juliannof/AITEC-17/docs/RS485_P4.md

# RS485 P4 — Bus A Master (ESP32-P4)

> ⚠️ **Pinout localizado, PENDIENTE de testear en banco** (2026-07-30) — ver §1.2. `config.h` todavía tiene los valores heredados de la placa antigua, sin actualizar.

Documentación del subsistema RS485 en P4. Bus A controla hasta 9 slaves S2 locales (IDs 1–9) — el usuario ya conectó físicamente los 9×S2 al bus A.

**Responsable:** iMakie Development Team  
**Última actualización:** 2026-07-30  
**Estado:** ⚠️ Pinout real localizado (sin testear), código sin adaptar — `rs485.startTask()` no llamada en setup (ver CHANGELOG pendientes)

---

## 1. HARDWARE RS485 P4

### 1.1 Especificación Bus A

| Parámetro | Valor |
|---|---|
| **Baudrate** | 500 kbaud |
| **Protocolo** | Binario custom CRC8 |
| **Topología** | Star — P4 master, 9 slaves S2 (IDs 1–9) |
| **Transceiver** | Externo (no integrado en P4) |
| **Timeout** | 1000ms sin RX → flag NOT_CALIBRATED |

### 1.2 Pinout P4

> ✅ **Localizado en hardware real (2026-07-30): A = GPIO26, B = GPIO27.** Confirmado que GPIO27 NO coincide con `LCD_RST_PIN` (también 27 en `config.h`, pero es un GPIO distinto del ESP32-P4 — la coincidencia numérica era del conector/serigrafía, no del chip). **Pendiente: testear comunicación real en banco** — la localización es correcta pero aún no se ha probado un ciclo TX/RX completo con un S2.
>
> `config.h` **todavía no se ha actualizado** con estos valores — sigue con `RS485_TX_PIN=52 / RX=51 / EN=50` heredados de la placa antigua JC4880P433C. Cambio de código pendiente de sesión propia (regla CLAUDE.md: validación en banco antes de tocar RS485).
>
> **Transceiver auto-direccional — sin pin DE/RE:** a diferencia del bus B (S3), donde el transceiver necesita `RS485_ENABLE_PIN` para conmutar TX/RX por software, el transceiver de la JC1060P470C conmuta la dirección automáticamente. El código actual de `P4/RS485.cpp` (`begin()`, `_sendPacket()`) usa `RS485_ENABLE_PIN` en 4 puntos — habrá que adaptarlo para no tocar ningún pin de enable en el bus A cuando se porte el pinout real (el bus B en S3 no se toca, sigue necesitando su enable).

```
RS485 (Bus A) — pinout localizado, sin testear (2026-07-30):
  A = GPIO26
  B = GPIO27
  (sin pin DE/RE — transceiver auto-direccional)

config.h actual (sin actualizar, heredado de placa antigua):
  TX = GPIO52  (RS485_TX_PIN)
  RX = GPIO51  (RS485_RX_PIN)
  EN = GPIO50  (RS485_ENABLE_PIN) — a eliminar cuando se porte el pinout real
```

**Diferencia vs Bus B (S3):**
- Bus A: hasta 9 slaves (P4 master) — `NUM_SLAVES=0` en config.h pendiente de ajuste, pinout localizado sin testear, sin pin de enable (auto-direccional)
- Bus B: 8 slaves (S3 Extender master), con `RS485_ENABLE_PIN` propio
- Ambos: 500 kbaud, mismo protocolo binario

---

## 2. PROTOCOLO

### 2.1 MasterPacket (P4 → S2)

```cpp
struct MasterPacket {
    uint8_t start_byte;           // 0xAA
    uint8_t slave_id;             // 1-9 (bus A)
    char track_name[8];           // Nombre track
    uint16_t fader_target;        // Target ADC (0-27000)
    uint8_t vu_level;             // VU level
    uint8_t flags;                // CALIB, REC, SOLO, MUTE, SELECT
    uint8_t crc8;                 // CRC8 (poly 0x07)
};
```

### 2.2 SlavePacket (S2 → P4)

```cpp
struct SlavePacket {
    uint8_t start_byte;           // 0xBB
    uint8_t slave_id;             // 1-9
    uint16_t fader_pos;           // Posición actual ADC
    uint8_t buttons;              // Bits 0-3: REC/SOLO/MUTE/SELECT
    int8_t encoder_delta;         // Encoder delta
    uint8_t encoder_button;       // Encoder push
    uint8_t flags;                // CALIB_DONE, CALIB_SENDING, etc
    uint8_t crc8;                 // CRC8
};
```

---

## 3. TIMING BUS A

### 3.1 Ciclo 20ms

```
T=0ms:      P4 envía MasterPacket a S2-1 (ID=1)
T≈150µs:    S2-1 envía SlavePacket
T=600µs:    P4 envía MasterPacket a S2-2 (ID=2)
T≈750µs:    S2-2 envía SlavePacket
...
T≈13.2ms:   P4 envía MasterPacket a S2-9 (ID=9)
T≈13.35ms:  S2-9 envía SlavePacket
T≈20ms:     Ciclo repite
```

**Timing critical:**
- TX_EN: 30µs
- RESP_TIMEOUT: 3000µs (3ms)
- GAP entre slaves: 300µs
- POLL_CYCLE: ~20ms

---

## 4. DIFERENCIAS BUS A vs BUS B

| Aspecto | Bus A (P4) | Bus B (S3) |
|---|---|---|
| **GPIO TX** | 52 (sin confirmar) | 15 |
| **GPIO RX** | 51 (sin confirmar) | 16 |
| **GPIO EN** | 50 (sin confirmar) | 1 |
| **Slaves** | 9 objetivo (NUM_SLAVES=0 actual) | 8 (IDs 1–8) |
| **Baudrate** | 500 kbaud | 500 kbaud |
| **Protocolo** | Mismo binario CRC8 | Mismo binario CRC8 |
| **Master** | P4 | S3 Extender |

**Ventaja arquitectónica:** 
- Dos buses independientes → mayor throughput total
- P4 + S3 ambos son masters (no jerarquía)
- Cada bus maneja sus 9/8 slaves sin interferencia

---

## 5. TROUBLESHOOTING

### 5.1 Síntomas Comunes

| Síntoma | Causa Probable | Verificación |
|---|---|---|
| RS485 no comunica | GPIO TX/RX/EN no configurados | Verificar setup P4 UART2 |
| Timeouts frecuentes | Cable RS485 cortado o soldadura floja | Verificar continuidad A/B |
| CRC8 errors | Ruido en línea | Verificar terminación 120Ω |
| Un slave no responde | S2 offline o RS485 chip defectuoso | Test con multimetro |
| Todos los slaves timeout | Master P4 no envía | Verificar UART TX pin |

### 5.2 Debugging

**Logs esperados — ciclo normal:**
```
[RS485-A] TX MasterPacket a S2-1
[RS485-A] RX SlavePacket desde S2-1 (faderPos=1234)
[RS485-A] TX MasterPacket a S2-2
[RS485-A] RX SlavePacket desde S2-2 (faderPos=5678)
...
[RS485-A] Ciclo completado (9 slaves, 20ms)
```

---

## 6. REFERENCIAS

- **RS485.md** — Protocolo binario completo (aplica ambos buses)
- **S3 RS485.md** — Bus B (S3 Extender), diferencias anotadas
- **P4 README:** [MASTER_S3-P4/P4/README.md](../MASTER_S3-P4/P4/README.md)
- **STATUS.md** — Bugs conocidos P4/Bus A

---

## Últimas Actualizaciones

- **(2026-06-11)** Advertencia pines pendientes, NUM_SLAVES corrección, estado del subsistema actualizado
- **(2026-05-16)** Creado RS485_P4.md como documento Bus A-específico, extraído de CLAUDE.md
