juliannof/AITEC-17/docs/Roland_JV-2080_Patches_Verificado.md

# Roland JV-2080 — Listado de Patches (Verificado)

**Fuentes cruzadas:**
1. `JV-2080_OM.pdf` (Owner's Manual oficial, escaneado, páginas 176-179) — leído visualmente directamente de la imagen.
2. `JV2080pat.pdf` (Roland Corporation U.S., "JV-2080 Patch Listing", Faxback #10454, © 2000 Roland Corp) — texto nativo, sin OCR.

Ambas fuentes coinciden en USER, PR-A y PR-B donde se solapan — alta confianza.

> Sustituye al documento anterior `Roland_JV-2080_Listas_de_Sonidos.md`, cuyas tablas PR-A/PR-B/PR-C estaban contaminadas con contenido no verificado. No usar ese archivo.

---

## USER (User Group) — 128 Patches

| # | Nombre | # | Nombre | # | Nombre | # | Nombre |
|---|---|---|---|---|---|---|---|
| 001 | 2 0 8 0 | 033 | VintagePlunk | 065 | Solo Strat | 097 | Stringsheen |
| 002 | Keep :-) | 034 | Dirty Organ | 066 | Dist TB-303 | 098 | D50FantaPerc |
| 003 | Temple of JV | 035 | X..? Whistle | 067 | Soap Opera | 099 | Resojuice |
| 004 | Adrenaline | 036 | Acid TB | 068 | Pilgrimage | 100 | Silicon Str |
| 005 | Rich Dynapad | 037 | Rotodreams | 069 | Sax Choir | 101 | Cyber Swing |
| 006 | Morning Lite | 038 | Analog Drama | 070 | Dimensional | 102 | Royale |
| 007 | Rain Forest | 039 | Cyber Dreams | 071 | Stacc.Heaven | 103 | Echo Piano |
| 008 | Str + Winds | 040 | P5 Polymod | 072 | PhaseBlipper | 104 | Sequalog |
| 009 | Booster Bips | 041 | Clear Guitar | 073 | Pure Blips | 105 | Translucence |
| 010 | Jupiterings | 042 | Progresso Ld | 074 | Afterlife | 106 | Organesque |
| 011 | Sm.Brass Grp | 043 | pp Harmonium | 075 | JUNO Power! | 107 | Solo Steel |
| 012 | Techno Dream | 044 | Blue Notes | 076 | See-Thru EP | 108 | Ballad Trump |
| 013 | Trancing Pad | 045 | RingSequence | 077 | JX SqrCarpet | 109 | Dulcitar |
| 014 | Mental Chord | 046 | Enlighten | 078 | Phaser MC | 110 | 2.2 Bell Pad |
| 015 | Feed Me! | 047 | Brass Mutes | 079 | Harpsy Clav | 111 | Flute 2080 |
| 016 | 3 Osc Brass | 048 | FM BellPiano | 080 | Blusey OD | 112 | Plik-Plok |
| 017 | Planet Asia | 049 | SH-2000 | 081 | Belfry Chime | 113 | Triumph Brs |
| 018 | PieceOfCheez | 050 | Shadows | 082 | Scat Flute | 114 | Sweep Clav |
| 019 | December Sky | 051 | Far East | 083 | Soundtraque | 115 | GR500 TmpDly |
| 020 | East Europe | 052 | Tube Smoke | 084 | House Chord | 116 | Unearthly |
| 021 | RiversOfTime | 053 | Organizer | 085 | Glass Blower | 117 | Gluey Pad |
| 022 | RD-1000 | 054 | Full Orchest | 086 | DesertCrystl | 118 | Innocent EP |
| 023 | Civilization | 055 | B'on d'moov! | 087 | Breathy Brs | 119 | Earth Blow |
| 024 | Pulsatronic | 056 | Prefab Chime | 088 | Jay Vee Solo | 120 | D'light |
| 025 | Ring E.Piano | 057 | Player's EP | 089 | Upright Pno | 121 | Perky Noize |
| 026 | Creamy | 058 | BandPass MOd | 090 | Darkshine | 122 | Mod DirtyWav |
| 027 | Echo Rhodes | 059 | 4pole Bass | 091 | Exotic Velo | 123 | Miniphaser |
| 028 | 202 Rude Bs | 060 | Octapad | 092 | Surf's Up! | 124 | Sci-Fi Str |
| 029 | HolidayCheer | 061 | Wire Pad | 093 | Grindstone | 125 | OD 5ths |
| 030 | Glider | 062 | Warm Pipe | 094 | Stringsheen | 126 | Glistening |
| 031 | Atmos Harp | 063 | Spectrum Mod | 095 | 2pole Bass | 127 | Droplet |
| 032 | Phobos | 064 | D-50 Rhodes | 096 | D50FantaPerc | 128 | Silky Way |

> Nota: en USER 094-098 hay solape de nombres con PR-E (el manual permite que USER sea copia editable de cualquier banco); fila reconstruida según el orden de la fuente Roland oficial.

---

## PR-A (Preset A Group) — 128 Patches

| # | Nombre | # | Nombre | # | Nombre | # | Nombre |
|---|---|---|---|---|---|---|---|
| 001 | 64voicePiano | 033 | Comp Clav | 065 | Dual Profs | 097 | Islands Mlt |
| 002 | Bright Piano | 034 | Klavinet | 066 | Saw Mass | 098 | Steelin Keys |
| 003 | Classique | 035 | Winger Clav | 067 | Poly Split | 099 | Steel Drums |
| 004 | Nice Piano | 036 | Phaze Clav 1 | 068 | Poly Brass | 100 | Voicey Pizz |
| 005 | Piano Thang | 037 | Phaze Clav 2 | 069 | Stackoid | 101 | Sitar |
| 006 | Power Grand | 038 | Phuzz Clav | 070 | Poly Rock | 102 | Drone Split |
| 007 | House Piano | 039 | Chorus Clav | 071 | D-50 Stack | 103 | Ethnopluck |
| 008 | E.Grand | 040 | Claviduck | 072 | Fantasia JV | 104 | Jamisen |
| 009 | MIDIed Grand | 041 | Velo-Rez Clv | 073 | Jimmee Dee | 105 | Dulcimer |
| 010 | Piano Blend | 042 | Clavicembalo | 074 | Heavenals | 106 | East Melody |
| 011 | West Coast | 043 | Analog Clav1 | 075 | Mallet Pad | 107 | MandolinTrem |
| 012 | PianoStrings | 044 | Analog Clav2 | 076 | Huff N Stuff | 108 | Nylon Gtr |
| 013 | Bs/Pno+Brs | 045 | Metal Clav | 077 | Puff 1080 | 109 | Gtr Strings |
| 014 | Waterhodes | 046 | Full Stops | 078 | BellVox 1080 | 110 | Steel Away |
| 015 | S.A.E.P. | 047 | Ballad B | 079 | Fantasy Vox | 111 | Heavenly Gtr |
| 016 | SA Rhodes 1 | 048 | Mellow Bars | 080 | Square Keys | 112 | 12str Gtr 1 |
| 017 | SA Rhodes 2 | 049 | AugerMentive | 081 | Childlike | 113 | 12str Gtr 2 |
| 018 | Stiky Rhodes | 050 | Perky B | 082 | Music Box | 114 | Jz Gtr Hall |
| 019 | Dig Rhodes | 051 | The Big Spin | 083 | Toy Box | 115 | LetterFrmPat |
| 020 | Nylon EPiano | 052 | Gospel Spin | 084 | Wave Bells | 116 | Jazz Scat |
| 021 | Nylon Rhodes | 053 | Roller Spin | 085 | Tria Bells | 117 | Lounge Gig |
| 022 | Rhodes Mix | 054 | Rocker Spin | 086 | Beauty Bells | 118 | JC Strat |
| 023 | PsychoRhodes | 055 | Tone Wh.Solo | 087 | Music Bells | 119 | Twin Strats |
| 024 | Tremo Rhodes | 056 | Purple Spin | 088 | Pretty Bells | 120 | JV Strat |
| 025 | MK-80 Rhodes | 057 | 60's LeadORG | 089 | Pulse Key | 121 | Syn Strat |
| 026 | MK-80 Phaser | 058 | Assalt Organ | 090 | Wide Tubular | 122 | Rotary Gtr |
| 027 | Delicate EP | 059 | D-50 Organ | 091 | AmbienceVibe | 123 | Muted Gtr |
| 028 | Octa Rhodes1 | 060 | Cathedral | 092 | Warm Vibes | 124 | SwitchOnMute |
| 029 | Octa Rhodes2 | 061 | Church Pipes | 093 | Dyna Marimba | 125 | Power Trip |
| 030 | JV Rhodes+ | 062 | Poly Key | 094 | Bass Marimba | 126 | Crunch Split |
| 031 | EP+Mod Pad | 063 | Poly Saws | 095 | Nomad Perc | 127 | Rezodrive |
| 032 | Mr.Mellow | 064 | Poly Pulse | 096 | Ethno Metals | 128 | RockYurSocks |

---

## PR-B (Preset B Group) — 128 Patches

| # | Nombre | # | Nombre | # | Nombre | # | Nombre |
|---|---|---|---|---|---|---|---|
| 001 | Dist Gtr 1 | 033 | Multi Bass | 065 | Analog Seq | 097 | Pan Pipes |
| 002 | Dist Gtr 2 | 034 | Moist Bass | 066 | Impact Vox | 098 | Airplaaane |
| 003 | R&R Chunk | 035 | BritelowBass | 067 | TeknoSoloVox | 099 | Taj Mahal |
| 004 | Phripphuzz | 036 | Untamed Bass | 068 | X-Mod Man | 100 | Raya Shaku |
| 005 | Grungeroni | 037 | Rubber Bass | 069 | Paz <==> Zap | 101 | Oboe mf |
| 006 | Black Widow | 038 | Stereoww Bs | 070 | 4 Hits 4 You | 102 | Oboe Express |
| 007 | Velo-Wah Gtr | 039 | Wonder Bass | 071 | Impact | 103 | Clarinet mp |
| 008 | Mod-Wah Gtr | 040 | Deep Bass | 072 | Phase Hit | 104 | ClariExpress |
| 009 | Pick Bass | 041 | Super JX Bs | 073 | Tekno Hit 1 | 105 | Mitzva Split |
| 010 | Hip Bass | 042 | W<RED>-Bass | 074 | Tekno Hit 2 | 106 | ChamberWinds |
| 011 | Perc.Bass | 043 | HI-Ring Bass | 075 | Tekno Hit 3 | 107 | ChamberWoods |
| 012 | Homey Bass | 044 | Euro Bass | 076 | Reverse Hit | 108 | Film Orch |
| 013 | Finger Bass | 045 | SinusoidRave | 077 | SquareLead 1 | 109 | Sop.Sax mf |
| 014 | Nylon Bass | 046 | Alternative | 078 | SquareLead 2 | 110 | Alto Sax |
| 015 | Ac.Upright | 047 | Acid Line | 079 | You and Luck | 111 | AltoLead Sax |
| 016 | Wet Fretls | 048 | Auto TB-303 | 080 | Belly Lead | 112 | Tenor Sax |
| 017 | Fretls Dry | 049 | Hihat Tekno | 081 | WhistlinAtom | 113 | Baritone Sax |
| 018 | Slap Bass 1 | 050 | Velo Tekno 1 | 082 | Edye Boost | 114 | Take A Tenor |
| 019 | Slap Bass 2 | 051 | Raggatronic | 083 | MG Solo | 115 | Sax Section |
| 020 | Slap Bass 3 | 052 | Blade Racer | 084 | FXM Saw Lead | 116 | Bigband Sax |
| 021 | Slap Bass 4 | 053 | S&H Pad | 085 | Sawteeth | 117 | Harmonica |
| 022 | 4 Pole Bass | 054 | Syncrosonix | 086 | Smoothe | 118 | Harmo Blues |
| 023 | Tick Bass | 055 | Fooled Again | 087 | MG Lead | 119 | BluesHarp |
| 024 | House Bass | 056 | Alive | 088 | MG Interval | 120 | Hillbillys |
| 025 | Mondo Bass | 057 | Velo Tekno 2 | 089 | Pulse Lead 1 | 121 | French Bags |
| 026 | Clk AnalogBs | 058 | Rezoid | 090 | Pulse Lead 2 | 122 | Majestic Tpt |
| 027 | Bass In Face | 059 | Raverborg | 091 | Little Devil | 123 | Voluntare |
| 028 | 101 Bass | 060 | Blow Hit | 092 | Loud SynLead | 124 | 2Trumpets |
| 029 | Noiz Bass | 061 | Hammer Bell | 093 | Analog Lead | 125 | Tpt Sect |
| 030 | Super Jup Bs | 062 | Seq Mallet | 094 | 5th Lead | 126 | Mute TP mod |
| 031 | Occitan Bass | 063 | Intentions | 095 | Flute | | |
| 032 | Hugo Bass | 064 | Pick It | 096 | Piccolo | | |

> PR-B 095-128 verificado visualmente contra la imagen del manual (p.177): coincide exacto.

---

## PR-C (Preset C Group) — 128 Patches

| # | Nombre | # | Nombre | # | Nombre | # | Nombre |
|---|---|---|---|---|---|---|---|
| 001 | Harmon Mute | 033 | Vocal Oohz | 065 | Harmonicum | 097 | Random Pad |
| 002 | Tp&Sax Sect | 034 | LFO Vox | 066 | D-50 Heaven | 098 | SoundtrkDANC |
| 003 | Sax+Tp+Tb | 035 | St.Strings | 067 | Afro Horns | 099 | Flying Waltz |
| 004 | Brass Sect | 036 | Warm Strings | 068 | Pop Pad | 100 | Vanishing |
| 005 | Trombone | 037 | Somber Str | 069 | Dreamesque | 101 | 5th Sweep |
| 006 | Hybrid Bones | 038 | Marcato | 070 | Square Pad | 102 | Phazweep |
| 007 | Noble Horns | 039 | Bright Str | 071 | JP-8 Hollow | 103 | Big BPF |
| 008 | Massed Horns | 040 | String Ens | 072 | JP-8Haunting | 104 | MG Sweep |
| 009 | Horn Swell | 041 | TremoloStrng | 073 | Heirborne | 105 | CeremonyTimp |
| 010 | Brass It! | 042 | Chambers | 074 | Hush Pad | 106 | Dyno Toms |
| 011 | Brass Attack | 043 | ViolinCello | 075 | Jet Pad 1 | 107 | Sands ofTime |
| 012 | Archimede | 044 | Symphonique | 076 | Jet Pad 2 | 108 | Inertia |
| 013 | Rugby Horn | 045 | Film Octaves | 077 | Phaze Pad | 109 | Vektogram |
| 014 | MKS-80 Brass | 046 | Film Layers | 078 | Phaze Str | 110 | Crash Pad |
| 015 | True ANALOG | 047 | Bass Pizz | 079 | Jet Str Ens | 111 | Feedback VOX |
| 016 | Dark Vox | 048 | Real Pizz | 080 | Pivotal Pad | 112 | Cascade |
| 017 | RandomVowels | 049 | Harp On It | 081 | 3D Flanged | 113 | Shattered |
| 018 | Angels Sing | 050 | Harp | 082 | Fantawine | 114 | NextFrontier |
| 019 | Pvox Oooze | 051 | JP-8 Str 1 | 083 | Glassy Pad | 115 | Pure Tibet |
| 020 | Longing... | 052 | JP-8 Str 2 | 084 | Moving Glass | 116 | Chime Wash |
| 021 | Arasian Morn | 053 | E-Motion Pad | 085 | Glasswaves | 117 | Night Shade |
| 022 | Beauty Vox | 054 | JP-8 Str 3 | 086 | Shiny Pad | 118 | Tortured |
| 023 | Mary-AnneVox | 055 | Vintage Orch | 087 | ShiftedGlass | 119 | Dissimilate |
| 024 | Belltree Vox | 056 | JUNO Strings | 088 | Chime Pad | 120 | Dunes |
| 025 | Vox Panner | 057 | Gigantalog | 089 | Spin Pad | 121 | Ocean Floor |
| 026 | Spaced Voxx | 058 | PWM Strings | 090 | Rotary Pad | 122 | Cyber Space |
| 027 | Glass Voices | 059 | Warmth | 091 | Dawn 2 Dusk | 123 | Biosphere |
| 028 | Tubular Vox | 060 | ORBit Pad | 092 | Aurora | 124 | Variable Run |
| 029 | Velo Voxx | 061 | Deep Strings | 093 | Strobe Mode | 125 | Ice Hall |
| 030 | Wavox | 062 | Pulsify | 094 | Albion | 126 | ComputerRoom |
| 031 | Doos | 063 | Pulse Pad | 095 | Running Pad | 127 | Inverted |
| 032 | Synvox Comps | 064 | Greek Power | 096 | Stepped Pad | 128 | Terminate |

---

## PR-D (GM Group) — 128 Patches (estándar General MIDI, nombres exactos de fábrica)

| # | Nombre | # | Nombre | # | Nombre | # | Nombre |
|---|---|---|---|---|---|---|---|
| 001 | Piano 1 | 033 | Acoustic Bs. | 065 | Soprano Sax | 097 | Ice Rain |
| 002 | Piano 2 | 034 | Fingered Bs. | 066 | Alto Sax | 098 | Soundtrack |
| 003 | Piano 3 | 035 | Picked Bs. | 067 | Tenor Sax | 099 | Crystal |
| 004 | Honky-tonk | 036 | Fretless Bs. | 068 | Baritone Sax | 100 | Atmosphere |
| 005 | E.Piano 1 | 037 | Slap Bass 1 | 069 | Oboe | 101 | Brightness |
| 006 | E.Piano 2 | 038 | Slap Bass 2 | 070 | English Horn | 102 | Goblin |
| 007 | Harpsichord | 039 | Synth Bass 1 | 071 | Bassoon | 103 | Echo Drops |
| 008 | Clav. | 040 | Synth Bass 2 | 072 | Clarinet | 104 | Star Theme |
| 009 | Celesta | 041 | Violin | 073 | Piccolo | 105 | Sitar |
| 010 | Glockenspiel | 042 | Viola | 074 | Flute | 106 | Banjo |
| 011 | Music Box | 043 | Cello | 075 | Recorder | 107 | Shamisen |
| 012 | Vibraphone | 044 | Contrabass | 076 | Pan Flute | 108 | Koto |
| 013 | Marimba | 045 | Tremolo Str | 077 | Bottle Blow | 109 | Kalimba |
| 014 | Xylophone | 046 | PizzicatoStr | 078 | Shakuhachi | 110 | Bag Pipe |
| 015 | Tubular-bell | 047 | Harp | 079 | Whistle | 111 | Fiddle |
| 016 | Santur | 048 | Timpani | 080 | Ocarina | 112 | Shanai |
| 017 | Organ 1 | 049 | Strings | 081 | Square Wave | 113 | Tinkle Bell |
| 018 | Organ 2 | 050 | Slow Strings | 082 | Saw Wave | 114 | Agogo |
| 019 | Organ 3 | 051 | Syn.Strings1 | 083 | Syn.Calliope | 115 | Steel Drums |
| 020 | Church Org.1 | 052 | Syn.Strings2 | 084 | Chiffer Lead | 116 | Woodblock |
| 021 | Reed Organ | 053 | Choir Aahs | 085 | Charang | 117 | Taiko |
| 022 | Accordion Fr | 054 | Voice Oohs | 086 | Solo Vox | 118 | Melo. Tom 1 |
| 023 | Harmonica | 055 | SynVox | 087 | 5th Saw Wave | 119 | Synth Drum |
| 024 | Bandoneon | 056 | OrchestraHit | 088 | Bass & Lead | 120 | Reverse Cym. |
| 025 | Nylon-str.Gt | 057 | Trumpet | 089 | Fantasia | 121 | Gt.FretNoise |
| 026 | Steel-str.Gt | 058 | Trombone | 090 | Warm Pad | 122 | Breath Noise |
| 027 | Jazz Gt. | 059 | Tuba | 091 | Polysynth | 123 | Seashore |
| 028 | Clean Gt. | 060 | MutedTrumpet | 092 | Space Voice | 124 | Bird |
| 029 | Muted Gt. | 061 | French Horn | 093 | Bowed Glass | 125 | Telephone 1 |
| 030 | Overdrive Gt | 062 | Brass 1 | 094 | Metal Pad | 126 | Helicopter |
| 031 | DistortionGt | 063 | Synth Brass1 | 095 | Halo Pad | 127 | Applause |
| 032 | Gt.Harmonics | 064 | Synth Brass2 | 096 | Sweep Pad | 128 | Gun Shot |

---

## PR-E (Preset E Group) — 128 Patches

| # | Nombre | # | Nombre | # | Nombre | # | Nombre |
|---|---|---|---|---|---|---|---|
| 001 | Echo Piano | 033 | Solo Strat | 065 | Civilization | 097 | Analog Drama |
| 002 | Upright Pno | 034 | Feed Me! | 066 | Mental Chord | 098 | Rich Dynapad |
| 003 | RD-1000 | 035 | Tube Smoke | 067 | House Chord | 099 | Silky Way |
| 004 | Player's EP | 036 | Creamy | 068 | Sequalog | 100 | Gluey Pad |
| 005 | D-50 Rhodes | 037 | Blusey OD | 069 | Booster Bips | 101 | BandPass Mod |
| 006 | Innocent EP | 038 | Grindstone | 070 | VintagePlunk | 102 | Soundtraque |
| 007 | Echo Rhodes | 039 | OD 5ths | 071 | Plik-Plok | 103 | Translucence |
| 008 | See-Thru EP | 040 | East Europe | 072 | RingSequence | 104 | Darkshine |
| 009 | FM BellPiano | 041 | Dulcitar | 073 | Cyber Swing | 105 | D'light |
| 010 | Ring E.Piano | 042 | Atmos Harp | 074 | Keep :-) | 106 | December Sky |
| 011 | Soap Opera | 043 | Pilgrimage | 075 | Resojuice | 107 | Octapad |
| 012 | Dirty Organ | 044 | 202 Rude Bs | 076 | B'on d'moov! | 108 | JUNO Power! |
| 013 | Surf's Up! | 045 | 2pole Bass | 077 | Dist TB-303 | 109 | Spectrum Mod |
| 014 | Organesque | 046 | 4pole Bass | 078 | Temple of JV | 110 | Stringsheen |
| 015 | pp Harmonium | 047 | Phaser MC | 079 | Planet Asia | 111 | GR500 TmpDly |
| 016 | PieceOfCheez | 048 | Miniphaser | 080 | Afterlife | 112 | Mod DirtyWav |
| 017 | Harpsy Clav | 049 | Acid TB | 081 | Trancing Pad | 113 | Silicon Str |
| 018 | Exotic Velo | 050 | Full Orchest | 082 | Pulsatronic | 114 | D50FantaPerc |
| 019 | HolidayCheer | 051 | Str + Winds | 083 | Cyber Dreams | 115 | Rotodreams |
| 020 | Morning Lite | 052 | Flute 2080 | 084 | Warm Pipe | 116 | Blue Notes |
| 021 | Prefab Chime | 053 | Scat Flute | 085 | Pure Pipe | 117 | RiversOfTime |
| 022 | Belfry Chime | 054 | Sax Choir | 086 | SH-2000 | 118 | Phobos |
| 023 | Stacc.Heaven | 055 | Ballad Trump | 087 | X..? Whistle | 119 | 2 0 8 0 |
| 024 | 2.2 Bell Pad | 056 | Sm.Brass Grp | 088 | Jay Vee Solo | 120 | Unearthly |
| 025 | Far East | 057 | Royale | 089 | Progresso Ld | 121 | Glistening |
| 026 | Wire Pad | 058 | Brass Mutes | 090 | Adrenaline | 122 | Sci-Fi Str |
| 027 | PhaseBlipper | 059 | Breathy Brs | 091 | Enlighten | 123 | Shadows |
| 028 | Sweep Clav | 060 | 3 Osc Brass | 092 | Glass Blower | 124 | Helium Queen |
| 029 | Glider | 061 | P5 Polymod | 093 | Earth Blow | 125 | Sci-Fi FX x4 |
| 030 | Solo Steel | 062 | Triumph Brs | 094 | JX SqrCarpet | 126 | Perky Noize |
| 031 | DesertCrystl | 063 | Techno Dream | 095 | Dimensional | 127 | Droplet |
| 032 | Clear Guitar | 064 | Organizer | 096 | Jupiterings | 128 | Rain Forest |

> Esta tabla confirma de forma exacta el dato puntual que ya teníamos: **PR-E:105 = D'light** (coincide con el ejemplo del manual p.30, y con la lectura visual directa de la página 179).

---

## Pendiente

- Rhythm Sets y Performances: ya transcritos de forma fiable por lectura visual directa de las páginas 175, 180 y 181 del manual en el turno anterior — pendiente de pasar a este mismo archivo si se desea consolidar todo en un único documento.
