juliannof/AITEC-17/MASTER_S3-P4/P4_JC1060P470C/src/config.h

// include/config.h — P4 versión mínima
#pragma once
#include <Arduino.h>

// ====================================================================
// CONFIGURACIÓN AUTOMÁTICA SEGÚN DISPOSITIVO
// ====================================================================
#if defined(DEVICE_P4_MASTER)
    #define DEVICE_FAMILY       0x14
    #define VERSION_REPLY_CMD   0x14
    #define NUM_SLAVES          6


#elif defined(DEVICE_S3_EXTENDER)
    #define DEVICE_FAMILY       0x15
    #define VERSION_REPLY_CMD   0x15
    #define NUM_SLAVES          1

#else
    #error "DEBE DEFINIR: DEVICE_P4_MASTER o DEVICE_S3_EXTENDER en platformio.ini build_flags"
#endif



// --- RS485 pines P4 ---
#define RS485_TX_PIN      3
#define RS485_RX_PIN      4
#define RS485_ENABLE_PIN  5
#define RS485_BAUD       500000

// ── Enlace serie P4↔S3 (Serial2, independiente del RS485 propio) (2026-08-16) ──
// TX/RX intercambiados (2026-08-16 20:31) respecto al plan original — el cable
// físico ya tendido conecta al revés; se corrige en firmware, no en hardware.
#define S3LINK_TX_PIN         1
#define S3LINK_RX_PIN         2
#define S3LINK_BAUD           115200
#define S3LINK_HEARTBEAT_MS   500
#define S3LINK_TIMEOUT_MS     1500

// ── Display JD9165 (MIPI-DSI, 1024×600 landscape nativo) (2026-06-09) ──
#define LCD_RST_PIN    27
#define LCD_BL_PIN     23
#define SPLASH_BRIGHTNESS_PERCENT  20   // Brillo reducido durante splash/offline (2026-08-19)
#define SPLASH_SCREEN_OFF_MS  120000    // Apaga backlight tras 2 min inactivo en splash (2026-08-19)

// ── Touch GT911 (I2C) — como la placa pequeña: RST/INT en NC (2026-06-09) ──
#define TOUCH_INT_PIN  -1
#define TOUCH_RST_PIN  -1
#define TOUCH_SDA_PIN  7
#define TOUCH_SCL_PIN  8
#define TOUCH_I2C_ADDR 0x5D

// NOTA: la JC1060P470C NO lleva NeoTrellis (defines TRELLIS_* eliminados 2026-06-09)

// ── Elevador de pantalla (motor N20 + DRV8833, EN/nSLEEP fijo a 5V por HW,
// sin GPIO de control; sin encoder/ADC — no hay lazo cerrado) (2026-09-12) ──
#define MOTOR_IN1          46
#define MOTOR_IN2          47
// ⚠️ PLACEHOLDER SIN CONFIRMAR contra el esquemático — mismo estado que los
// pines de RS485 bus A (ver docs/RS485_P4.md). Validar continuidad con
// multímetro antes de fiarse de este pin en hardware real.
#define LIMIT_SWITCH_PIN   45
#define LIMIT_SWITCH_ACTIVE_LEVEL LOW   // pulsado (retraído) = LOW, pull-up interno

#define ELEVATOR_HOMING_PWM_DEFAULT    40    // usado solo si no hay elevatorPwm en NVS
#define ELEVATOR_HOMING_TIMEOUT_MS     8000
#define ELEVATOR_TEST_PWM_START        40    // fallback si no hay elevatorPwm guardado
#define ELEVATOR_TEST_PWM_STEP         10
#define ELEVATOR_TEST_PWM_MIN          0
#define ELEVATOR_TEST_PWM_MAX          255
#define ELEVATOR_CALIB_TOLERANCE_PCT   15
#define ELEVATOR_PANEL_IDLE_TIMEOUT_MS 10000 // corte de seguridad: PWM sostenido en panel

// --- Timing RS485 ---
#define RS485_TX_ENABLE_US    10
#define RS485_TX_DONE_US      10
#define RS485_RESP_TIMEOUT_US 5000
#define RS485_GAP_US          300
#define POLL_CYCLE_MS         20
#define LOGIC_PITCHBEND_MAX   14845
#define BTN_PG1_COUNT         50

// ── Timing conexión Logic (handshake / detección de desconexión) (2026-08-18) ──
// Nota: MIDI_TIMEOUT_MS (timeout por silencio MIDI) se probó y se descartó el mismo
// día — Logic no garantiza tráfico periódico en reposo, generaba falsos positivos en
// banco. La desconexión física real se detecta con checkUsbLink() (tud_mounted()).
// DISCONNECT_THRESHOLD/WINDOW_MS: heurística legacy — infiere desconexión si N faders
// caen a 0 dentro de una ventana corta (sin 0x0F explícito de Logic).
#define DISCONNECT_THRESHOLD   9
#define DISCONNECT_WINDOW_MS   150
// CONNECT_GRACE_MS: tras pasar a CONNECTED, ignora la heurística de arriba durante este
// margen — evita que el burst de resync de faders tras el handshake dispare un falso positivo.
#define CONNECT_GRACE_MS       1500
// DISCONNECT_CONFIRM_WINDOW_MS (2026-08-18 20:26): firma real de cierre de Logic =
// faders-a-0 + 0x21 pegados. Logic manda GoOnline (0x21) unos ms después del burst
// de faders a 0 al cerrar la app — antes esto revertía la desconexión (case 0x21
// reconectaba siempre que el 0x21 llegara). Si el 0x21 llega dentro de esta ventana
// tras la heurística de faders, se interpreta como CONFIRMACIÓN del cierre, no como
// reconexión real.
#define DISCONNECT_CONFIRM_WINDOW_MS 500


// ── Dimensiones display (JD9165 1024×600 landscape nativo) (2026-06-09) ──
#define P4_W    1024
#define P4_H    600
#define NUM_CH  16
#define CH_H    (P4_H / NUM_CH)

// ── Layout landscape nativo 1024×600 (header arriba + 16 canales en columnas) ──
#define HEADER_H        88              // franja superior: timecode + modo BEAT/SMPT
#define ASSIGN_STRIP_H  22              // franja VPot assignment names (pie del header)
#define CONTENT_Y       (HEADER_H + ASSIGN_STRIP_H)  // inicio canales y=110
#define CONTENT_H       (P4_H - CONTENT_Y)           // alto canales 490px
#define CH_W        (P4_W / NUM_CH)     // 64px ancho por canal (columna)
#define P4_CH_OFFSET 8                  // slots 0-7=S3 (izq), 8-15=P4 nativo (der)

#define MENU_HAM_SIZE  44

// ── Colores UI P4 (LVGL lv_color_hex) — referencia Logic Pro (2026-06-11) ──
// Extraídos de captura Logic Pro con pantalla calibrada (junio 2026)
#define COL_BG            0x1A1A1A   // fondo general arrange
#define COL_BG_PANEL      0x1E1E1E   // panel inspector lateral
#define COL_BG_CELL       0x2A2A2A   // celda vacía / track inactiva
#define COL_TRACK_BG      0x222222   // cabecera canal (lista tracks)
#define COL_TRACK_SEL     0x3D3D3D   // track seleccionada (resaltado)
#define COL_TRACK_SEP     0x505050   // separador horizontal entre tracks
#define COL_BTN_INACTIVE  0x4A4A4A   // botones M/S/R/I off
#define COL_TEXT_DIM      0x999999   // texto secundario / etiquetas
#define COL_FADER_TRACK   0x606060   // ranura del fader
#define COL_FADER_THUMB   0x707070   // cabeza (thumb) del fader

// Colores funcionales
// ── Header — paleta aceptada: COL_HEADER* (azules) · COL_AUTO_LATCH (naranja) · COL_CLICK_ON (púrpura)
#define COL_HEADER        0x000050   // fondo strip
#define COL_HEADER_DIM    0x006666   // azul oscuro: indicadores inactivos, ghost timecode
#define COL_HEADER_BRIGHT 0x00FFFF   // azul claro: timecode activo, indicadores activos, borde SMPT/BEAT
#define COL_CLICK_ON      0xAA00CC   // púrpura: metrónomo activo
#define COL_MUTE_ON    0xFF0000
#define COL_MUTE_OFF   0x3A3A3A
#define COL_SOLO_ON    0xFFAA00
#define COL_SOLO_OFF   0x3A3A3A

// -- Automode
#define COL_AUTO_READ   0x006600
#define COL_AUTO_TOUCH  0x0000AA
#define COL_AUTO_LATCH  0xAA6600
#define COL_AUTO_WRITE  0xAA0000
#define COL_AUTO_OFF    0x333333

// NOTA: NUM_SLAVES se define una sola vez en el bloque DEVICE_* (arriba) (2026-06-09)

// --- Enums ---
enum class ConnectionState {
    DISCONNECTED,
    AWAITING_SESSION,
    MIDI_HANDSHAKE_COMPLETE,
    CONNECTED
};

enum DisplayMode { MODE_BEATS, MODE_SMPTE };

// --- Estado de conexión global ---
extern volatile ConnectionState logicConnectionState;
extern uint8_t g_logicConnected;
extern volatile bool g_s3Connected;  // true si el S3 respondió PONG dentro de S3LINK_TIMEOUT_MS (2026-08-16)

// --- Variables de display ---
extern String trackNames[16];
extern String vpotAssignNames[8];
extern bool recStates[16], soloStates[16], muteStates[16], selectStates[16];
extern uint8_t vpotValues[16];
extern float vuLevels[16];
extern bool vuClipState[16];
extern unsigned long vuLastUpdateTime[16];
extern float vuPeakLevels[16];
extern unsigned long vuPeakLastUpdateTime[16];
extern uint8_t vuPeakAlpha[16];
extern uint32_t vuPeakFadeTime[16];
extern bool vuDirty[16];  // per-canal: invalidar solo columnas VU cambiadas (2026-08-18)
extern float faderPositions[16];
extern bool needsTOTALRedraw;
extern bool needsMainAreaRedraw;
extern bool needsTimecodeRedraw;
extern bool needsButtonsRedraw;
extern bool needsVUMetersRedraw;
extern bool needsHeaderRedraw;
extern String assignmentString;
extern bool btnStatePG1[BTN_PG1_COUNT];
extern bool btnFlashPG1[BTN_PG1_COUNT];
extern bool rudeSoloActive;
extern bool cycleActive;
extern bool g_clickActive;
extern char timeCodeChars_clean[13];
extern char beatsChars_clean[13];
extern DisplayMode currentTimecodeMode;

extern volatile bool g_switchToPage3;
extern volatile uint8_t g_currentPage;  // 0=P3A 1=P1
extern volatile bool g_switchToPage3A;
extern volatile bool g_switchToOffline;
extern volatile bool g_sessionActive;
extern volatile bool g_switchToPage1;


// --- Mackie char map ---
const char MACKIE_CHAR_MAP[64] = {
    ' ','A','B','C','D','E','F','G','H','I','J','K','L','M','N','O',
    'P','Q','R','S','T','U','V','W','X','Y','Z','[','\\',']','^','_',
    ' ','!','"','#','$','%','&','\'','(',')','*','+',',','-','.','/',
    '0','1','2','3','4','5','6','7','8','9',':',';','<','=','>','?'
};

static const uint32_t PALETTE_HEX[9] = {
    0x000000,  // 0: off
    0xFF0000,  // 1: rojo
    0x00BB00,  // 2: verde
    0x0000FF,  // 3: azul
    0xFFFF00,  // 4: amarillo
    0x00CCCC,  // 5: cian
    0xCC00CC,  // 6: magenta/lila
    0xDDDDDD,  // 7: blanco
    0xFF6600,  // 8: naranja
};
static const char* LABELS_PG1[BTN_PG1_COUNT] = {
    "TRACK","SEND", "PAN",  "PLUG", "EQ",   "INST", "BANK<","BANK>","CH<",  "CH>",
    "F1",   "F2",   "F3",   "F4",   "F5",   "F6",   "F7",   "F8",   "FLIP", "GLOB",
    "BOUNCE","INP", "ATRC", "AINST","AUX",  "BUS",  "OUT",  "USR",  "ZOOM", "SCRUB",
    "READ", "WRITE","TRIM", "TOUCH","LATCH","GROUP", "SAVE", "UNDO", "CNCL", "ENTER",
    "MARK", "NUDGE","DROP", "RPLC", "UP",   "DOWN", "LEFT", "RIGHT","NAME", ""
};

static const uint8_t BTN_COLOR_IDX[BTN_PG1_COUNT] = {
    5, 5, 5, 5, 5, 5, 3, 3, 3, 3,
    7, 7, 7, 7, 7, 7, 7, 7, 6, 6,
    5, 5, 5, 5, 5, 5, 5, 5, 3, 3,
    2, 6, 8, 3, 8, 5, 2, 6, 6, 2,
    4, 4, 4, 4, 3, 3, 3, 3, 5, 0
};

// --- Notas MIDI (página única 10×5) ---
static const byte MIDI_NOTES_PG1[BTN_PG1_COUNT] = {
    0x28,0x29,0x2A,0x2B,0x2C,0x2D,0x2E,0x2F,0x30,0x31,  // row 0: assignment + bank/ch
    0x36,0x37,0x38,0x39,0x3A,0x3B,0x3C,0x3D,0x32,0x33,  // row 1: F1-F8 + flip/glob
    0x3E,0x3F,0x40,0x41,0x42,0x43,0x44,0x45,0x64,0x65,  // row 2: global view + zoom/scrub
    0x4A,0x4B,0x4C,0x4D,0x4E,0x4F,0x50,0x51,0x52,0x53,  // row 3: automation + utilities
    0x54,0x55,0x57,0x58,0x60,0x61,0x62,0x63,0x34,0x00   // row 4: edit + nav + name
};
