juliannof/AITEC-17/S2/S2_V1/src/display/Display.cpp

// src/display/Display.cpp
#include <Arduino.h>
#include "Display.h"
#include "hardware/encoder/Encoder.h"
#include "../hardware/Hardware.h"
#include "../hardware/Motor/Motor.h"
#include "../hardware/Neopixels/Neopixel.h"
#include <Preferences.h>
#include "SpriteUtils.h"           // en Display.cpp
#include "../config.h"
// #include "../nvs/NVSValidator.h"  // DESACTIVADO

extern LGFX        tft;
extern LGFX_Sprite header;
extern LGFX_Sprite mainArea;
extern LGFX_Sprite vPotSprite;

static uint8_t _trackId = 0;

namespace {
    uint8_t screenBrightness = 255;
}

void drawMainArea();
void drawVUMeters();
void drawHeaderSprite();
void drawOfflineScreen();
void drawInitializingScreen();
void drawVPotDisplay();
void drawButton(LGFX_Sprite &sprite, uint16_t x, uint16_t y, uint16_t w, uint16_t h, const char* label, bool active, uint16_t activeColor);
void setTrackId(uint8_t id) { _trackId = id; }


bool needsTOTALRedraw    = true;
bool needsMainAreaRedraw = false;
bool needsHeaderRedraw   = false;
bool needsVUMetersRedraw = false;
bool needsVPotRedraw     = false;
volatile ConnectionState logicConnectionState = ConnectionState::DISCONNECTED;


static uint8_t currentVPotRaw = 0;
static int8_t currentVPotLevel = VPOT_DEFAULT_LEVEL;
AutoMode currentAutoMode = AUTO_READ;   // default boot: READ, no OFF (2026-07-30)

// ════════════════════════════════════════════════════════════
//  initDisplay
// ════════════════════════════════════════════════════════════
void initDisplay(bool otaOnlyMode) {
    esp_reset_reason_t reason = esp_reset_reason();
    Serial.printf("Reset reason: %d\n", (int)reason);

    // Pulso de reset obligatorio GPIO33 antes de tft.init()
    pinMode(33, OUTPUT);
    digitalWrite(33, LOW);
    delay(100);
    digitalWrite(33, HIGH);
    delay(50);

    tft.init();
    tft.setRotation(0);
    tft.setBrightness(screenBrightness);
    tft.fillScreen(TFT_BG_COLOR);

    // En OTA-only mode, NO crear sprites para liberar heap
    if (!otaOnlyMode) {
        mainArea.setColorDepth(16);
        mainArea.setPsram(true);
        mainArea.createSprite(MAINAREA_WIDTH, MAINAREA_HEIGHT);

        header.setColorDepth(16);
        header.setPsram(true);
        header.createSprite(TFT_WIDTH, HEADER_HEIGHT);

        vPotSprite.setColorDepth(16);
        vPotSprite.setPsram(true);
        vPotSprite.createSprite(TFT_WIDTH, VPOT_HEIGHT);
    }

    Serial.printf("tft       : %d x %d\n", tft.width(), tft.height());
    Serial.printf("header    : %d x %d  → pushSprite(0, 0)\n",   header.width(),   header.height());
    Serial.printf("mainArea  : %d x %d  → pushSprite(0, %d)\n",  mainArea.width(),  mainArea.height(), HEADER_HEIGHT);
    Serial.printf("vPotSprite: %d x %d  → pushSprite(0, %d)\n",  vPotSprite.width(),vPotSprite.height(), MAINAREA_HEIGHT + HEADER_HEIGHT);
    Serial.printf("Layout total: %d px alto (pantalla: %d)\n", HEADER_HEIGHT + MAINAREA_HEIGHT + VPOT_HEIGHT, tft.height());

    setVPotLevel(VPOT_DEFAULT_LEVEL);

    Serial.printf("header     creado: %s\n", header.width()    > 0 ? "OK" : "FALLO");
    Serial.printf("mainArea   creado: %s\n", mainArea.width()  > 0 ? "OK" : "FALLO");
    Serial.printf("vPotSprite creado: %s\n", vPotSprite.width()> 0 ? "OK" : "FALLO");
    Serial.printf("Heap libre:  %u bytes\n", ESP.getFreeHeap());
    Serial.printf("PSRAM libre: %u bytes\n", ESP.getFreePsram());
    Serial.println("[SETUP] Display iniciado - LovyanGFX");

    _logSpriteAlloc("header",    header);
    _logSpriteAlloc("mainArea",  mainArea);
    _logSpriteAlloc("vPotSprite",vPotSprite);

    needsTOTALRedraw = true;
}

// ════════════════════════════════════════════════════════════
//  setScreenBrightness / setVPotLevel
// ════════════════════════════════════════════════════════════
void setScreenBrightness(uint8_t brightness) {
    screenBrightness = brightness;
    tft.setBrightness(brightness);
}

// ════════════════════════════════════════════════════════════
//  drawCalibDot — punto de estado de calibración (2026-08-07)
// ════════════════════════════════════════════════════════════
// WHAT: dibuja solo el círculo verde/rojo de Motor::isCalibrated(), sin
//       tocar el resto de la pantalla. Extraído de drawSplashScreen() para
//       poder refrescar el punto en solitario desde updateDisplay() cuando
//       la calibración termina mientras la splash sigue visible.
void drawCalibDot() {
    uint16_t calibColor = Motor::isCalibrated() ? TFT_GREEN : TFT_RED;
    tft.fillCircle(TFT_WIDTH / 2, 232, 12, calibColor);

    // Valores reales MIN/MAX calibrados (2026-08-23) — diagnóstico visual del
    // rango que usa _pbToADC() en este canal, sin depender del monitor serie.
    // Debajo de la línea "PWM x-y" (Y=185), antes del punto de calibración (Y=232).
    tft.fillRect(0, 196, TFT_WIDTH, 22, TFT_BLACK);
    if (Motor::isCalibrated()) {
        tft.setFont(&fonts::FreeSans9pt7b);
        tft.setTextSize(0.9f);
        tft.setTextColor(TFT_GREEN);
        tft.setTextDatum(MC_DATUM);
        char calBuf[32];
        snprintf(calBuf, sizeof(calBuf), "MIN %u  MAX %u", Motor::getADCMin(), Motor::getADCMax());
        tft.drawString(calBuf, TFT_WIDTH / 2, 207);
        tft.setTextSize(1);  // restaurar tamaño normal para el resto de la UI
    }
}

// ════════════════════════════════════════════════════════════
//  drawSplashScreen
// ════════════════════════════════════════════════════════════

void drawSplashScreen() {
    // INSTRUMENTACIÓN micros() — BRIEF A extendido (2026-08-20). Separa coste
    // de acceso NVS (Preferences) del coste de renderizado de fuentes.
    uint32_t _tsAll = micros();

    uint32_t _ts0 = micros();
    Preferences prefs;
    prefs.begin("ptxx", true);
    uint8_t trackId = prefs.getUChar("trackId", 0);
    prefs.end();
    uint32_t _tsNvs = micros() - _ts0;

    _ts0 = micros();
    tft.fillScreen(TFT_BLACK);
    tft.setTextDatum(MC_DATUM);

    tft.setFont(&fonts::FreeSans24pt7b);
    tft.setTextColor(TFT_WHITE);
    tft.drawString("", TFT_WIDTH / 2, 60);

    tft.setFont(&fonts::FreeSans24pt7b);
    tft.setTextColor(TFT_WHITE);
    char buf[16];
    snprintf(buf, sizeof(buf), "Track %d", trackId);
    tft.drawString(buf, TFT_WIDTH / 2, 85);

    tft.setFont(&fonts::FreeSans9pt7b);
    tft.setTextColor(TFT_WHITE);
    char verBuf[32];
    snprintf(verBuf, sizeof(verBuf), "FW %s", FW_VERSION);
    tft.drawString(verBuf, TFT_WIDTH / 2, 130);
    tft.drawString(FW_BUILD_ID, TFT_WIDTH / 2, 160);

    // Min/max PWM del motor guardado en NVS (2026-08-07) — diagnóstico visual
    // rápido del rango de potencia del motor sin depender del log serie.
    char pwmBuf[32];
    snprintf(pwmBuf, sizeof(pwmBuf), "PWM %u-%u", Motor::getPWMMin(), Motor::getPWMMax());
    tft.drawString(pwmBuf, TFT_WIDTH / 2, 185);
    uint32_t _tsFonts = micros() - _ts0;

    _ts0 = micros();
    drawCalibDot();
    uint32_t _tsDot = micros() - _ts0;

    // DESACTIVADO: círculo NVS validator
    // uint16_t circleColor = (NVSValidator::getLastStatus() == NVSStatus::VALID) ? TFT_GREEN : TFT_RED;
    // tft.fillCircle(TFT_WIDTH / 2, 200, 6, circleColor);

    log_i("[INSTR-SPLASH] total=%lu nvs=%lu fonts=%lu dot=%lu",
          (unsigned long)(micros() - _tsAll), (unsigned long)_tsNvs,
          (unsigned long)_tsFonts, (unsigned long)_tsDot);
}



// ════════════════════════════════════════════════════════════
//  VU — geometría y estado para dibujo diferencial en tft
// ════════════════════════════════════════════════════════════
namespace VU {
    static constexpr int X      = MAINAREA_WIDTH + 3;
    static constexpr int Y_TOP  = HEADER_HEIGHT + 4;
    static constexpr int W      = 42;
    static constexpr int H      = MAINAREA_HEIGHT - 10;
    static constexpr int SEGS   = 12;
    static constexpr int PAD    = 2;
    static constexpr int CORNER = 2;
    static constexpr int SEG_H  = (H - PAD * (SEGS - 1)) / SEGS;

    int8_t   lastActive    = -1;   // -1 = nunca dibujado → fuerza fondo completo
    int8_t   lastPeak      = -1;
    bool     lastClip      = false;
    uint8_t  peakAlpha     = 255;  // 255=pleno, 0=invisible — fade 300ms (2026-05-26)
    uint8_t  lastPeakAlpha = 255;
    uint32_t peakFadeTime  = 0;
}

// ════════════════════════════════════════════════════════════
//  updateDisplay  —  redraw total + redraws incrementales
// ════════════════════════════════════════════════════════════
void updateDisplay() {
    // Apagado por inactividad en Splash (2026-08-13) — solo mientras no hay
    // Logic conectado. Se reinicia con cualquier actividad (touch fader,
    // REC/SOLO/MUTE/SELECT, encoder). Al detectar actividad tras haberse
    // atenuado, restaura brillo al instante (sin fundido de entrada).
    static unsigned long _splashLastActivity = millis();
    static bool          _splashDimmed       = false;
    static bool          _splashLedsOff      = false;  // LEDs apagados junto con la pantalla (2026-08-13)

    // Detectar transición CONNECTED → DISCONNECTED
    static ConnectionState lastState = ConnectionState::DISCONNECTED;
    if (logicConnectionState == ConnectionState::DISCONNECTED &&
        lastState == ConnectionState::CONNECTED) {
        tft.fillScreen(TFT_BG_COLOR);
        drawOfflineScreen();
        _splashLastActivity = millis();  // splash recién entrada: reiniciar contador
        _splashDimmed       = false;
        _splashLedsOff      = false;
    }
    lastState = logicConnectionState;

    // Sin conexión RS485: pantalla offline — refresco ligero del punto de
    // calibración (2026-08-07): si Motor::isCalibrated() cambia mientras la
    // splash sigue visible (calibración termina en segundo plano), redibuja
    // SOLO el círculo, sin redibujar toda la pantalla.
    if (logicConnectionState != ConnectionState::CONNECTED) {
        static bool lastCalibState = false;
        bool calibNow = Motor::isCalibrated();
        // Redraw forzado (p.ej. al cerrar el SAT ya desconectado, sin flanco
        // CONNECTED→DISCONNECTED que lo dispare arriba) (2026-08-13)
        if (needsTOTALRedraw) {
            needsTOTALRedraw = false;
            drawOfflineScreen();
            lastCalibState       = calibNow;
            _splashLastActivity  = millis();
            _splashDimmed        = false;
            _splashLedsOff       = false;
            return;
        }
        if (calibNow != lastCalibState) {
            lastCalibState = calibNow;
            drawCalibDot();
        }

        bool activity = Motor::isManualTouchDetected() ||
                         digitalRead(BUTTON_PIN_REC)    == LOW ||
                         digitalRead(BUTTON_PIN_SOLO)   == LOW ||
                         digitalRead(BUTTON_PIN_MUTE)   == LOW ||
                         digitalRead(BUTTON_PIN_SELECT) == LOW ||
                         digitalRead(ENCODER_SW_PIN)    == LOW ||
                         Encoder::getCount() != 0;

        if (activity) {
            _splashLastActivity = millis();
            if (_splashDimmed) {
                _splashDimmed = false;
                setScreenBrightness(BRIGHTNESS_SPLASH);  // restauro instantáneo
            }
            if (_splashLedsOff) {
                _splashLedsOff = false;
                forceNeopixelRefresh();  // repinta el patrón azul en el próximo tick (2026-08-13)
            }
        } else {
            unsigned long idle = millis() - _splashLastActivity;
            if (idle >= SPLASH_DIM_TIMEOUT_MS) {
                unsigned long fadeElapsed = idle - SPLASH_DIM_TIMEOUT_MS;
                uint8_t target = (fadeElapsed >= SPLASH_DIM_FADE_MS)
                    ? 0
                    : (uint8_t)((uint32_t)BRIGHTNESS_SPLASH * (SPLASH_DIM_FADE_MS - fadeElapsed) / SPLASH_DIM_FADE_MS);
                if (target != screenBrightness) setScreenBrightness(target);
                _splashDimmed = true;
                // LEDs se apagan junto con la pantalla, en el mismo instante en
                // que llega a brillo 0 (no durante el fundido). (2026-08-13)
                if (target == 0 && !_splashLedsOff) {
                    _splashLedsOff = true;
                    clearAllNeopixels();
                    showNeopixels();
                }
            }
        }
        return;
    }

    // Salir de Splash (Logic conectado): asegurar brillo restaurado si venía atenuada
    if (_splashDimmed) {
        _splashDimmed = false;
    }

    // Primera vez o redraw forzado
    if (needsTOTALRedraw) {
        // INSTRUMENTACIÓN micros() — BRIEF A extendido (2026-08-20). Sub-tiempos
        // del redraw total, para localizar qué sub-función domina el bloqueo.
        uint32_t _trAll = micros();
        uint32_t _tr0;

        _tr0 = micros();
        tft.setBrightness(screenBrightness);   // ← AÑADIR ESTO
        uint32_t _trBright = micros() - _tr0;

        _tr0 = micros();
        tft.fillScreen(TFT_BG_COLOR);
        uint32_t _trFill = micros() - _tr0;

        _tr0 = micros();
        drawHeaderSprite();
        uint32_t _trHeader = micros() - _tr0;

        _tr0 = micros();
        drawMainArea();
        uint32_t _trMain = micros() - _tr0;

        VU::lastActive = -1;   // fuerza fondo completo del VU tras fillScreen
        _tr0 = micros();
        drawVUMeters();
        uint32_t _trVU = micros() - _tr0;

        _tr0 = micros();
        drawVPotDisplay();
        uint32_t _trVPot = micros() - _tr0;

        needsTOTALRedraw    = false;
        needsMainAreaRedraw = false;
        needsHeaderRedraw   = false;
        needsVUMetersRedraw = false;
        needsVPotRedraw     = false;
        log_i("[INSTR-REDRAW] total=%lu bright=%lu fill=%lu header=%lu main=%lu vu=%lu vpot=%lu",
              (unsigned long)(micros() - _trAll), (unsigned long)_trBright,
              (unsigned long)_trFill,   (unsigned long)_trHeader,
              (unsigned long)_trMain,   (unsigned long)_trVU,
              (unsigned long)_trVPot);
        Serial.println("[Display] Redraw total OK");
        return;
    }

    // Redraws incrementales: solo lo que cambió
    if (needsHeaderRedraw) {
        drawHeaderSprite();
        needsHeaderRedraw = false;
    }
    if (needsMainAreaRedraw) {
        drawMainArea();
        needsMainAreaRedraw = false;
    }
    if (needsVUMetersRedraw) {
        drawVUMeters();
        needsVUMetersRedraw = false;
    }
    if (needsVPotRedraw) {
        drawVPotDisplay();
        needsVPotRedraw = false;
    }
}

// ════════════════════════════════════════════════════════════
//  Pantallas de estado
// ════════════════════════════════════════════════════════════
void drawOfflineScreen() {
    // FIX 2026-08-07: el guard "static bool splashDrawn" nunca se reseteaba —
    // solo dibujaba la primera desconexión de toda la sesión de encendido.
    // El llamador (updateDisplay()) YA hace detección de flanco CONNECTED→
    // DISCONNECTED, así que esta función solo se invoca una vez por evento de
    // desconexión — el guard interno era redundante y, al no resetearse nunca,
    // bloqueaba todos los redibujados posteriores (por eso el círculo de
    // calibración se quedaba congelado en rojo tras la primera desconexión).
    // Brillo unificado con BRIGHTNESS_SPLASH (antes: 100 hardcodeado).
    setScreenBrightness(BRIGHTNESS_SPLASH);
    drawSplashScreen();  // necesita el trackId
}

void drawInitializingScreen() {
    tft.fillScreen(TFT_BLUE);
    tft.setTextDatum(MC_DATUM);
    tft.setTextColor(TFT_YELLOW);
    tft.drawString("MIDI Handshake OK!", tft.width() / 2, tft.height() / 2 - 30);
    tft.setTextColor(TFT_DARKGREY);
    tft.drawString("Esperando DAW...",   tft.width() / 2, tft.height() / 2 + 10);
}

// ════════════════════════════════════════════════════════════
//  drawHeaderSprite
// ════════════════════════════════════════════════════════════

// Función helper — atenuar color RGB565 a ~25%
static uint16_t dimColor565(uint16_t color) {
    uint8_t r = (color >> 11) & 0x1F;
    uint8_t g = (color >> 5)  & 0x3F;
    uint8_t b =  color        & 0x1F;
    return ((r / 4) << 11) | ((g / 4) << 5) | (b / 4);
}


void drawHeaderSprite() {
    static const uint16_t AUTO_COLORS[] = {
        TFT_AUTO_OFF,    // AUTO_OFF
        TFT_AUTO_READ,   // AUTO_READ
        TFT_AUTO_WRITE,  // AUTO_WRITE
        TFT_AUTO_TRIM,   // AUTO_TRIM
        TFT_AUTO_TOUCH,  // AUTO_TOUCH
        TFT_AUTO_LATCH,  // AUTO_LATCH
    };

    auto dimColor565 = [](uint16_t color) -> uint16_t {
        uint8_t r = (color >> 11) & 0x1F;
        uint8_t g = (color >> 5)  & 0x3F;
        uint8_t b =  color        & 0x1F;
        return ((r / 4) << 11) | ((g / 4) << 5) | (b / 4);
    };

    uint16_t baseColor   = AUTO_COLORS[currentAutoMode];
    uint16_t headerColor = selectStates ? baseColor : dimColor565(baseColor);

    header.fillSprite(headerColor);

    screenBrightness = selectStates ? BRIGHTNESS_SELECTED : BRIGHTNESS_UNSELECTED;
    setScreenBrightness(screenBrightness);
    header.pushSprite(0, 0);
}

// ════════════════════════════════════════════════════════════
//  drawButton
// ════════════════════════════════════════════════════════════
void drawButton(LGFX_Sprite &sprite, uint16_t x, uint16_t y,
                uint16_t w, uint16_t h,
                const char* label, bool active, uint16_t activeColor) {
    uint16_t btnColor  = active ? activeColor : TFT_MCU_DARKGRAY;
    uint16_t textColor = active ? TFT_BLACK   : TFT_WHITE;
    sprite.fillRoundRect(x, y, w, h, 5, btnColor);
    sprite.setTextFont(2);
    sprite.setTextSize(1);
    sprite.setTextColor(textColor, btnColor);
    sprite.setTextDatum(MC_DATUM);
    sprite.drawString(label, x + w / 2, y + h / 2);
}

// ════════════════════════════════════════════════════════════
//  drawMainArea
// ════════════════════════════════════════════════════════════
void drawMainArea() {
    mainArea.fillSprite(TFT_BG_COLOR);

    drawButton(mainArea, 10,                        7, BUTTON_WIDTH, BUTTON_HEIGHT, "REC",  recStates,  TFT_REC_COLOR);
    drawButton(mainArea, 10 + BUTTON_WIDTH + 2,     7, BUTTON_WIDTH, BUTTON_HEIGHT, "SOLO", soloStates, TFT_SOLO_COLOR);
    drawButton(mainArea, 10 + BUTTON_WIDTH * 2 + 4, 7, BUTTON_WIDTH, BUTTON_HEIGHT, "MUTE", muteStates, TFT_MUTE_COLOR);


    // --- Track name ---
    mainArea.setTextDatum(TL_DATUM);
    mainArea.setTextColor(TFT_WHITE, TFT_BG_COLOR);
    mainArea.setFont(&fonts::FreeSans24pt7b);
    mainArea.setTextSize(1);
    mainArea.setCursor(7, 90);
    mainArea.print(trackName);

    // --- Fader dB ---
    char faderDbStr[12];
    if (faderPositions < 0.001f) {
        snprintf(faderDbStr, sizeof(faderDbStr), "-inf");
    } else if (faderPositions < 0.75f) {
        float db = (faderPositions / 0.75f) * 60.0f - 60.0f;
        snprintf(faderDbStr, sizeof(faderDbStr), "%.1f dB", db);
    } else {
        float db = ((faderPositions - 0.75f) / 0.25f) * 10.0f;
        snprintf(faderDbStr, sizeof(faderDbStr), "+%.1f dB", db);
    }
    mainArea.setFont(&fonts::FreeSans12pt7b);
    mainArea.setTextColor(TFT_DARKGREY, TFT_BG_COLOR);
    mainArea.setCursor(7, 145);
    mainArea.print(faderDbStr);

    mainArea.pushSprite(0, HEADER_HEIGHT);
    
    
}

static uint16_t blendColor565(uint16_t a, uint16_t b, uint8_t alpha) {
    uint8_t r  = ((((a >> 11) & 0x1F) * alpha) + (((b >> 11) & 0x1F) * (255u - alpha))) >> 8;
    uint8_t g  = ((((a >>  5) & 0x3F) * alpha) + (((b >>  5) & 0x3F) * (255u - alpha))) >> 8;
    uint8_t bl = (((a & 0x1F) * alpha)          + (( b & 0x1F)        * (255u - alpha))) >> 8;
    return (r << 11) | (g << 5) | bl;
}

static uint16_t vuSegColor(int i, int active, int peak, bool clip, uint8_t peakAlpha = 255) {
    if (i == VU::SEGS - 1 && clip) return VU_RED_ON;
    if (i < active) return (i<8)?VU_GREEN_ON:(i<10)?VU_YELLOW_ON:VU_RED_ON;
    if (peak >= 0 && i == peak && peakAlpha > 0) {
        uint16_t on  = (i<8)?VU_GREEN_ON :(i<10)?VU_YELLOW_ON :VU_RED_ON;
        uint16_t off = (i<8)?VU_GREEN_OFF:(i<10)?VU_YELLOW_OFF:VU_RED_OFF;
        return (peakAlpha == 255) ? on : blendColor565(on, off, peakAlpha);
    }
    return (i<8)?VU_GREEN_OFF:(i<10)?VU_YELLOW_OFF:VU_RED_OFF;
}

static void vuDrawSeg(int i, uint16_t fill) {
    int y = VU::Y_TOP + VU::H - (i + 1) * VU::SEG_H - i * VU::PAD;
    tft.fillRoundRect(VU::X, y, VU::W, VU::SEG_H, VU::CORNER, fill);
}

// ════════════════════════════════════════════════════════════
//  drawVUMeters — diferencial: solo segmentos que cambiaron
// ════════════════════════════════════════════════════════════
void drawVUMeters() {
    int  active   = (int)round(vuLevels     * VU::SEGS);
    int  peak     = (int)round(vuPeakLevels * VU::SEGS);
    if (peak > 0) peak--;
    bool showPeak = (vuPeakLevels > vuLevels + 0.001f) && VU::peakAlpha > 0;
    if (!showPeak) peak = -1;
    bool clip = vuClipState;

    if (VU::lastActive < 0) {
        tft.fillRect(MAINAREA_WIDTH, HEADER_HEIGHT,
                     TFT_WIDTH - MAINAREA_WIDTH, MAINAREA_HEIGHT, TFT_MCU_DARKGRAY);
        for (int i = 0; i < VU::SEGS; i++)
            vuDrawSeg(i, vuSegColor(i, active, peak, clip, VU::peakAlpha));
    } else {
        for (int i = 0; i < VU::SEGS; i++) {
            uint16_t cNow  = vuSegColor(i, active,         peak,         clip,         VU::peakAlpha);
            uint16_t cPrev = vuSegColor(i, VU::lastActive, VU::lastPeak, VU::lastClip, VU::lastPeakAlpha);
            if (cNow != cPrev)
                vuDrawSeg(i, cNow);
        }
    }

    VU::lastActive    = (int8_t)active;
    VU::lastPeak      = (int8_t)(showPeak ? peak : -1);
    VU::lastClip      = clip;
    VU::lastPeakAlpha = VU::peakAlpha;
}

// ════════════════════════════════════════════════════════════
//  handleVUMeterDecay — lógica S3 + bug fix timer peak
// ════════════════════════════════════════════════════════════
void handleVUMeterDecay() {
    const unsigned long DECAY_INTERVAL_MS = 100;
    const unsigned long PEAK_HOLD_TIME_MS = 1000;
    const unsigned long PEAK_FADE_STEP_MS = 25;    // 4 pasos × 25ms = 100ms fade (SSL-style)
    const float         DECAY_AMOUNT      = 1.0f / 12.0f;
    const uint8_t       FADE_STEP         = 64;    // 255 / 4 pasos ≈ 64 por paso

    unsigned long now = millis();
    bool changed = false;

    // 1. Decaimiento del nivel normal
    if (vuLevels > 0 && now - vuLastUpdateTime > DECAY_INTERVAL_MS) {
        vuLevels -= DECAY_AMOUNT;
        if (vuLevels < 0.01f) vuLevels = 0.0f;
        vuLastUpdateTime = now;
        changed = true;
    }

    // 2. Peak — hold 2s + fade 300ms
    if (vuPeakLevels > 0) {
        bool detached = vuPeakLevels > vuLevels + 0.001f;
        if (!detached) {
            // Nivel alcanzó el peak: mantener alpha pleno
            VU::peakAlpha    = 255;
            VU::peakFadeTime = 0;
        } else if (now - vuPeakLastUpdateTime > PEAK_HOLD_TIME_MS) {
            // Hold completo: iniciar o continuar fade
            if (VU::peakFadeTime == 0) {
                VU::peakFadeTime = now;
            } else if (now - VU::peakFadeTime >= PEAK_FADE_STEP_MS) {
                VU::peakFadeTime = now;
                if (VU::peakAlpha > FADE_STEP) {
                    VU::peakAlpha -= FADE_STEP;
                } else {
                    VU::peakAlpha = 0;
                    vuPeakLevels  = 0.0f;
                }
                changed = true;
            }
        }
    } else {
        VU::peakAlpha    = 255;
        VU::peakFadeTime = 0;
    }

    // 3. Seguridad: peak nunca puede ser menor que el nivel actual
    if (vuPeakLevels < vuLevels) {
        vuPeakLevels         = vuLevels;
        vuPeakLastUpdateTime = now;
        VU::peakAlpha        = 255;
        VU::peakFadeTime     = 0;
        changed = true;
    }

    if (changed) needsVUMetersRedraw = true;
}

static uint16_t autoModeColor(AutoMode mode) {
    static const uint16_t AUTO_COLORS[] = {
        TFT_AUTO_OFF,    // 0 — OFF
        TFT_AUTO_READ,   // 1 — READ
        TFT_AUTO_WRITE,  // 2 — WRITE
        TFT_AUTO_TRIM,   // 3 — TRIM
        TFT_AUTO_TOUCH,  // 4 — TOUCH
        TFT_AUTO_LATCH,  // 5 — LATCH
    };
    uint8_t idx = (uint8_t)mode;
    if (idx >= 6) idx = 0;
    return AUTO_COLORS[idx];
}

// ════════════════════════════════════════════════════════════
//  drawVPotDisplay
// ════════════════════════════════════════════════════════════
void drawVPotDisplay() {
    vPotSprite.fillSprite(TFT_MCU_DARKGRAY);

    const uint8_t raw    = currentVPotRaw;
    const uint8_t pos    = raw & 0x0F;         // 0=off, 1-11
    const uint8_t mode   = (raw >> 4) & 0x03;  // 0=dot 1=boost/cut 2=bar 3=spread
    const bool    center = (raw >> 6) & 0x01;
    const uint16_t litColor = autoModeColor(currentAutoMode);

    const int N      = 5;   // segmentos por lado
    const int gapV   = 3;
    const int cornerR= 4;
    const int seg_y  = 3;
    const int seg_h  = vPotSprite.height() - 6;

    // Distribuir ancho: N segs izq + centro + N segs der
    const int totalW = vPotSprite.width() - 4;
    const int segW   = (totalW - (2*N + 1) * gapV) / (2*N + 1);
    const int ctrW   = segW;  // centro = mismo ancho
    const int startX = (vPotSprite.width() - (segW * (2*N+1) + gapV * (2*N))) / 2;

    // pos 1-5 = izquierda (índice 4..0), pos 6 = centro, pos 7-11 = derecha (índice 0..4)
    for (int i = 0; i < N; i++) {
        int seg = N - 1 - i;  // seg 4=más lejano, 0=más cercano al centro
        int posL = i + 1;;   // posición Mackie correspondiente (1-5)
        bool lit = false;
        if (pos > 0) {
            switch (mode) {
                case 0: lit = (pos == posL);              break; // dot
                case 1: lit = (pos <= 5 && posL >= pos); break; // boost/cut izq
                case 2: lit = false;                      break; // bar: solo derecha
                case 3: lit = (pos >= 6 && (6 - posL) <= (int)pos - 6) ||
                              (pos <= 5 && posL >= pos);  break; // spread
            }
        }
        int x = startX + i * (segW + gapV);
        vPotSprite.fillRoundRect(x, seg_y, segW, seg_h, cornerR, lit ? litColor : TFT_MCU_GRAY);
    }

    // Centro (pos 6)
    int cx = startX + N * (segW + gapV);
    bool ctrLit = (pos > 0) && (center || pos == 6 ||
                  mode == 2 || (mode == 1 && pos == 6));
    vPotSprite.fillRoundRect(cx, seg_y, ctrW, seg_h, cornerR,
                          ctrLit ? litColor : TFT_MCU_GRAY);

    // Derecha (pos 7-11)
    for (int i = 0; i < N; i++) {
        int posR = i + 7;  // posición Mackie 7-11
        bool lit = false;
        if (pos > 0) {
            switch (mode) {
                case 0: lit = (pos == posR);         break; // dot
                case 1: lit = (pos >= 7 && posR <= pos); break; // boost/cut der
                case 2: lit = (posR <= pos);         break; // bar
                case 3: lit = (pos >= 6 && posR <= pos) ||
                              (pos <= 5 && posR <= (12 - pos)); break; // spread
            }
        }
        int x = cx + ctrW + gapV + i * (segW + gapV);
        vPotSprite.fillRoundRect(x, seg_y, segW, seg_h, cornerR, lit ? litColor : TFT_MCU_GRAY);
    }

    vPotSprite.pushSprite(0, MAINAREA_HEIGHT + HEADER_HEIGHT);
}

void setVPotRaw(uint8_t raw) {
    if ((raw & 0x7F) != currentVPotRaw) {
        currentVPotRaw  = raw & 0x7F;
        needsVPotRedraw = true;
    }
}

void setAutoMode(uint8_t mode) {
    AutoMode m = (AutoMode)(mode & 0x07);
    if (m != currentAutoMode) {
        currentAutoMode   = m;
        needsVPotRedraw   = true;
        needsHeaderRedraw = true;
    }
}

void setVPotLevel(int8_t level) {
    if (level < VPOT_MIN_LEVEL) level = VPOT_MIN_LEVEL;
    if (level > VPOT_MAX_LEVEL) level = VPOT_MAX_LEVEL;
    if (level != currentVPotLevel) {
        currentVPotLevel = level;
        needsVPotRedraw = true;
    }
}
