juliannof/AITEC-17/MASTER_S3-P4/P4_JC1060P470C/src/display/UIHeader.cpp

#include "UIHeader.h"
#include "UIMenu.h"
#include "../config.h"
#include "lvgl.h"

extern void sendMIDIBytes(const uint8_t* data, size_t len);
extern volatile bool g_switchToPage1;
extern volatile bool g_switchToPage3A;

static void nav_btn_cb(lv_event_t* e) {
    if (lv_event_get_code(e) != LV_EVENT_CLICKED) return;
    int idx = (int)(intptr_t)lv_event_get_user_data(e);
    if      (idx == 0) g_switchToPage1  = true;
    else if (idx == 1) g_switchToPage3A = true;
}

static void header_btn_cb(lv_event_t* e) {
    lv_event_code_t code = lv_event_get_code(e);
    uint8_t note = (uint8_t)(uintptr_t)lv_event_get_user_data(e);
    if (code == LV_EVENT_PRESSED) {
        uint8_t msg[3] = { 0x90, note, 0x7F };
        sendMIDIBytes(msg, 3);
    } else if (code == LV_EVENT_RELEASED) {
        uint8_t msg[3] = { 0x90, note, 0x00 };
        sendMIDIBytes(msg, 3);
    }
}

LV_FONT_DECLARE(lv_font_dseg7_44);

static lv_obj_t* s_strip      = NULL;
static lv_obj_t* s_timecode   = NULL;
static lv_obj_t* s_tc_ghost   = NULL;
static lv_obj_t* s_mode_lbl   = NULL;
static lv_obj_t* s_solo_lbl   = NULL;
static lv_obj_t* s_cycle_lbl  = NULL;
static lv_obj_t* s_click_lbl  = NULL;
static lv_obj_t* s_mode_hit   = NULL;
static lv_obj_t* s_cycle_hit  = NULL;
static lv_obj_t* s_solo_hit   = NULL;
static lv_obj_t* s_click_hit  = NULL;
static lv_obj_t* s_bo_lbl     = NULL;
static lv_obj_t* s_vu_lbl     = NULL;
static lv_obj_t* s_bo_hit     = NULL;
static lv_obj_t* s_vu_hit     = NULL;
static lv_obj_t* s_vpot_lbl[8] = {};
static lv_obj_t* s_assign_cont = NULL;
static lv_obj_t* s_assign_lbl  = NULL;
static uint8_t   s_lastPage   = 255;

// Beats: contenedor por bloque, ghost+real dentro al (0,0)
static lv_obj_t* s_beat_cont[4]  = {};
static lv_obj_t* s_beat_ghost[4] = {};
static lv_obj_t* s_beat_real[4]  = {};
static lv_obj_t* s_beat_dot[3]   = {};
static lv_obj_t* s_tc_frame      = NULL;

extern String formatTimecodeString();
extern char timeCodeChars_clean[13];

static bool hasDigit(const char* s) {
    for (; *s; s++) if (*s >= '0' && *s <= '9') return true;
    return false;
}

extern volatile uint8_t g_currentPage;

static void applyNavState(lv_obj_t* lbl, bool active) {
    if (!lbl) return;
    lv_obj_t* t = lv_obj_get_child(lbl, 0);
    uint32_t col = active ? COL_HEADER_BRIGHT : COL_HEADER_DIM;
    lv_obj_set_style_bg_opa(lbl, LV_OPA_TRANSP, 0);
    lv_obj_set_style_border_color(lbl, lv_color_hex(col), 0);
    if (t) lv_obj_set_style_text_color(t, lv_color_hex(col), 0);
}

static void applyModeState(bool isBeats) {
    if (!s_mode_lbl) return;
    lv_obj_t* t = lv_obj_get_child(s_mode_lbl, 0);
    if (isBeats) {
        lv_obj_set_style_bg_opa(s_mode_lbl, LV_OPA_TRANSP, 0);
        lv_obj_set_style_border_color(s_mode_lbl, lv_color_hex(COL_HEADER_BRIGHT), 0);
        if (t) lv_obj_set_style_text_color(t, lv_color_hex(COL_HEADER_BRIGHT), 0);
    } else {
        lv_obj_set_style_bg_color(s_mode_lbl, lv_color_hex(COL_HEADER_BRIGHT), 0);
        lv_obj_set_style_bg_opa(s_mode_lbl, LV_OPA_COVER, 0);
        lv_obj_set_style_border_color(s_mode_lbl, lv_color_hex(COL_HEADER_BRIGHT), 0);
        if (t) lv_obj_set_style_text_color(t, lv_color_hex(COL_HEADER_DIM), 0);
    }
}

static void updateNavButtons() {
    applyNavState(s_bo_lbl, g_currentPage == 1);
    applyNavState(s_vu_lbl, g_currentPage == 0);
    s_lastPage = g_currentPage;
}

void uiHeaderCreate(lv_obj_t* parent) {
    // ── Strip azul ────────────────────────────────────────────────
    s_strip = lv_obj_create(parent);
    lv_obj_set_pos(s_strip, 0, 0);
    lv_obj_set_size(s_strip, P4_W, HEADER_H + ASSIGN_STRIP_H);
    lv_obj_set_style_bg_color(s_strip, lv_color_hex(COL_HEADER), 0);
    lv_obj_set_style_border_width(s_strip, 0, 0);
    lv_obj_set_style_radius(s_strip, 0, 0);
    lv_obj_set_style_pad_all(s_strip, 0, 0);
    lv_obj_clear_flag(s_strip, LV_OBJ_FLAG_SCROLLABLE);
    lv_obj_set_style_shadow_width(s_strip, 15, 0);
    lv_obj_set_style_shadow_color(s_strip, lv_color_black(), 0);
    lv_obj_set_style_shadow_opa(s_strip, LV_OPA_70, 0);
    lv_obj_set_style_shadow_offset_x(s_strip, 0, 0);
    lv_obj_set_style_shadow_offset_y(s_strip, 10, 0);

    // ── Indicador BEAT/SMPT ───────────────────────────────────────
    s_mode_lbl = lv_obj_create(parent);
    lv_obj_set_pos(s_mode_lbl, 12, (HEADER_H - 32) / 2);
    lv_obj_set_size(s_mode_lbl, 68, 32);
    lv_obj_set_style_bg_opa(s_mode_lbl, LV_OPA_TRANSP, 0);
    lv_obj_set_style_border_width(s_mode_lbl, 1, 0);
    lv_obj_set_style_border_color(s_mode_lbl, lv_color_hex(COL_HEADER_BRIGHT), 0);
    lv_obj_set_style_radius(s_mode_lbl, 4, 0);
    lv_obj_set_style_pad_all(s_mode_lbl, 0, 0);
    lv_obj_clear_flag(s_mode_lbl, LV_OBJ_FLAG_SCROLLABLE);
    lv_obj_clear_flag(s_mode_lbl, LV_OBJ_FLAG_CLICKABLE);
    s_mode_hit = lv_obj_create(parent);
    lv_obj_set_pos(s_mode_hit, 12, 0);
    lv_obj_set_size(s_mode_hit, 68, HEADER_H);
    lv_obj_set_style_bg_opa(s_mode_hit, LV_OPA_TRANSP, 0);
    lv_obj_set_style_border_width(s_mode_hit, 0, 0);
    lv_obj_set_style_pad_all(s_mode_hit, 0, 0);
    lv_obj_clear_flag(s_mode_hit, LV_OBJ_FLAG_SCROLLABLE);
    lv_obj_add_event_cb(s_mode_hit, header_btn_cb, LV_EVENT_PRESSED,  (void*)(uintptr_t)0x35);
    lv_obj_add_event_cb(s_mode_hit, header_btn_cb, LV_EVENT_RELEASED, (void*)(uintptr_t)0x35);
    {
        lv_obj_t* t = lv_label_create(s_mode_lbl);
        lv_label_set_text(t, (currentTimecodeMode == MODE_BEATS) ? "BEAT" : "SMPT");
        lv_obj_set_style_text_font(t, &lv_font_montserrat_14, 0);
        lv_obj_center(t);
    }
    applyModeState(currentTimecodeMode == MODE_BEATS);

    // ── Indicador LOOP/CICLO ──────────────────────────────────────
    s_cycle_lbl = lv_obj_create(parent);
    lv_obj_set_pos(s_cycle_lbl, 88, (HEADER_H - 34) / 2);
    lv_obj_set_size(s_cycle_lbl, 44, 34);
    lv_obj_set_style_bg_opa(s_cycle_lbl, LV_OPA_TRANSP, 0);
    lv_obj_set_style_border_width(s_cycle_lbl, 1, 0);
    lv_obj_set_style_border_color(s_cycle_lbl, lv_color_hex(COL_HEADER_DIM), 0);
    lv_obj_set_style_radius(s_cycle_lbl, 4, 0);
    lv_obj_set_style_pad_all(s_cycle_lbl, 0, 0);
    lv_obj_clear_flag(s_cycle_lbl, LV_OBJ_FLAG_SCROLLABLE);
    lv_obj_clear_flag(s_cycle_lbl, LV_OBJ_FLAG_CLICKABLE);
    s_cycle_hit = lv_obj_create(parent);
    lv_obj_set_pos(s_cycle_hit, 88, 0);
    lv_obj_set_size(s_cycle_hit, 44, HEADER_H);
    lv_obj_set_style_bg_opa(s_cycle_hit, LV_OPA_TRANSP, 0);
    lv_obj_set_style_border_width(s_cycle_hit, 0, 0);
    lv_obj_set_style_pad_all(s_cycle_hit, 0, 0);
    lv_obj_clear_flag(s_cycle_hit, LV_OBJ_FLAG_SCROLLABLE);
    lv_obj_add_event_cb(s_cycle_hit, header_btn_cb, LV_EVENT_PRESSED,  (void*)(uintptr_t)0x56);
    lv_obj_add_event_cb(s_cycle_hit, header_btn_cb, LV_EVENT_RELEASED, (void*)(uintptr_t)0x56);
    {
        lv_obj_t* t = lv_label_create(s_cycle_lbl);
        lv_label_set_text(t, LV_SYMBOL_LOOP);
        lv_obj_set_style_text_color(t, lv_color_hex(COL_HEADER_DIM), 0);
        lv_obj_set_style_text_font(t, &lv_font_montserrat_14, 0);
        lv_obj_center(t);
    }

    // ── Indicador RUDE SOLO ───────────────────────────────────────
    s_solo_lbl = lv_obj_create(parent);
    lv_obj_set_pos(s_solo_lbl, 140, (HEADER_H - 34) / 2);
    lv_obj_set_size(s_solo_lbl, 44, 34);
    lv_obj_set_style_bg_opa(s_solo_lbl, LV_OPA_TRANSP, 0);
    lv_obj_set_style_border_width(s_solo_lbl, 1, 0);
    lv_obj_set_style_border_color(s_solo_lbl, lv_color_hex(COL_HEADER_DIM), 0);
    lv_obj_set_style_radius(s_solo_lbl, 4, 0);
    lv_obj_set_style_pad_all(s_solo_lbl, 0, 0);
    lv_obj_clear_flag(s_solo_lbl, LV_OBJ_FLAG_SCROLLABLE);
    lv_obj_clear_flag(s_solo_lbl, LV_OBJ_FLAG_CLICKABLE);
    s_solo_hit = lv_obj_create(parent);
    lv_obj_set_pos(s_solo_hit, 140, 0);
    lv_obj_set_size(s_solo_hit, 44, HEADER_H);
    lv_obj_set_style_bg_opa(s_solo_hit, LV_OPA_TRANSP, 0);
    lv_obj_set_style_border_width(s_solo_hit, 0, 0);
    lv_obj_set_style_pad_all(s_solo_hit, 0, 0);
    lv_obj_clear_flag(s_solo_hit, LV_OBJ_FLAG_SCROLLABLE);
    lv_obj_add_event_cb(s_solo_hit, header_btn_cb, LV_EVENT_PRESSED,  (void*)(uintptr_t)0x5A);
    lv_obj_add_event_cb(s_solo_hit, header_btn_cb, LV_EVENT_RELEASED, (void*)(uintptr_t)0x5A);
    {
        lv_obj_t* t = lv_label_create(s_solo_lbl);
        lv_label_set_text(t, "S");
        lv_obj_set_style_text_color(t, lv_color_hex(COL_HEADER_DIM), 0);
        lv_obj_set_style_text_font(t, &lv_font_montserrat_28, 0);
        lv_obj_center(t);
    }

    // ── Indicador CLICK ──────────────────────────────────────────
    s_click_lbl = lv_obj_create(parent);
    lv_obj_set_pos(s_click_lbl, 192, (HEADER_H - 34) / 2);
    lv_obj_set_size(s_click_lbl, 44, 34);
    lv_obj_set_style_bg_opa(s_click_lbl, LV_OPA_TRANSP, 0);
    lv_obj_set_style_border_width(s_click_lbl, 1, 0);
    lv_obj_set_style_border_color(s_click_lbl, lv_color_hex(COL_HEADER_DIM), 0);
    lv_obj_set_style_radius(s_click_lbl, 4, 0);
    lv_obj_set_style_pad_all(s_click_lbl, 0, 0);
    lv_obj_clear_flag(s_click_lbl, LV_OBJ_FLAG_SCROLLABLE);
    lv_obj_clear_flag(s_click_lbl, LV_OBJ_FLAG_CLICKABLE);
    s_click_hit = lv_obj_create(parent);
    lv_obj_set_pos(s_click_hit, 192, 0);
    lv_obj_set_size(s_click_hit, 44, HEADER_H);
    lv_obj_set_style_bg_opa(s_click_hit, LV_OPA_TRANSP, 0);
    lv_obj_set_style_border_width(s_click_hit, 0, 0);
    lv_obj_set_style_pad_all(s_click_hit, 0, 0);
    lv_obj_clear_flag(s_click_hit, LV_OBJ_FLAG_SCROLLABLE);
    lv_obj_add_event_cb(s_click_hit, header_btn_cb, LV_EVENT_PRESSED,  (void*)(uintptr_t)0x59);
    lv_obj_add_event_cb(s_click_hit, header_btn_cb, LV_EVENT_RELEASED, (void*)(uintptr_t)0x59);
    {
        lv_obj_t* t = lv_label_create(s_click_lbl);
        lv_label_set_text(t, LV_SYMBOL_AUDIO);
        lv_obj_set_style_text_color(t, lv_color_hex(COL_HEADER_DIM), 0);
        lv_obj_set_style_text_font(t, &lv_font_montserrat_14, 0);
        lv_obj_center(t);
    }

    // ── Indicador VPot Assignment (TRACK/SEND/PAN/PLUG/EQ/INST) ─────
    s_assign_cont = lv_obj_create(parent);
    lv_obj_set_pos(s_assign_cont, 244, (HEADER_H - 34) / 2);
    lv_obj_set_size(s_assign_cont, 44, 34);
    lv_obj_set_style_bg_opa(s_assign_cont, LV_OPA_TRANSP, 0);
    lv_obj_set_style_border_width(s_assign_cont, 1, 0);
    lv_obj_set_style_border_color(s_assign_cont, lv_color_hex(COL_HEADER_DIM), 0);
    lv_obj_set_style_radius(s_assign_cont, 4, 0);
    lv_obj_set_style_pad_all(s_assign_cont, 0, 0);
    lv_obj_clear_flag(s_assign_cont, LV_OBJ_FLAG_SCROLLABLE);
    lv_obj_clear_flag(s_assign_cont, LV_OBJ_FLAG_CLICKABLE);
    s_assign_lbl = lv_label_create(s_assign_cont);
    lv_label_set_text(s_assign_lbl, "--");
    lv_obj_set_style_text_color(s_assign_lbl, lv_color_hex(COL_HEADER_DIM), 0);
    lv_obj_set_style_text_font(s_assign_lbl, &lv_font_montserrat_14, 0);
    lv_obj_center(s_assign_lbl);

    // ── Timecode SMPTE ghost + real (sin cambios) ─────────────────
    s_tc_ghost = lv_label_create(parent);
    lv_label_set_text(s_tc_ghost, "00:00:00: 00");
    lv_obj_set_style_text_color(s_tc_ghost, lv_color_hex(COL_HEADER_DIM), 0);
    lv_obj_set_style_text_font(s_tc_ghost, &lv_font_dseg7_44, 0);

    s_timecode = lv_label_create(parent);
    lv_label_set_text(s_timecode, "00:00:00: 00");
    lv_obj_set_style_text_color(s_timecode, lv_color_hex(COL_HEADER_BRIGHT), 0);
    lv_obj_set_style_text_font(s_timecode, &lv_font_dseg7_44, 0);

    lv_obj_update_layout(parent);
    int th    = lv_obj_get_height(s_timecode);
    int pos_y = (HEADER_H - th) / 2;

    lv_obj_align(s_tc_ghost, LV_ALIGN_TOP_MID, 0, pos_y);
    lv_obj_align(s_timecode, LV_ALIGN_TOP_MID, 0, pos_y);

    lv_obj_update_layout(parent);
    {
        int tw = lv_obj_get_width(s_timecode);
        int tx = lv_obj_get_x(s_timecode);
        s_tc_frame = lv_obj_create(parent);
        lv_obj_set_pos(s_tc_frame, tx - 41, pos_y - 9);
        lv_obj_set_size(s_tc_frame, tw + 82, th + 18);
        lv_obj_set_style_bg_opa(s_tc_frame, LV_OPA_TRANSP, 0);
        lv_obj_set_style_border_width(s_tc_frame, 1, 0);
        lv_obj_set_style_border_color(s_tc_frame, lv_color_hex(COL_HEADER_DIM), 0);
        lv_obj_set_style_radius(s_tc_frame, 8, 0);
        lv_obj_set_style_pad_all(s_tc_frame, 0, 0);
        lv_obj_clear_flag(s_tc_frame, LV_OBJ_FLAG_SCROLLABLE);
        lv_obj_clear_flag(s_tc_frame, LV_OBJ_FLAG_CLICKABLE);
    }

    // ── BEATS: 4 bloques + 3 puntos separadores ──────────────────
    {
        const int dw          = 40;
        const int bwidths[4]  = {4*dw, dw, dw, 3*dw};  // 160,40,40,120
        const int dot_gap     = 12;
        const char* ghost_str[4] = {"0000", "0", "0", "000"};

        int bx[4], dx[3];
        bx[0] = 312;
        for (int b = 0; b < 3; b++) {
            dx[b]     = bx[b] + bwidths[b];
            bx[b + 1] = dx[b] + dot_gap;
        }

        bool beatMode = (currentTimecodeMode == MODE_BEATS);

        for (int b = 0; b < 4; b++) {
            s_beat_cont[b] = lv_obj_create(parent);
            lv_obj_set_pos(s_beat_cont[b], bx[b], pos_y);
            lv_obj_set_size(s_beat_cont[b], bwidths[b], th);
            lv_obj_set_style_bg_opa(s_beat_cont[b], LV_OPA_TRANSP, 0);
            lv_obj_set_style_border_width(s_beat_cont[b], 0, 0);
            lv_obj_set_style_pad_all(s_beat_cont[b], 0, 0);
            lv_obj_clear_flag(s_beat_cont[b], LV_OBJ_FLAG_SCROLLABLE);

            s_beat_ghost[b] = lv_label_create(s_beat_cont[b]);
            lv_obj_set_pos(s_beat_ghost[b], 0, 0);
            lv_obj_set_size(s_beat_ghost[b], bwidths[b], th);
            lv_label_set_long_mode(s_beat_ghost[b], LV_LABEL_LONG_CLIP);
            lv_obj_set_style_text_align(s_beat_ghost[b], LV_TEXT_ALIGN_RIGHT, 0);
            lv_obj_set_style_text_color(s_beat_ghost[b], lv_color_hex(COL_HEADER_DIM), 0);
            lv_obj_set_style_text_font(s_beat_ghost[b], &lv_font_dseg7_44, 0);
            lv_obj_set_style_bg_opa(s_beat_ghost[b], LV_OPA_TRANSP, 0);
            lv_obj_set_style_border_width(s_beat_ghost[b], 0, 0);
            lv_obj_set_style_pad_all(s_beat_ghost[b], 0, 0);
            lv_obj_clear_flag(s_beat_ghost[b], LV_OBJ_FLAG_SCROLLABLE);
            lv_label_set_text(s_beat_ghost[b], ghost_str[b]);

            s_beat_real[b] = lv_label_create(s_beat_cont[b]);
            lv_obj_set_pos(s_beat_real[b], 0, 0);
            lv_obj_set_size(s_beat_real[b], bwidths[b], th);
            lv_label_set_long_mode(s_beat_real[b], LV_LABEL_LONG_CLIP);
            lv_obj_set_style_text_align(s_beat_real[b], LV_TEXT_ALIGN_RIGHT, 0);
            lv_obj_set_style_text_color(s_beat_real[b], lv_color_hex(COL_HEADER_BRIGHT), 0);
            lv_obj_set_style_text_font(s_beat_real[b], &lv_font_dseg7_44, 0);
            lv_obj_set_style_bg_opa(s_beat_real[b], LV_OPA_TRANSP, 0);
            lv_obj_set_style_border_width(s_beat_real[b], 0, 0);
            lv_obj_set_style_pad_all(s_beat_real[b], 0, 0);
            lv_obj_clear_flag(s_beat_real[b], LV_OBJ_FLAG_SCROLLABLE);
            lv_label_set_text(s_beat_real[b], "");

            if (!beatMode) lv_obj_add_flag(s_beat_cont[b], LV_OBJ_FLAG_HIDDEN);
        }

        for (int i = 0; i < 3; i++) {
            s_beat_dot[i] = lv_label_create(parent);
            lv_obj_set_pos(s_beat_dot[i], dx[i], pos_y);
            lv_obj_set_style_text_color(s_beat_dot[i], lv_color_hex(COL_HEADER_DIM), 0);
            lv_obj_set_style_text_font(s_beat_dot[i], &lv_font_dseg7_44, 0);
            lv_label_set_text(s_beat_dot[i], ".");
            if (!beatMode) lv_obj_add_flag(s_beat_dot[i], LV_OBJ_FLAG_HIDDEN);
        }

        if (beatMode) {
            lv_obj_add_flag(s_timecode, LV_OBJ_FLAG_HIDDEN);
            lv_obj_add_flag(s_tc_ghost, LV_OBJ_FLAG_HIDDEN);
        }
    }

    // ── Botones navegación Bo/Vu (izquierda del menú) ────────────
    // Vu=864, Bo=812 — gap 8px entre sí y hacia hamburguesa (2026-08-18: pestaña
    // "Fa"/Page3B retirada junto con UIPage3B.cpp)
    static const struct { lv_obj_t** lbl; lv_obj_t** hit; int x; const char* txt; int idx; }
    navDefs[2] = {
        { &s_bo_lbl, &s_bo_hit, 812, "Bo", 0 },
        { &s_vu_lbl, &s_vu_hit, 864, "Vu", 1 },
    };
    for (int i = 0; i < 2; i++) {
        *navDefs[i].lbl = lv_obj_create(parent);
        lv_obj_set_pos(*navDefs[i].lbl, navDefs[i].x, (HEADER_H - 34) / 2);
        lv_obj_set_size(*navDefs[i].lbl, 44, 34);
        lv_obj_set_style_bg_opa(*navDefs[i].lbl, LV_OPA_TRANSP, 0);
        lv_obj_set_style_border_width(*navDefs[i].lbl, 1, 0);
        lv_obj_set_style_border_color(*navDefs[i].lbl, lv_color_hex(COL_HEADER_DIM), 0);
        lv_obj_set_style_radius(*navDefs[i].lbl, 4, 0);
        lv_obj_set_style_pad_all(*navDefs[i].lbl, 0, 0);
        lv_obj_clear_flag(*navDefs[i].lbl, LV_OBJ_FLAG_SCROLLABLE);
        lv_obj_clear_flag(*navDefs[i].lbl, LV_OBJ_FLAG_CLICKABLE);
        {
            lv_obj_t* t = lv_label_create(*navDefs[i].lbl);
            lv_label_set_text(t, navDefs[i].txt);
            lv_obj_set_style_text_color(t, lv_color_hex(COL_HEADER_DIM), 0);
            lv_obj_set_style_text_font(t, &lv_font_montserrat_14, 0);
            lv_obj_center(t);
        }
        *navDefs[i].hit = lv_obj_create(parent);
        lv_obj_set_pos(*navDefs[i].hit, navDefs[i].x, 0);
        lv_obj_set_size(*navDefs[i].hit, 44, HEADER_H);
        lv_obj_set_style_bg_opa(*navDefs[i].hit, LV_OPA_TRANSP, 0);
        lv_obj_set_style_border_width(*navDefs[i].hit, 0, 0);
        lv_obj_set_style_pad_all(*navDefs[i].hit, 0, 0);
        lv_obj_clear_flag(*navDefs[i].hit, LV_OBJ_FLAG_SCROLLABLE);
        lv_obj_add_event_cb(*navDefs[i].hit, nav_btn_cb, LV_EVENT_CLICKED,
                            (void*)(intptr_t)navDefs[i].idx);
    }
    updateNavButtons();

    // ── VPot assignment strip (pie del header, alineado con columnas P4) ──
    for (int i = 0; i < 8; i++) {
        int col_x = (P4_CH_OFFSET + i) * CH_W;
        s_vpot_lbl[i] = lv_label_create(parent);
        lv_obj_set_pos(s_vpot_lbl[i], col_x, HEADER_H);
        lv_obj_set_size(s_vpot_lbl[i], CH_W, ASSIGN_STRIP_H);
        lv_obj_set_style_text_color(s_vpot_lbl[i], lv_color_hex(COL_HEADER_BRIGHT), 0);
        lv_obj_set_style_text_font(s_vpot_lbl[i], &lv_font_montserrat_14, 0);
        lv_obj_set_style_text_align(s_vpot_lbl[i], LV_TEXT_ALIGN_CENTER, 0);
        lv_obj_set_style_bg_opa(s_vpot_lbl[i], LV_OPA_TRANSP, 0);
        lv_obj_set_style_border_width(s_vpot_lbl[i], 0, 0);
        lv_obj_set_style_pad_all(s_vpot_lbl[i], 0, 0);
        lv_label_set_long_mode(s_vpot_lbl[i], LV_LABEL_LONG_CLIP);
        lv_obj_clear_flag(s_vpot_lbl[i], LV_OBJ_FLAG_SCROLLABLE);
        lv_obj_clear_flag(s_vpot_lbl[i], LV_OBJ_FLAG_CLICKABLE);
        lv_label_set_text(s_vpot_lbl[i], "");
    }

    uiMenuInit(parent);
}

void uiHeaderUpdate() {
    if (g_currentPage != s_lastPage) updateNavButtons();

    // ── Indicador VPot Assignment ──────────────────────────────────
    if (s_assign_lbl && s_assign_cont) {
        static const char* ASSIGN_SHORT[6] = {"TRK","SND","PAN","PLG","EQ","INS"};
        static int8_t s_lastAssign = -1;
        int8_t active = -1;
        for (int a = 0; a < 6; a++) {
            if (btnStatePG1[a]) { active = a; break; }
        }
        if (active != s_lastAssign) {
            s_lastAssign = active;
            if (active >= 0) {
                lv_label_set_text(s_assign_lbl, ASSIGN_SHORT[active]);
                lv_obj_set_style_text_color(s_assign_lbl, lv_color_hex(COL_HEADER_BRIGHT), 0);
                lv_obj_set_style_border_color(s_assign_cont, lv_color_hex(COL_HEADER_BRIGHT), 0);
            } else {
                lv_label_set_text(s_assign_lbl, "--");
                lv_obj_set_style_text_color(s_assign_lbl, lv_color_hex(COL_HEADER_DIM), 0);
                lv_obj_set_style_border_color(s_assign_cont, lv_color_hex(COL_HEADER_DIM), 0);
            }
        }
    }

    if (needsHeaderRedraw) {
        needsHeaderRedraw = false;
        for (int i = 0; i < 8; i++) {
            if (s_vpot_lbl[i])
                lv_label_set_text(s_vpot_lbl[i], vpotAssignNames[i].c_str());
        }
    }

    if (!needsTimecodeRedraw) return;
    static uint32_t lastRedraw = 0;
    uint32_t now = millis();
    if (now - lastRedraw < 16) return;
    lastRedraw = now;
    needsTimecodeRedraw = false;
    if (!s_timecode || !s_tc_ghost) return;

    bool isBeats = (currentTimecodeMode == MODE_BEATS);

    // Indicador BEAT/SMPT
    if (s_mode_lbl) {
        lv_obj_t* lbl = lv_obj_get_child(s_mode_lbl, 0);
        if (lbl) lv_label_set_text(lbl, isBeats ? "BEAT" : "SMPT");
        applyModeState(isBeats);
    }

    // Indicador LOOP
    if (s_cycle_lbl) {
        lv_obj_t* lbl = lv_obj_get_child(s_cycle_lbl, 0);
        if (cycleActive) {
            lv_obj_set_style_bg_color(s_cycle_lbl, lv_color_hex(COL_AUTO_LATCH), 0);
            lv_obj_set_style_bg_opa(s_cycle_lbl, LV_OPA_COVER, 0);
            lv_obj_set_style_border_color(s_cycle_lbl, lv_color_hex(COL_AUTO_LATCH), 0);
            if (lbl) lv_obj_set_style_text_color(lbl, lv_color_white(), 0);
        } else {
            lv_obj_set_style_bg_opa(s_cycle_lbl, LV_OPA_TRANSP, 0);
            lv_obj_set_style_border_color(s_cycle_lbl, lv_color_hex(COL_HEADER_DIM), 0);
            if (lbl) lv_obj_set_style_text_color(lbl, lv_color_hex(COL_HEADER_DIM), 0);
        }
    }

    // Indicador RUDE SOLO
    if (s_solo_lbl) {
        lv_obj_t* lbl = lv_obj_get_child(s_solo_lbl, 0);
        if (rudeSoloActive) {
            lv_obj_set_style_bg_color(s_solo_lbl, lv_color_hex(COL_AUTO_LATCH), 0);
            lv_obj_set_style_bg_opa(s_solo_lbl, LV_OPA_COVER, 0);
            lv_obj_set_style_border_color(s_solo_lbl, lv_color_hex(COL_AUTO_LATCH), 0);
            if (lbl) lv_obj_set_style_text_color(lbl, lv_color_white(), 0);
        } else {
            lv_obj_set_style_bg_opa(s_solo_lbl, LV_OPA_TRANSP, 0);
            lv_obj_set_style_border_color(s_solo_lbl, lv_color_hex(COL_HEADER_DIM), 0);
            if (lbl) lv_obj_set_style_text_color(lbl, lv_color_hex(COL_HEADER_DIM), 0);
        }
    }

    // Indicador CLICK
    if (s_click_lbl) {
        lv_obj_t* lbl = lv_obj_get_child(s_click_lbl, 0);
        if (g_clickActive) {
            lv_obj_set_style_bg_color(s_click_lbl, lv_color_hex(COL_CLICK_ON), 0);
            lv_obj_set_style_bg_opa(s_click_lbl, LV_OPA_COVER, 0);
            lv_obj_set_style_border_color(s_click_lbl, lv_color_hex(COL_CLICK_ON), 0);
            if (lbl) lv_obj_set_style_text_color(lbl, lv_color_white(), 0);
        } else {
            lv_obj_set_style_bg_opa(s_click_lbl, LV_OPA_TRANSP, 0);
            lv_obj_set_style_border_color(s_click_lbl, lv_color_hex(COL_HEADER_DIM), 0);
            if (lbl) lv_obj_set_style_text_color(lbl, lv_color_hex(COL_HEADER_DIM), 0);
        }
    }

    // Conmutar SMPTE ↔ BEATS
    if (isBeats) {
        lv_obj_add_flag(s_timecode, LV_OBJ_FLAG_HIDDEN);
        lv_obj_add_flag(s_tc_ghost, LV_OBJ_FLAG_HIDDEN);
        for (int b = 0; b < 4; b++)
            if (s_beat_cont[b]) lv_obj_clear_flag(s_beat_cont[b], LV_OBJ_FLAG_HIDDEN);
        for (int i = 0; i < 3; i++)
            if (s_beat_dot[i]) lv_obj_clear_flag(s_beat_dot[i], LV_OBJ_FLAG_HIDDEN);
    } else {
        lv_obj_clear_flag(s_timecode, LV_OBJ_FLAG_HIDDEN);
        lv_obj_clear_flag(s_tc_ghost, LV_OBJ_FLAG_HIDDEN);
        for (int b = 0; b < 4; b++)
            if (s_beat_cont[b]) lv_obj_add_flag(s_beat_cont[b], LV_OBJ_FLAG_HIDDEN);
        for (int i = 0; i < 3; i++)
            if (s_beat_dot[i]) lv_obj_add_flag(s_beat_dot[i], LV_OBJ_FLAG_HIDDEN);
    }

    if (!hasDigit(timeCodeChars_clean)) return;

    if (isBeats) {
        static const int starts[4] = {0, 6, 4, 7};
        static const int counts[4] = {4, 1, 1, 3};
        static const int widths[4] = {4, 1, 1, 3};
        for (int b = 0; b < 4; b++) {
            if (!s_beat_real[b]) continue;
            // Extraer solo dígitos del buffer (ignorar espacios y chars no significativos)
            int val = 0;
            for (int j = 0; j < counts[b]; j++) {
                char c = (char)(beatsChars_clean[starts[b] + j] & 0x7F);
                if (c >= '0' && c <= '9') val = val * 10 + (c - '0');
            }
            // Formatear con ceros a la izquierda según ancho requerido
            char display[8] = {};
            for (int p = widths[b] - 1; p >= 0; p--) {
                display[p] = '0' + (val % 10);
                val /= 10;
            }
            lv_label_set_text(s_beat_real[b], display);
        }
    } else {
        lv_label_set_text(s_timecode, formatTimecodeString().c_str());
        lv_label_set_text(s_tc_ghost, "00:00:00: 00");
    }
}

void uiHeaderDestroy() {
    uiMenuDestroy();
    for (int i = 0; i < 8; i++) {
        if (s_vpot_lbl[i]) { lv_obj_delete(s_vpot_lbl[i]); s_vpot_lbl[i] = NULL; }
    }
    for (int b = 0; b < 4; b++) {
        if (s_beat_cont[b]) {
            lv_obj_delete(s_beat_cont[b]);  // borra contenedor + hijos
            s_beat_cont[b]  = NULL;
            s_beat_ghost[b] = NULL;
            s_beat_real[b]  = NULL;
        }
    }
    for (int i = 0; i < 3; i++) {
        if (s_beat_dot[i]) { lv_obj_delete(s_beat_dot[i]); s_beat_dot[i] = NULL; }
    }
    if (s_vu_hit)     { lv_obj_delete(s_vu_hit);     s_vu_hit     = NULL; }
    if (s_bo_hit)     { lv_obj_delete(s_bo_hit);     s_bo_hit     = NULL; }
    if (s_vu_lbl)     { lv_obj_delete(s_vu_lbl);     s_vu_lbl     = NULL; }
    if (s_bo_lbl)     { lv_obj_delete(s_bo_lbl);     s_bo_lbl     = NULL; }
    if (s_assign_cont) { lv_obj_delete(s_assign_cont); s_assign_cont = NULL; s_assign_lbl = NULL; }
    if (s_click_hit)  { lv_obj_delete(s_click_hit);  s_click_hit  = NULL; }
    if (s_solo_hit)   { lv_obj_delete(s_solo_hit);   s_solo_hit   = NULL; }
    if (s_cycle_hit)  { lv_obj_delete(s_cycle_hit);  s_cycle_hit  = NULL; }
    if (s_mode_hit)   { lv_obj_delete(s_mode_hit);   s_mode_hit   = NULL; }
    s_lastPage = 255;
    if (s_click_lbl)  { lv_obj_delete(s_click_lbl);  s_click_lbl  = NULL; }
    if (s_cycle_lbl)  { lv_obj_delete(s_cycle_lbl);  s_cycle_lbl  = NULL; }
    if (s_solo_lbl)   { lv_obj_delete(s_solo_lbl);   s_solo_lbl   = NULL; }
    if (s_mode_lbl)   { lv_obj_delete(s_mode_lbl);   s_mode_lbl   = NULL; }
    if (s_tc_frame)   { lv_obj_delete(s_tc_frame);   s_tc_frame   = NULL; }
    if (s_tc_ghost)  { lv_obj_delete(s_tc_ghost);  s_tc_ghost  = NULL; }
    if (s_timecode)  { lv_obj_delete(s_timecode);  s_timecode  = NULL; }
    if (s_strip)     { lv_obj_delete(s_strip);      s_strip     = NULL; }
}

void uiHeaderEnsureCreated(lv_obj_t* parent) {
    if (s_strip) return;
    uiHeaderCreate(parent);
}
