juliannof/AITEC-17/(commit log)

2026-05-19 FIX: S2 GOING_TO_MIN — stall detection evita motor apretado en tope (2026-05-19 15:49)
    MOTOR_ADC_MIN+10=30 era inalcanzable (mín físico ~44) → motor apretado
    indefinidamente contra tope mecánico → calentamiento.
    Solución: detección por stall (ADC sin cambio 400ms) + threshold +60.
    config.h: GOTO_MIN_STALL_MS=400, _goToMinStallStart, _goToMinLastADC
    Motor.cpp: GOING_TO_MIN evalúa stall antes de hwOff + transición
    [Motor.cpp, config.h]
2026-05-19 FIX+DOCS: S2 protección global topes mecánicos (2026-05-19 15:49)
    Motor.cpp: _hwOff/_hwUp/_hwDown setean _motor_hw_active (fuente verdad HW)
    Motor.cpp update(): guard global — motor activo + ADC sin cambio 400ms → hwOff
    CALIBRATING excluido (tiene CALIB_STUCK_TIMEOUT propio por fase)
    config.h: STALL_PROTECT_MS=400, _motor_hw_active, _stallProtectStart/LastADC
    MOTOR.md: sección §2.6 exhaustiva — incidente, causa, solución, cobertura
    FADER.md: §3.4 y §10 — lección topes físicos ≠ MOTOR_ADC_MIN
    CHANGELOG.md: entrada completa con lección permanente
    [Motor.cpp, config.h]
2026-05-19 FIX: fader bidireccional — S3 HALT + motor auto-interrupción + feedback (2026-05-19 18:53)
    S3:
    - HALT eliminado en operación normal (solo durante calibración activa)
    - Re-calibración innecesaria en Logic connect eliminada (0x21 + PitchBend)
    - POLL_CYCLE_MS 20→10ms (100Hz, latencia reducida)
    - EMA bypassed cuando touchState=1 (feedback físico inmediato)
    - Profiler reducido a 1000 ciclos, sin verbose
    - Logs diagnóstico: [FADER→LOGIC] touchState, [S3-RX] touch
    S2:
    - MOVING_TO_TARGET añadido a inCalibFlow en setADCDelta() — evita auto-detección
    - setADC() bypass spike guard cuando _motor_manualTouchDetected
    - setADCDelta() timer refresh en cada movimiento, reset sin FaderTouch
    -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
    [Motor.cpp, Motor.h, RS485.cpp, RS485Handler.cpp, config.h, main.cpp]
2026-05-19 DOCS: corrige alt text imagen S3 README — ESP32-S3-DevKitC-1 (2026-05-19 19:03)
2026-05-19 DOCS: pendientes — S3 boot 4 fases + P4 config.h PSRAM (2026-05-19 19:03)
2026-05-19 DOCS: pendientes próxima sesión — MIDI deadband, validación S3/P4, P4 docs (2026-05-19 19:03)
2026-05-20 DOCS: agrega pendiente — S3 nombre de pista en slaves (2026-05-20 06:54)
    S3 envía nombre de pista pero no está garantizado que los slaves
    lo reciban/muestren. Requiere auditoría protocolo RS485 y validación.
2026-05-20 DOCS: detalla pendiente S3 — nombres de pista muestran Pan/Seleccion (2026-05-20 06:55)
    Slaves S2 muestran "Pan" y "Seleccion" en lugar de nombres reales
    enviados por S3. Requiere auditoría protocolo RS485 y protocolo SysEx.
2026-05-20 DOCS: precisa bug S3 — nombre de pista no se borra, sobreposición caracteres (2026-05-20 06:56)
    Display S2 no borra nombre anterior cuando recibe nuevo.
    Causa: buffer clear, protocolo RS485, o display no limpia antes escribir.
2026-05-20 FIX: Motor S2 vibración reposo + S3 NUM_SLAVES=2 (2026-05-20 08:09)
    Motor S2 — 4 fixes vibración en reposo:
    1. setTargetFromS3(): guard AT_TARGET+DEAD_ZONE — no reactivar si ya en posición
    2. _hwOff(): EN desactivado PRIMERO, antes de cambiar PWM (elimina pulso espurio)
    3. IDLE state: _hwOff() solo si _motor_hw_active (evita llamadas redundantes)
    4. AT_TARGET state: _hwOff() solo si _motor_hw_active
    S3 config.h: NUM_SLAVES 1→2 (2 esclavos en bus B)
    DOCS: CHANGELOG.md y MIDI.md actualizados
    [Motor.cpp, config.h]
2026-05-20 CHORE: añade .claude/ a .gitignore (2026-05-20 08:09)
    Evita que settings.json y memoria de Claude Code se suban accidentalmente a GitHub.
2026-05-20 FIX: S3 Bug B2 nombres pista + S2 spike guard setADCDelta (2026-05-20 17:25)
    S3 MIDIProcessor.cpp: guard contra row 1 vacía en SysEx 0x12 —
    Logic envía row 1 = todo espacios en modo plugin/Atmos, S3 borraba
    trackNames[]. Fix: ignorar update si nameBufs[t][0] == '\0' tras trimRight.
    S2 Motor.cpp setADCDelta(): spike guard antes de calcular delta —
    spike eléctrico (ej: ADC 7284→29) re-disparaba _motor_manualTouchDetected
    justo tras el debounce, bloqueando indefinidamente targets de S3.
    Fix: si raw ADC salta >ADC_SPIKE_GUARD desde _motor_adcPos filtrado
    y flag=false, ignorar sin actualizar referencia.
    [Motor.cpp]
2026-05-20 FIX: S2 DEAD_ZONE 50→80 — cubre ruido ADC S1 en reposo (2026-05-20 17:27)
    S1 oscila 60 cuentas en reposo (120-180). Con DEAD_ZONE=50 el ruido
    superaba el umbral y disparaba MOVING_TO_TARGET intermitentemente.
    80 cubre el peor caso con 20 cuentas de margen (0.3% del recorrido).
    [config.h]
2026-05-20 DOCS: Bug B3 — fader 2 sube al inicializar Logic sin proyecto (2026-05-20 17:45)
    Pendiente investigar: capturar PitchBend slot 1 vs slot 2 en GoOnline
    sin proyecto, comparar calibratedMin entre unidades.
2026-05-20 CHORE: elimina WiFiManager + docs SAT OTA + changelog sesión tarde (2026-05-20 18:38)
    OtaManager: launchPortal() era código muerto — eliminado junto con
    #include <WiFiManager.h> y defines PORTAL_SSID/PORTAL_TIMEOUT.
    SAT.md §7: documentación OTA completa — flujo ElegantOTA, URL upload,
    credenciales NVS, provisioning sketch, fix pines al aire (safePins),
    troubleshooting OTA.
    CHANGELOG: resumen sesión tarde con fixes B2/spike guard/DEAD_ZONE/OTA.
    [Otamanager.cpp, Otamanager.h]
2026-05-20 DOCS: pendiente branding S2 iMakie→AITEC 17 (baja prioridad) (2026-05-20 18:55)
2026-05-23 FIX: B4/B5/B6 + S3 grace period cascada calibración (2026-05-23 10:57)
    B4 (S2) — CALIBRADO OK con MAX=0:
    RS485Handler.cpp buildResponse(): elimina SLAVE_FLAG_CALIB_DONE del
    paquete MIN (estado 0). S3 ahora recibe MIN→MAX→CALIB_DONE en orden
    correcto. Validado hardware: MIN=47 MAX=26445.
    B5 (S2) — Timeout periódico exacto 2001ms:
    Causa: USB CDC backpressure por logs verbose durante calibración
    (~80 log_i en 250ms = 16kB/s vs límite ~12kB/s USB CDC).
    Motor.cpp: KICK_UP log_i→log_d (línea 85) + KICK_DOWN log_i→log_d (161).
    FaderADC.cpp: periodic 500ms log_i→log_v (línea 68). Pendiente validación.
    B6 (S3) — HALT por timeout RS485 nunca activa:
    RS485.cpp l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
    [FaderADC.cpp, FaderADC.h, Motor.cpp, RS485.cpp, RS485.h, RS485Handler.cpp, config.h]
2026-05-23 FIX: B7 requestCalibration() guard — no interrumpir calibración activa (2026-05-23 11:29)
    Motor.cpp requestCalibration() (línea 633):
    S3 envía FLAG_CALIB cada 10ms. En cuanto el motor entra en KICK_UP y
    el ADC sube por encima de MOTOR_ADC_MIN+10 (=30), la siguiente llamada
    a requestCalibration() detecta _motor_state==CALIBRATING (!= GOING_TO_MIN)
    y sobreescribe el estado a GOING_TO_MIN, interrumpiendo la calibración.
    Motor subía un poco, bajaba, volvía a 0, reiniciaba — bucle infinito
    que nunca alcanzaba CalibPhase::DONE.
    Fix: guard idempotente al inicio de requestCalibration():
    if (_isCalibrating() || _motor_state == MotorState::CALIBRATING) return;
    Explica p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
    [Motor.cpp]
2026-05-23 FEAT: versionado FW automático 0.MINOR.PATCH desde HW_STATUS + FW_REVISION (2026-05-23 11:31)
    - pre_build.py: fw_ver derivado de config.h (MINOR=count(status==2), PATCH=FW_REVISION)
    - config.h S2: Touch=0 (inoperativo), añade #define FW_REVISION 2
    - CLAUDE.md: directiva vinculante FW_REVISION — incrementar por sesión funcional
    - CHANGELOG.md: sesión documentada con esquema de versión
2026-05-23 FIX: particiones S3 16MB sin OTA — default_16MB.csv vacío corregido (2026-05-23 11:39)
    - default_16MB.csv: nvs 20KB + app0 factory 14.93MB + littlefs 1MB
    - Elimina app1/otadata (S3 no tiene OTA)
    - Corrige flash reportada: 6.25MB (fallback 8MB) → 14.93MB (N16R8 real)
    [default_16MB.csv]
2026-05-23 FIX: S3 flash 16MB real — particiones + warnings USB (2026-05-23 11:49)
    - s3_extender_16MB.csv: tabla sin OTA, app0 factory 14.93MB + littlefs 1MB
    - platformio.ini: renombrado CSV, board_upload.maximum_size=16777216
    - Eliminados flags USB redundantes (board ya defaultea TinyUSB, MIDI OK)
    - Validado: RAM 14.6% / Flash 2.5% de 16MB reales
    [s3_extender_16MB.csv]
2026-05-23 FEAT: versionado S2 automático por upload + hook pre-commit (2026-05-23 12:38)
    - pre_upload.py: bump FW_REVISION + log CHANGELOG en cada flash
    - pre-commit hook: bump FW_REVISION si commit S2 sin upload previo
    - platformio.ini: registra pre_upload.py en ambos envs (USB + OTA)
    - config.h: HW_STATUS actualizado con doc detallada + HW_DISPLAY subsistemas
    Motor=1 RS485=1 Display=2 ADC=2 Fader=1 FaderTouch=1 NeoPixels=2 Encoder=1 Buttons=2
    TouchFader→FaderTouch, Touch eliminado
    - pre_build.py: hw_components actualizado (9 sistemas)
    - CLAUDE.md: directiva FW_REVISION actualizada — automático, no tocar manualmente
    - Validaciones hardware pendientes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
2026-05-23 FIX B5: FaderTouch fuera del path crítico RS485 — timeouts ~2001ms
    Causa raíz: FaderTouch::update() (16×touchRead) y un sistema touch
    legacy en Hardware.cpp (1×touchRead) bloqueaban el loop ANTES de
    rs485.sendResponse(), causando timeouts periódicos en S3.
    - main.cpp: FaderTouch::update() movido a después de sendResponse()
    - config.h: TOUCH_BASELINE_SAMPS 16→3 (73% menos touchRead por poll)
    - Hardware.cpp/h: eliminado sistema touch legacy completo (isFaderTouched,
    callbacks, initHardware calibración 20×touchRead+delay, updateButtons touchRead)
    [Hardware.cpp, Hardware.h, config.h, main.cpp]
2026-05-24 FEAT S3: fader S2→Logic feedback — jerarquía master + mapeo calibrado (2026-05-24 11:31)
    - Mapeo S2→Logic usa rango calibrado real (calibratedMin/Max), no 27000 fijo
    - Path A: touchState=1 → PitchBend inmediato sin deadband (usuario es master)
    - Path B: sync con FADER_SYNC_DEADBAND=200 PB counts cuando motor settled
    - Guard motorSettled: MOTOR_SETTLE_THRESHOLD=80 ADC (= DEAD_ZONE S2)
    · Suprime sync durante movimiento de motor (Logic es master)
    · Suprime sync en stall físico (|faderPos-target|=192 > 80 → no reporta posición imposible)
    - S2: FW_REVISION 4→5 (bump automático flash anterior)
    [config.h, main.cpp]
2026-05-24 FIX S2: detección movimiento usuario durante MOVING_TO_TARGET (2026-05-24 11:40)
    Motor::setADCDelta() bloqueaba completamente la detección de usuario cuando
    el motor estaba en MOVING_TO_TARGET — el usuario no podía tomar control
    mientras el motor seguía un target de Logic.
    Causa original: motor rápido genera delta > MANUAL_TOUCH_THRESHOLD (150) en
    su propia dirección, disparando falsas detecciones de "usuario master".
    Fix: detección por dirección — solo suprimir cuando el ADC va en la misma
    dirección que el target (motor haciendo su trabajo). Si el ADC va en
    dirección contraria, el usuario se está oponiendo → detección normal.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
    [Motor.cpp, config.h]
2026-05-24 DOCS: marcar fader S2→Logic pendiente validación hardware (2026-05-24 11:40)
2026-05-24 DOCS P4: estado completo, bugs UIHeader, handshake MIDI dual, feature 16ch (2026-05-24 12:44)
    - docs/S3ToP4.md (nuevo): diferencias MIDI S3→P4, 9 bugs documentados (fader mapping,
    deadband, ghost text, BEAT/SMPT toggle, touch header), feature 16 pistas via MIDI UART,
    captura dual P4+S3 handshake con análisis extenso por sección
    - docs/MIDI.md sección 3.4: secuencia arranque dual Logic Pro con MIDI Monitor real —
    sondeo 5 familias, 8 comandos decodificados (0x20/0x0A/0x0E/0x0C/0x0B/0x72/0x12/0x21),
    bug handshake S3 (3 reintentos/3s), broadcasts globales, capture raw completo
    - MASTER_S3-P4/P4/README.md: 7 inconsistencias corregidas (PSRAM 32MB, CPU 400MHz,
    USB mode, partició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
2026-05-24 DOCS: OTA WiFi S2 como próxima prioridad — desbloquea ajuste fino (2026-05-24 12:44)
2026-05-26 FIX S2: OTA WiFi + VUMeter optimización — 2026-05-26 17:48
    OTA WiFi S2:
    - main.cpp: bloque safePins (OUTPUT LOW) al inicio de setup() — corrige Bug #1
    GPIO flotantes ciegan radio WiFi en OTA-only mode
    - OtaManager.cpp: pasar otaPass a ElegantOTA.begin() — Basic Auth ahora activo
    - S2/provisioning/: sketch provisioning sanitizado (sin credenciales)
    - docs/WIFI.md → WIFI-OTA.md (renombrado) + Bug #1 documentado §5.3
    - Credenciales reales eliminadas de todos los documentos públicos
    VUMeter S2 (sesión 2026-05-26):
    - Display.cpp: dibujo diferencial segmento a segmento directo a tft
    eliminado vuSprite — 27.6 KB PSRAM liberados, ~20x menos SPI
    - RS485Handler.cpp: attack instantá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
    [Display.cpp, Display.h, RS485Handler.cpp, config.h, main.cpp, provisioning.ino]
2026-05-26 FIX S2: namespace VU declarado antes de updateDisplay() — 2026-05-26 17:48
    Error de compilación: 'VU' has not been declared (Display.cpp:168)
    Causa: namespace VU definido en línea 319, usado en updateDisplay() línea 168
    Fix: mover namespace VU antes de updateDisplay()
    [Display.cpp, config.h]
2026-05-26 FEAT S2: VUMeter peak — segmento encendido estilo hardware — 2026-05-26 17:50
    Peak indicator cambiado de borde blanco a segmento ON en su color natural
    (verde/amarillo/rojo). El segmento más alto permanece encendido mientras
    el nivel decae por debajo — comportamiento idéntico a VU de hardware real.
    vuSegColor(): peak devuelve color ON en vez de OFF+borde
    vuDrawSeg(): eliminado parámetro peakBorder (ya no hay decoración)
    drawVUMeters(): lógica simplificada, diferencial limpio cNow != cPrev
2026-05-26 CHORE S2: eliminar entorno lolin_s2_mini_ota — 2026-05-26 18:00
    Entorno roto (espota.py incompatible con ElegantOTA HTTP) y con
    credencial expuesta en upload_flags. OTA via browser es suficiente
    para el workflow actual. Eliminados: env lolin_s2_mini_ota + upload_ota.py.
2026-05-26 CHORE S2: retirar WiFiManager de lib_deps — 2026-05-26 18:05
    Librería eliminada del código en sesión 2026-05-20, quedaba huérfana
    en platformio.ini. Sin impacto en compilación ni funcionalidad.
2026-05-26 FIX S3: VU decay — timeout Channel Pressure 200ms — 2026-05-26 18:05
    Cuando Logic para de enviar audio, deja de mandar Channel Pressure.
    S3 mantenía el último vuLevel indefinidamente → S2 nunca decaía.
    Fix: check cada 50ms — si vuLevels[i] > 0 y sin CP en >200ms →
    setVuLevel(i+1, 0) → S2 recibe 0 → handleVUMeterDecay() decae.
    [main.cpp]
2026-05-26 DOCS: sesión 2026-05-26 — OTA WiFi + VUMeter completo
2026-05-26 FIX S2: VU decay — vuLastUpdateTime solo al subir, no en cada paquete — 2026-05-26 18:13
    RS485 llega cada ~10ms. Resetear vuLastUpdateTime en cada paquete con
    newVu > 0.01f impedía que handleVUMeterDecay() viera el gap de 100ms.
    Fix: mover vuLastUpdateTime = millis() dentro del bloque de subida.
    Decay ahora funciona cuando audio para.
    [RS485Handler.cpp, config.h]
2026-05-26 FEAT S2: VU peak fade SSL-style + OTA Basic Auth
    VU peak (Display.cpp):
    - blendColor565(): interpolación RGB565 para fade suave
    - vuSegColor(): acepta peakAlpha — fade ON→OFF durante extinción
    - drawVUMeters(): diferencial incluye peakAlpha/lastPeakAlpha
    - handleVUMeterDecay(): hold 1s + fade 100ms (SSL-style, 4 pasos×25ms)
    - RS485Handler: vuLastUpdateTime solo sube cuando VU sube — fix decay timer
    OTA (OtaManager.cpp):
    - ElegantOTA.begin() con Basic Auth — otaPass de NVS activo (2026-05-26 18:39)
    Docs: DISPLAY.md §10 VU Meter completo, CHANGELOG sesión 2026-05-26
    [Display.cpp, Otamanager.cpp, config.h]
2026-05-26 FIX S3: calibración robusta — bypass en vez de HALT (2026-05-26 19:53)
    - calibRetries solo incrementa cuando calibrating==true (guard)
    → antes: 5 paquetes ERROR == HALT prematuro en ~100ms
    → ahora: 5 intentos reales == bypass, cascada continúa
    - Bypass tras MAX_CALIBRATION_RETRIES: slave opera con rango teórico 0-27000
    → permite identificar hardware defectuoso sin parar el sistema
    → setCalibrate(id) disponible para re-intentar manualmente
    - calibRetries=0 al arrancar cada nuevo intento (auto-calib + cascada)
    - setCalibrate() resetea calibrated+calibRetries para permitir re-calibrar bypass
    [RS485.cpp, config.h]
2026-05-26 FIX S2: display muestra NO CAL si fader no calibrado (2026-05-26 19:58)
    Motor::isCalibrated() false → "NO CAL" naranja donde normalmente aparece el dB.
    Identifica hardware díscolo sin serial ni pantalla externa en producción.
    [Display.cpp, config.h]
2026-05-26 DOCS: bug dB fader intermitente documentado en DISPLAY.md (2026-05-26 20:00)
    faderPositions = target de Logic, no posición ADC real.
    Documenta causa, escenarios de error y fix pendiente (Motor::getPosition()).
2026-05-26 FIX S2: motor sigue targets aunque calibración falle (2026-05-26 20:09)
    Calibración ERROR → rango teórico (MOTOR_ADC_MIN–MAX) + motor operativo.
    setTargetFromS3 desbloqueado: comprueba adcSpan>0 en vez de phase==DONE.
    isCalibrated() sigue devolviendo false → display "NO CAL" identifica díscolo.
    [Motor.cpp, config.h]
2026-05-26 REVERT S2: deshacer cambios Motor bypass y Display NO CAL (2026-05-26 20:12)
    Cambios implementados sin aprobación explícita del usuario.
    Motor.cpp: revertir bypass rango teórico en calibración ERROR.
    Display.cpp: revertir include Motor.h y texto NO CAL.
    [Display.cpp, Motor.cpp, config.h]
2026-05-26 FIX S3: calibración con cascade wraparound — sin bypass, sin HALT (2026-05-26 20:20)
    _triggerNextCalibration(): busca siguiente slave sin calibrar, con wraparound.
    - Cascade avanza aunque un slave falle (sin bloquearse)
    - Al completar todos, vuelve al díscolo y reintenta indefinidamente
    - Sin bypass de rango teórico: slave calibra o sigue intentando
    MAX_RETRIES: reset calibRetries + _triggerNextCalibration (no más bypass)
    calibDone: _triggerNextCalibration reemplaza cascade hardcoded
    [RS485.cpp, RS485.h]
2026-05-26 FIX S3: calibración finita — skip definitivo si calibRetries>=MAX (2026-05-26 20:24)
    No resetear calibRetries al agotar presupuesto → _triggerNextCalibration lo salta.
    Proceso termina cuando todos están calibrados o descartados.
    Log final lista slaves defectuosos por ID.
    [RS485.cpp]
2026-05-27 FIX S2+S3: KICK_UP stuck + touchState reset + detección reinicio slave (2026-05-27 17:01)
    S2 Motor.cpp:
    - KICK_UP: stuck detection 1000ms — si ADC estable y <26000, asume tope físico → GOING_UP
    - setADCDelta(): resetear _motor_manualTouchDetected=false en inCalibFlow — evita touchState=1 persistente durante calibración
    S3 RS485.cpp:
    - _handleResponse() else block: detectar reinicio de slave — si calibrated=true pero sin SLAVE_FLAG_CALIB_DONE → recalibrar automáticamente
    [Motor.cpp, RS485.cpp, config.h]
2026-05-27 FIX S3: 0x61 no desconecta slaves + transport LEDs off on disconnect (2026-05-27 17:30)
    S3 MIDIProcessor.cpp:
    - case 0x61: eliminar g_logicConnected=0 — AllFadersToMinimum no debe desconectar S2s
    (Logic envía 0x61 en GoOnline → zeroeaba g_logicConnected → S2s siempre apagados)
    Ahora solo resetea faderTarget a 0 en todos los slaves
    - case 0x0F + disconnect PitchBend: Transporte::setAllLedsOff() al desconectar
    S3 Transporte.cpp/.h:
    - Nueva función setAllLedsOff() — apaga los 5 LEDs de transporte
    S2 RS485Handler.cpp:
    - onMasterData() CONNECTED: setScreenBrightness(255) al conectar (restaura brillo)
    S2 README.md:
    - Tabla de sistemas S2: Motor, FaderADC, FaderTouch, ButtonManager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
    [RS485Handler.cpp, Transporte.cpp, Transporte.h, config.h]
2026-05-27 DOCS: documentación extensiva sesión 2026-05-27 (2026-05-27 17:45)
    RS485.md:
    - §4.4 nueva sección: detección de reinicio de slave con mecanismo completo,
    guards, flujo y logs esperados
    - §6.1 troubleshooting: +2 filas (slave no recalibra, pantalla oscura)
    - Últimas actualizaciones
    Transport.md:
    - Reescritura completa con implementación real vs pseudocódigo anterior
    - §3 Comportamiento por estado de conexión — tabla completa
    - §4.2 Bug 0x61 documentado exhaustivamente (causa, efecto, fix)
    - §4.3 Secuencia GoOffline completa con setAllLedsOff
    - §5.3 Flujo botón→Logic→LED con latencias
    - §6 Troubleshooting actualizado
    CHANGELOG.md:
    - Sesión 2026-05-27 17:14: fix 0x61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
2026-05-27 UX S2: pantalla OTA rediseñada — header rojo + IP octeto grande (2026-05-27 17:48)
    OtaManager.cpp enableForUpload():
    - Brillo 20 → 200 (legible)
    - Header barra roja "WiFi OTA" (Font 4 blanco)
    - Subtítulo "Esperando upload..." (gris)
    - Último octeto IP Font 7 size 2 rojo centrado (~96px)
    - IP completa pequeña al fondo (referencia)
2026-05-27 FIX S2: brillo pantalla a config.h — valores revisados (2026-05-27 17:42)
    - config.h: 4 defines BRIGHTNESS_SPLASH/SELECTED/UNSELECTED/OTA (50/180/70/50)
    - main.cpp: boot splash a BRIGHTNESS_SPLASH (50)
    - Display.cpp: selectStates usa BRIGHTNESS_SELECTED/UNSELECTED (180/70)
    - RS485Handler: CONNECTED→BRIGHTNESS_SELECTED; DISCONNECTED→drawSplashScreen()+BRIGHTNESS_SPLASH
    - OtaManager: pantalla OTA a BRIGHTNESS_OTA (50)
    - Al desconectar Logic: pantalla vuelve a splash en lugar de apagarse a negro
    [Display.cpp, Otamanager.cpp, RS485Handler.cpp, config.h, main.cpp]
2026-05-27 FIX S2: splash screen — iMakie → AITEC17 (2026-05-27 17:42)
    [Display.cpp, config.h]
2026-05-27 FIX S3: eliminar HALT en RS485 — skip+cascade en timeout calibración (2026-05-27 18:00)
    Causa del bug: reflash S2 causa timeouts transitorios → si slave tenía
    calibrated=true y reboot detection disparaba calibrating=true →
    5 timeouts consecutivos → while(1) en Core 1 → S2s muertos para siempre.
    Fix: reemplazar while(1) por skip+cascade (igual que calibError path).
    NeoPixel ROJO se mantiene como señal visual. Sistema nunca se detiene.
    [RS485.cpp]
2026-05-27 FIX S2: calibración robusta + toque selecciona pista (2026-05-27 22:23)
    Calibración:
    - GOING_UP stuck → SETTLE_UP en vez de KICK_DOWN (registra tope real)
    - GOING_DOWN stuck → SETTLE_DOWN en vez de ERROR (registra fondo real)
    - KICK_DOWN: añade stuck detection simétrica a KICK_UP (tope físico > 200 ADC)
    - SETTLE_UP usa _motor_settleMax como _motor_adcTop (máximo real, no instantáneo)
    - SETTLE_DOWN usa _motor_settleMin como adcBot (mínimo real, no instantáneo)
    - ADC_STABILITY_THRESHOLD 100 → 200 (tolera ruido EMF en topes mecánicos)
    Detección toque:
    - Threshold adaptativo: 50 cuentas en AT_TARGET/IDLE, 150 en MOVING_TO_TARGET
    - MANUAL_TOUCH_DEBOUNCE_MS 200 → 600 ms (cede c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
    [Motor.cpp, RS485Handler.cpp, config.h]
2026-05-27 DOCS: CHANGELOG sesión 2026-05-27 22:23 — calibración S2 + toque SELECT
2026-05-27 FIX S2: touchState=0 durante calibración — no enviar toque ni SELECT a Logic (2026-05-27 22:38)
    Durante CALIBRATING/GOING_TO_MIN el motor mueve el fader activamente.
    El delta del movimiento del motor disparaba touchState=1 y FLAG_SELECT,
    enviando PitchBend salvajes a Logic y seleccionando pistas no intencionadas.
    Fix: buildResponse() fuerza touchState=0 y bloquea SELECT cuando
    motorState == CALIBRATING || GOING_TO_MIN.
    [RS485Handler.cpp, config.h]
2026-05-27 DOCS: CHANGELOG FW 0.4.18 — resumen 13 cambios vs FW 0.4.13 (2026-05-27 23:00)
    Tabla consolidada de fixes pendientes de flash: calibración robusta,
    detección usuario, toque→SELECT, touchState=0 en calib, UI splash+OTA.
2026-05-27 DOCS: marcar código muerto Motor S2 como pendiente en CHANGELOG (2026-05-27 23:00)
    4 items auditados: WAITING_FOR_CALIB, _motor_goingToMin, setUserDropTarget(),
    goToMin() sin state assignment. Sin impacto activo, limpieza futura.
2026-05-27 FIX S2+S3: SELECT pista — mover lógica a S3 vía touchState (2026-05-27 23:13)
    S2: eliminar FLAG_SELECT de buildResponse() — un solo paquete era frágil.
    S3: rising/falling edge de touchState → Note On/Off SELECT (24+midiCh),
    mismo comportamiento que botón físico.
    [RS485Handler.cpp, config.h, main.cpp]
2026-05-27 DOCS: CHANGELOG sesión 2026-05-27 23:13 — SELECT S3 vía touchState
2026-05-27 FIX S2: toque fader — delta ventana 80ms + margen calib fijo (2026-05-27 23:24)
    Touch: delta medido en ventana 80ms (antes: tick a tick ~5ms) → detecta
    movimientos lentos. Threshold AT_TARGET 50→30 cuentas/ventana.
    Calibración: margen fijo 20 cuentas (antes: noiseSpan×2 ≈400) → faders
    llegan a extremos físicos. DEAD_ZONE=80 ya protege los topes.
    [Motor.cpp, config.h]
2026-05-27 FIX S3: snap zone extremos fader — -inf y +6dB exactos en Logic (2026-05-27 23:30)
    Fader dentro de 79 cuentas de calibratedMin/Max → reporta exactamente
    el límite calibrado → PB=0 (-inf) y PB=max (+6dB) en Logic.
    SNAP_ZONE=79 = DEAD_ZONE-1: motor queda en AT_TARGET sin hunting.
    [main.cpp]
2026-05-27 DOCS: pendiente fader extremos — snap zone requiere calibración (2026-05-27 23:40)
2026-05-30 FEAT S2: AutoMode awareness fader — routing OFF/READ/WRITE/TRIM/TOUCH/LATCH (2026-05-30 10:10)
    Motor::setTargetForced() para DAW absoluto (OFF/READ, bypass guard usuario).
    RS485Handler::Internal::_applyFaderTarget() como punto único de decisión por modo.
    touchState reportado con debounce específico por modo (80ms TOUCH/TRIM, 300ms LATCH).
    LATCH freeze: captura posición física hasta que Logic envíe target >200 cuentas.
    HW_STATUS: Fader=2 (mapeo + AutoMode routing completo). MINOR bump 4→5.
    docs/AUTOMODE.md nuevo. MOTOR.md + RS485.md actualizados.
2026-05-30 FIX C3: RELAY_ACTIVATION_TIME 15s → 2s (2026-05-30 10:10)
    [config.h]
2026-05-30 FIX P4: UIOffline sin marco/esquinas redondeadas del tema LVGL (2026-05-30 11:50)
    s_root heredaba radius+border del tema por defecto → recuadro redondeado
    no deseado en la pantalla "Esperando Logic Pro...". Añadido border_width=0
    y radius=0, alineándola con UIPage1 y Display.cpp.
    DOCS P4: DISPLAY_P4.md reescrito a la realidad del código (driver custom
    ESP-IDF ST7701S + LVGL v9, corregidas refs a LovyanGFX/v8). Nuevas secciones:
    §3 orientación portrait→landscape (rotación per-widget) y §4 pantalla de
    botones UIPage1 (mapa completo de los 32 botones MCU). README P4 referencia.
    [UIOffline.cpp]
2026-05-30 FIX RS485/timing: timeout S3 8ms + log throttle S2 + P4 NUM_SLAVES=0 (2026-05-30 11:50)
    - S3 config.h: RS485_RESP_TIMEOUT_US 5000→8000µs (margen para loop S2 variable)
    - S2 Motor.cpp: throttle log setTargetForced a 1×/2s (evita USB CDC bloat en path crítico)
    - S2 RS485Handler.cpp: log diagnóstico [FADER] target/adc/diff/mode a 500ms
    - P4 config.h: NUM_SLAVES 9→0 (P4 sin slaves actualmente)
    - CHANGELOG: sesión debugging RS485 timeouts (10:30) + pendientes ADS1115 no lineal
    [Motor.cpp, RS485Handler.cpp, config.h]
2026-06-09 STRUCT P4: migración placa JC4880P433C → JC1060P470C — split de subproyecto (2026-06-09 18:07)
    - git mv P4/ → P4_JC4880P433C/ (legado, histórico preservado)
    - nueva copia P4_JC1060P470C/ (base activa de migración, sin .pio)
    - platformio.ini + CLAUDE.md: paths y árbol de carpetas a ambas placas
    - sin cambios de lógica: RS485/MIDI/máquina de estados idénticos
2026-06-09 WIP P4 JC1060P470C: driver JD9165 + diagnóstico de errores de migración (2026-06-09 23:22)
    Estado: punto funcional — display JD9165 enciende y muestra UIOffline landscape.
    UIHeader/UIPage3 revertidos a portrait original (rediseño landscape pendiente).
    Cambios:
    - Driver display ST7701 → JD9165 vendorizado en src/lcd/ (esp_lcd_jd9165 v2.0.2)
    - config.h: 1024x600, pines JD9165 (RST27/BL23) + GT911 (SDA7/SCL8), NUM_SLAVES=0, NeoTrellis eliminado
    - Display.cpp: structs DSI/DBI/DPI a mano (macros JD9165 son C99), I2C_NUM_1, touch sin pull-up, guard GT911
    - UIOffline migrado a landscape (sin rotación)
    - main.cpp: Serial.setTxTimeoutMs(0)
    MIGRATION_NOTES.md documenta causa raíz de 5 error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
    [Display.cpp, UIOffline.cpp, config.h, main.cpp, pins_config.h]
2026-06-09 FIX P4 JC1060P470C: display JD9165 + touch GT911 FUNCIONAN (driver del fabricante) (2026-06-09 23:54)
    Causa raíz: el driver esp_lcd_jd9165 de esp-iot-solution NO es el de este panel.
    Sustituido por el del demo del fabricante (JC1060P470C_I_W / 1_2_Lvgl_V9):
    - esp_lcd_jd9165.c/.h: secuencia de init REAL del panel (~50 comandos vs 0x11/0x29 genéricos)
    - lane_bit_rate 550 (no 750), dpi_clock 56MHz, hsync 40/160/160, vsync 10/23/12, num_fbs=1
    - Touch GT911: I2C_NUM_1, SDA7/SCL8, SIN pull-up, RST/INT en NC (como la placa pequeña)
    - Quitado Serial.setTxTimeoutMs(0)
    Display y touch VALIDADOS en hardware. UI aún en portrait original (rediseño landscape pendiente).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
    [Display.cpp, config.h, main.cpp]
2026-06-09 FEAT P4 JC1060P470C: UI completa en landscape 1024×600 + docs migración en README (2026-06-10 00:13)
    UI migrada de portrait a landscape (sin transform_rotation):
    - UIHeader: franja superior, timecode centrado, hamburguesa arriba-derecha
    - UIPage3 (VUMetros): 8 columnas — VU vertical / nombre / pan / S / M
    - UIPage3B (Faders): 8 columnas — fader vertical / nombre / pan / automode / M
    - UIPage1 (Botones): rejilla 8×4
    - UIMenu: panel a lo ancho, 4 botones en fila, slider de brillo
    - content_area bajo el header (1024×512)
    Docs: MIGRATION_NOTES.md eliminado; su contenido (corregido) movido al README del subproyecto.
2026-06-10 FIX P4: timecode beats/SMPTE refresco fluido (2026-06-10 14:06)
    needsTimecodeRedraw activado en cualquier CC 64-73, no solo en el último
    dígito. Throttle 16ms en uiHeaderUpdate() para evitar redraws en ráfaga.
    [UIHeader.cpp]
2026-06-10 FIX P4: botón BEAT/SMPT — actualización inmediata + touch fiable (2026-06-10 14:43)
    UIHeader: callback del botón actualiza s_timecode y s_tc_ghost directamente,
    sin pasar por throttle ni hasDigit. Resuelve modo que no cambiaba en pantalla.
    main: lv_tick_inc usa tiempo real (esp_timer) en lugar de 10ms fijo, y
    vTaskDelay 10ms → 5ms. Resuelve toques que no se registraban al desincronizarse
    el debounce interno del indev GT911.
    [UIHeader.cpp, main.cpp]
2026-06-10 FIX P4: indicador BEAT/SMPT read-only, controlado por Logic (2026-06-10 14:56)
    Eliminado LV_OBJ_FLAG_CLICKABLE y callback de toque del indicador de modo.
    El modo lo dicta Logic vía note 113/114 — uiHeaderUpdate() refresca el texto
    del indicador junto con el timecode cuando needsTimecodeRedraw se activa.
    [UIHeader.cpp]
2026-06-10 STYLE P4: indicador BEAT/SMPT — fondo transparente + borde+texto cian 28pt (2026-06-10 15:07)
    Fondo transparente, borde 2px cian (0x00FFFF), texto montserrat_28 cian.
    Mismo color que el timecode. Sin interactividad.
2026-06-10 STYLE P4: indicador BEAT/SMPT — fuente 28pt → 24pt (2026-06-10 15:09)
2026-06-10 STYLE P4: indicador BEAT/SMPT — fuente 24pt → 20pt (2026-06-10 15:12)
2026-06-10 STYLE P4: indicador BEAT/SMPT — fuente 20pt → 16pt (2026-06-10 15:15)
2026-06-10 STYLE P4: indicador BEAT/SMPT — caja 90×44 → 68×30, borde 2px → 1px (2026-06-10 15:22)
2026-06-10 STYLE P4: indicador BEAT/SMPT — fuente 16pt → 14pt (2026-06-10 15:25)
2026-06-10 FEAT P4: indicadores SOLO y LOOP en header (2026-06-10 15:35)
    Rude Solo (note 0x73) y Cycle/Loop (note 0x56) ahora se capturan en
    processNote() y se visualizan como indicadores en el header junto a BEAT/SMPT.
    Inactivo: dim 0x003333. Activo: SOLO naranja 0xFF6600 / LOOP verde 0x00CC00.
    Reset en GoOffline (case 0x0F). Variables globales en main.cpp + config.h.
    [UIHeader.cpp, config.h, main.cpp]
2026-06-10 FEAT P4: header reorden SMPT→LOOP→SOLO + estilos activos (2026-06-10 15:42)
    LOOP (x=88) con flechas LV_SYMBOL_LEFT/RIGHT, activo fondo COL_AUTO_LATCH.
    SOLO (x=164) activo fondo COL_SOLO_ON + texto negro.
    Ambos inactivos: fondo transparente, borde+texto dim 0x003333.
2026-06-10 STYLE P4: LOOP+SOLO — 68×30 → 44×34, más cuadrados (2026-06-10 15:48)
2026-06-10 STYLE P4: indicadores LOOP+SOLO inactivos — color 0x003333 → 0x006666 display (2026-06-10 15:54)
2026-06-10 STYLE P4: SOLO activo — COL_SOLO_ON → cian display 0x00FFFF (2026-06-10 15:58)
2026-06-10 STYLE P4: SOLO indicator — texto "SOLO" 14pt → "S" 28pt (2026-06-10 16:02)
2026-06-10 STYLE P4: SOLO activo — cian → COL_AUTO_LATCH naranja (igual que LOOP) (2026-06-10 16:05)
2026-06-10 STYLE P4: SMPT 30px → 34px — los tres indicadores comparten altura (2026-06-10 16:09)
2026-06-10 FIX P4 header: timecode centrado horizontal con lv_obj_align (2026-06-10 16:18)
    Reemplaza cálculo manual (P4_W - tw) / 2 por LV_ALIGN_TOP_MID para centrado
    robusto independiente del timing de layout en init.
    [UIHeader.cpp]
2026-06-10 FEAT P4 UIHeader: BEATS display 4 bloques independientes + SMPTE centrado (2026-06-10 18:42)
    - UIHeader: timecode SMPTE recentrado con LV_ALIGN_TOP_MID
    - UIHeader: arquitectura BEATS con 4 contenedores independientes (barras/beat/subdiv/ticks)
    cada bloque ghost+real dentro de contenedor garantiza solapamiento pixel-perfect
    ghost "0000"/""/""/""000" + real right-aligned, pad_all=0, LV_LABEL_LONG_CLIP
    - UIHeader: 3 puntos separadores en DSEG7_44 con dot_gap=12px
    - UIHeader: update BEATS extrae solo dígitos y right-justify con ceros a la izquierda
    - MIDIProcessor: formatBeatString reescrita con posiciones fijas [0-3]/[4]/[5]/[6-8]
    - SMPTE no modificado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
2026-06-10 FIX P4 UIHeader BEATS: mapeo correcto buffer→bloques (2026-06-10 19:09)
    Logic Pro envía beats en CC 64-73 con layout real:
    [0-2]=bar(3 dígitos) [3]=sep [4]=div [5]=sep [6]=beat [7-9]=ticks
    El código asumía {0,4,5,6}/{4,1,1,3} — incorrecto:
    - Bar leía 4 dígitos incluyendo separador vacío → "0010" en vez de "0001"
    - Beat leía índice 4 (div) en vez de índice 6 (beat)
    - Sub leía índice 5 (separador vacío, siempre '0')
    - Ticks leían [6-8] perdiendo el dígito ones en [9]
    Fix: starts={0,6,4,7} counts={3,1,1,3}
    "1.1.1.1" → "0001 1 1 001" ✓
    "1.2.3.159" → "0001 2 3 159" ✓
    [UIHeader.cpp]
2026-06-10 DOC MIDI.md: tabla exhaustiva MCU note numbers + mapping P4 PG1/PG2 (2026-06-10 19:09)
    Añadidas dos secciones:
    - §4.10.1: listado completo de los 116 note numbers MCU (botones canal,
    assignment, banks, automation, utilities, edición, transport, cursor,
    fader touch, LEDs de estado)
    - §9: implementación P4 — páginas de botones con mapping normal/shift
    para PG1 (32 keys) y PG2 (32 keys), enfoque Shift local en firmware,
    pendientes de decisión (UNDO/REDO, SAVE AS)
2026-06-11 FIX/FEAT P4 menú header + VU layout + paleta Logic Pro + legacy marking (2026-06-11 03:04)
    - FIX UIPage3.cpp: eliminada llamada errónea a uiMenuInit(s_page_root) que dejaba punteros dangling → menú header roto
    - FIX UIMenu.cpp: eliminada asignación prematura g_currentPage en btn_cb → objetos LVGL zombie resueltos
    - FEAT UIPage3.cpp: VU layout reordenado (SEL→MUTE→PAN→NAME→VU de arriba a abajo)
    - FEAT config.h: paleta colores estilo Logic Pro (COL_BG, MUTE/SOLO_OFF, TRACK_BG/SEL/SEP, COL_TEXT_DIM, COL_FADER_TRACK/THUMB nuevos)
    - FEAT UIMenu/UIPage3B/UIOffline: colores migrados a nuevos COL_* de config.h
    - DOC: JC4880P433C marcado LEGACY en docs/DISPLAY_P4.md, NEOTRELLLIS.md, T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
    [UIMenu.cpp, UIOffline.cpp, UIPage3.cpp, config.h]
2026-06-11 DOC CLAUDE.md: hardware activo P4 — pinout JC1060P470C + JC4880P433C separado (2026-06-11 03:08)
    - Nueva sección "Hardware activo — P4" con tabla completa: placa, display JD9165 1024×600,
    touch GT911 GPIO7/8, RS485 GPIO43/44/42, backlight GPIO23, LCD_RST GPIO27
    - JC4880P433C marcado explícitamente: NO tocar, proyecto futuro independiente con NeoTrellis
    - config.h entry actualizada: JC4880P433C = proyecto futuro, no legado
2026-06-11 SYNC P4 MIDIProcessor + RS485 con lógica refinada de S3 (2026-06-11 12:53)
    - LOGIC_PITCHBEND_MAX=14845 en config.h (normalizacion correcta faders)
    - PITCHBEND_DEADBAND=80 + lastSentPitchBend[9]: filtra ruido RS485
    - case 0x61 (AllFadersToMinimum): faders a 0 sin romper g_logicConnected
    - case 0x0C: log_v (era log_i innecesario)
    - case 0x12: guard nombre vacío para modo plugin/Atmos
    - case 0x0F: llama beginDisconnectSequence() — garantiza connected=0 a todos los slaves
    - RS485: beginDisconnectSequence() + isDisconnectComplete() portados de S3
    - RS485 _nextSlave(): ruta rápida sin cycle wait durante disconnect
    [RS485.cpp, RS485.h, config.h]
2026-06-11 FIX P4 config.h: paleta COL_* calibrada contra captura Logic Pro (2026-06-11 12:54)
    Reemplaza colores estimados por valores extraídos de pantalla calibrada.
    Añade COL_BG_PANEL, COL_BG_CELL, COL_BTN_INACTIVE para nuevos componentes UI.
    [config.h]
2026-06-11 FIX P4 config.h: fondo más oscuro, resaltado neutro (2026-06-11 13:07)
    COL_BG 0x2B→0x1A, COL_TRACK_SEL usa tono neutro 0x2B (era marrón 0x3A3020)
    [config.h]
2026-06-11 FIX P4 config.h: COL_TRACK_SEL +2 puntos a blanco 0x2B→0x3D (2026-06-11 13:11)
    [config.h]
2026-06-11 FEAT P4 UIPage3: 16 canales — arrays expandidos + layout 64px (2026-06-11 13:19)
    - NUM_CH 8→16, CH_W auto 128→64px
    - Arrays vuLevels/faderPos/states/trackNames expandidos a 16 slots
    - PAN_SZ 52→44 (cabe en columna 64px)
    - handleVUMeterDecay: loop hardcoded 8 → NUM_CH
    - Slots 8-15 en cero hasta implementar canal S3→P4
2026-06-11 FEAT P4 display 16ch: P4_CH_OFFSET=8 + VU padding (2026-06-11 14:13)
    - config.h: #define P4_CH_OFFSET 8 (slots 0-7=S3 izq, 8-15=P4 der)
    - MIDIProcessor: +P4_CH_OFFSET en vpotValues, vuLevels, vuClipState,
    vuPeakLevels, vuLastUpdateTime, vuPeakLastUpdateTime, faderPositions,
    recStates, soloStates, muteStates, selectStates, trackNames
    faderPositions: guard channel<8 para evitar acceso fuera de bounds
    - UIPage3: seg_w CH_W-16→CH_W-12, padding x+8→x+6 (+2px cada lado)
    Click handlers (VU/SELECT/MUTE): col>=P4_CH_OFFSET → midiCh=col-8
2026-06-11 FIX P4 UIPage3: VU segmentos 60px (CH_W-4, margen 2px) (2026-06-11 14:15)
    [UIPage3.cpp]
2026-06-11 FIX P4 UIPage3: VU segmentos 58px (CH_W-6, margen 3px) (2026-06-11 14:16)
    [UIPage3.cpp]
2026-06-11 FIX P4 UIPage3: VU segmentos 56px (CH_W-8, margen 4px) (2026-06-11 14:17)
    [UIPage3.cpp]
2026-06-11 FIX P4 UIPage3: VU gap entre segmentos 1px→2px (2026-06-11 14:19)
    [UIPage3.cpp]
2026-06-11 FIX P4 UIPage3: botones S/M alineados con VU (x+4, 56px) (2026-06-11 14:21)
    [UIPage3.cpp]
2026-06-11 FIX P4 UIPage3: gap entre botones S/M 4px→2px (2026-06-11 14:23)
    [UIPage3.cpp]
2026-06-11 FIX P4 UIPage3: pan bajado 3px (PAN_TOP gap 8→11) (2026-06-11 14:25)
    [UIPage3.cpp]
2026-06-11 FIX P4 UIPage3: pan bajado 2px más (PAN_TOP gap 11→13) (2026-06-11 14:26)
    [UIPage3.cpp]
2026-06-11 FIX P4 UIPage3: pan bajado 2px más (PAN_TOP gap 13→15) (2026-06-11 14:28)
    [UIPage3.cpp]
2026-06-11 FIX P4 UIPage3: botones S/M bajados 2px (SEL_TOP 4→6) (2026-06-11 14:30)
    [UIPage3.cpp]
2026-06-11 FIX P4 UIPage3: pan label estilo Logic (-64..C..+63) (2026-06-11 14:33)
    Tabla pos 0-11 → valor Logic firmado. Arc usa ±20/step (full ±100).
    [UIPage3.cpp]
2026-06-11 FIX P4 UIPage3: tabla pan corregida (paso -12 izq, +10 der) (2026-06-11 14:38)
    Valores confirmados: pos4=-24, pos8=+20. Extremos fijos -64/+63.
    [UIPage3.cpp]
2026-06-11 FEAT P4 UIPage3: VU meter lógica S2 — peak fade + clip (2026-06-11 14:52)
    - vuPeakAlpha[16] + vuPeakFadeTime[16]: estado fade por canal
    - handleVUMeterDecay: hold 1s + fade 4×25ms (portada de S2)
    - uiPage3Update VU: peak blended ON→OFF según alpha, seg11 rojo en clip
    - blendHex(): helper mezcla 0xRRGGBB con alpha 0-255
    - MIDIProcessor 0x0F: reset vuPeakAlpha=255, vuPeakFadeTime=0 en GoOffline
    [UIPage3.cpp, config.h, main.cpp]
2026-06-11 FIX P4 build: blendHex forward-decl + UIPage3B NUM_CH→P3B_CH (2026-06-11 14:55)
    - UIPage3.cpp: forward declaration de blendHex antes de uiPage3Update
    - UIPage3B.cpp: #define NUM_CH 8 → constexpr P3B_CH=8 (evita redefinición)
    [UIPage3.cpp]
2026-06-11 FIX P4 UIPage3: DECAY_INTERVAL_MS 100→500ms para evitar que VU baje durante playback (2026-06-11 15:43)
    [UIPage3.cpp]
2026-06-11 FIX P4 VU decay: inhibir durante playback con g_isPlaying (note 0x5E) (2026-06-11 15:49)
    [UIPage3.cpp, config.h, main.cpp]
2026-06-11 PERF P4 UIPage3: VU meter 192 obj LVGL → 16 obj con LV_EVENT_DRAW_MAIN (2026-06-11 15:59)
2026-06-11 FIX P4 UIPage3: cast lv_event_get_target a lv_obj_t* (2026-06-11 16:00)
    [UIPage3.cpp]
2026-06-11 FIX P4 VU: vuLastUpdateTime siempre actualizado en Channel Pressure (2026-06-11 16:08)
    Antes solo se actualizaba si el nivel subía o era 0 — señal sostenida
    no refrescaba el timestamp y el decay disparaba igualmente a los 500ms.
2026-06-11 FIX P4 VU: vuLevels sigue a Logic en ambas direcciones (2026-06-11 16:10)
    Antes solo subía — nivel descendente de Logic causaba salto max→0.
    Ahora vuLevels = normalizedLevel siempre. Peak logic independiente.
2026-06-11 FIX P4 VU: decay solo cuando DISCONNECTED + vuLevels solo sube (2026-06-11 16:18)
    Espejea comportamiento S2: durante sesión activa no hay decay.
    vuLevels solo sube desde Logic — decay maneja el descenso al desconectar.
    [UIPage3.cpp]
2026-06-11 REVERT P4 VU: lógica original restaurada, eliminado g_isPlaying (2026-06-11 16:20)
    [UIPage3.cpp, config.h, main.cpp]
2026-06-11 FIX P4 VU: DECAY_INTERVAL_MS 100→300ms (2026-06-11 16:27)
    [UIPage3.cpp]
2026-06-11 FIX P4 VU: timestamp incondicional + sin snap-a-0 en Channel Pressure (2026-06-11 16:31)
2026-06-11 FIX P4 VU: timestamp solo en nivel > 0 — decay dispara al silencio (2026-06-11 16:35)
2026-06-11 FIX P4 VU: vuLevels bidireccional (instantáneo) + vuPeakLevels para hold visual (2026-06-11 16:40)
    Bar sigue señal Logic en ambas direcciones. Peak dot retiene máximo 1s.
    Decay solo actúa cuando Logic deja de mandar señal (silencio total).
2026-06-11 DOC BUG_VU_P4.md: documenta bug LEDs VU P4 para análisis con datos reales (2026-06-11 16:42)
2026-06-11 FIX P4 VU: clearClip no sobreescribe vuLevels (2026-06-11 16:53)
    clearClip (0xF) leía vuLevels[targetChannel] sin P4_CH_OFFSET → siempre
    0.0f → barra caía a cero. Solo ocurría en subidas abruptas porque los
    transitorios rápidos clipan brevemente (0xE) y Logic envía clearClip (0xF)
    inmediatamente. Fix: clearClip solo actualiza vuClipState, rama else maneja
    nivel/timestamp/peak.
2026-06-11 FIX P4 VU: decodificación correcta SysEx 0x72 (2026-06-11 17:12)
    Canal = índice del bucle (no nibble bajo del dato). Nivel = nibble bajo
    del byte (0-11/0xE/0xF). El código anterior usaba raw&0x0F como canal
    y raw>>4 como nivel, escribiendo siempre canal 12 con level=0.
    Misma lógica clearClip que Channel Pressure.
2026-06-11 FEAT P4 header: indicador CLICK + SOLO morado (2026-06-11 17:26)
    Nota 0x59 (CLICK) mapea g_clickActive. Nuevo indicador LV_SYMBOL_AUDIO
    en header x=192 junto a BEAT/LOOP/S. SOLO activo cambia de naranja a
    morado 0xAA00CC. Reset en GoOffline.
    [UIHeader.cpp, config.h, main.cpp]
2026-06-11 FIX P4 header: revierte color SOLO a COL_AUTO_LATCH (2026-06-11 17:24)
    S no se toca — color activo vuelve al naranja original.
    [UIHeader.cpp]
2026-06-11 FIX P4 UI: MUTE/SOLO off → gris 0x3A3A3A (2026-06-11 17:30)
    COL_MUTE_OFF 0x400000→0x3A3A3A, COL_SOLO_OFF 0x333333→0x3A3A3A.
    Coherente con paleta Logic Pro.
    [config.h]
2026-06-11 FIX P4 UI: filo negro 1px en botones SOLO/MUTE off (2026-06-11 17:31)
    [UIPage3.cpp]
2026-06-11 DOC CHANGELOG: pendientes P4 — CDC arranque, GT911, CPU 360MHz, constantes portrait (2026-06-11 22:37)
2026-06-11 DOC memory/: sistema de memoria Claude en repo — 15 entradas auditadas y actualizadas (2026-06-11 22:45)
2026-06-11 DOC memory/: eliminar carpeta del repo — memoria vive en ~/.claude (2026-06-11 22:47)
2026-06-11 FIX P4: rs485.startTask() en setup() + cerrar pendientes 0x61/CDC (2026-06-11 22:59)
    - main.cpp: añadir rs485.startTask() tras rs485.begin() — task RS485 arrancaba
    - CHANGELOG: cerrar pendiente CDC (resuelto por usuario) y 0x61 (ya corregido en código)
    [main.cpp]
2026-06-11 FIX P4+S2+S3: pendientes — calibración GoOffline, DEADBAND, touch pull-up, CPU, BOUNCE, coredump (2026-06-11 23:07)
    P4 MIDIProcessor.cpp:
    - _calibPendingFrom = 0 en case 0x0F (evita reanudación calibración tras reconexión)
    - PITCHBEND_DEADBAND 80 → 150 (reduce tráfico PitchBend redundante)
    P4 Display.cpp:
    - i2c_cfg flags.enable_internal_pullup = true (fix GT911 i2c transaction failed)
    P4 platformio.ini:
    - f_cpu 400MHz → 360MHz (máximo real ESP32-P4 ES)
    P4 config.h:
    - Eliminar MENU_PANEL_H, HEADER_X, HEADER_W (constantes portrait sin uso)
    - LABELS_PG1[20]: MTRK → BOUNCE (nota 0x3E, decisión 2026-06-10)
    S2 partitions_4MB_ota.csv:
    - Añadir coredump 64K en 0x3D0000; spiffs re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
    [partitions_4MB_ota.csv, s3_extender_16MB.csv]
2026-06-11 REVERT P4 Display.cpp: quitar enable_internal_pullup — touch GT911 ya funciona (2026-06-11 23:09)
    [Display.cpp]
2026-06-11 DOC CHANGELOG: cerrar pendiente GT911 — touch funciona (2026-06-11 23:09)
2026-06-11 FIX P4 Header: VPot assignment strip + marco timecode fijo (2026-06-12 00:02)
    - config.h: ASSIGN_STRIP_H=22, CONTENT_Y=110, CONTENT_H=490, extern vpotAssignNames[8]
    - MIDIProcessor: case 0x12 captura offset 56-111 → vpotAssignNames[8] + needsHeaderRedraw
    - UIHeader: strip 8 labels VPot en pie del header (y=88, CH_W=64, COL_HEADER_BRIGHT)
    - UIHeader: s_tc_frame marco 1px radius=8 alrededor del timecode (+100w +10h)
    [UIHeader.cpp, config.h]
2026-06-12 DOC MIDI.md: §10 P4 UIHeader — barra superior persistente (2026-06-12 11:41)
    Documenta layout, botones táctiles bidireccionales (BEAT/SMPT, LOOP,
    RUDE SOLO, CLICK), asimetrías de notas MCU, timecode ghost+real,
    VPot assignment strip y navegación Bo/Vu/Fa.
2026-06-12 DOC MIDI.md §10.4: distribución scribble strip MCU→P4 (2026-06-12 11:41)
    Aclara que fila superior MCU (track names) va a la vista VU meters
    y fila inferior (parámetro VPot) va al header strip siempre visible.
2026-06-12 FIX P4 Header: beat zero-padding + marco timecode -30px (2026-06-12 12:35)
    Beat display: extrae dígitos del buffer, parsea como int, formatea
    con ceros a la izquierda (0001/0182/001). Resuelve espacios del buffer
    inicializado que corrompían posición del dígito significativo.
    Marco timecode 30px más estrecho, borde COL_HEADER_DIM, bx[0]=312.
    Stack MIDI task Core0: 4096→8192 bytes.
    [UIHeader.cpp, main.cpp]
2026-06-12 FIX P4 Header+VU: assign indicator + SOLO/MUTE gap (2026-06-12 12:45)
    Header: nuevo indicador VPot assignment (TRK/SND/PAN/PLG/EQ/INS)
    a x=244, display-only, se actualiza leyendo btnStatePG1[0..5].
    UIPage3: separación SOLO↔MUTE 2→4px.
    [UIHeader.cpp, UIPage3.cpp]
2026-06-12 FIX P4 UIPage1: recall estado botones al crear página (2026-06-12 12:46)
    Inicializar con btnStatePG1[i] en lugar de false — los botones
    reflejan el estado real de Logic al navegar a la página.
    [UIPage1.cpp]
2026-06-12 FIX P4 VPot display: P4_CH_OFFSET en UIPage3B + estado inicial arcos (2026-06-12 13:28)
    UIPage3B: todas las lecturas de arrays añaden +P4_CH_OFFSET —
    vpotValues, faderPositions, trackNames, muteStates, selectStates
    leían índices 0-7 (datos S3) en lugar de 8-15 (datos P4).
    UIPage3 + UIPage3B: pos==0 → arco en centro en lugar de full-left
    (pos=0 significa sin datos, no "izquierda máxima").
    [UIPage3.cpp]
2026-06-12 FIX P4 VPot arc: LV_ARC_MODE_NORMAL + rango 0-110 (2026-06-12 13:59)
    LV_ARC_MODE_SYMMETRICAL con value=0 producía indicador invisible (longitud cero)
    cuando el pan estaba en centro (pos=6 → pan=0). Cambiado a LV_ARC_MODE_NORMAL
    con rango 0-110 y valor = pos*10 para que el indicador sea siempre visible.
    Aplica a UIPage3 (VU page) y UIPage3B (faders page).
    [UIPage3.cpp]
2026-06-12 FIX P4 VPot arc: restaurar SYMMETRICAL + fórmula direccional (2026-06-12 14:10)
    Revertir NORMAL→SYMMETRICAL: la representación correcta crece desde el centro
    del arco hacia izquierda (pan L) o derecha (pan R), igual que el P4 antiguo.
    Para pos=6 (centro) usar value=2 en lugar de 0 para evitar indicador invisible.
    [UIPage3.cpp]
2026-06-12 FIX P4 VPot arc: pos=0 neutro en UIPage3 y UIPage3B (2026-06-12 14:25)
    pos=0 significa sin dato (Logic no ha enviado CC aún, o canal S3 sin
    datos en P4). Con la fórmula anterior daba -100 (arco full izquierda).
    Ahora pos=0 → pan=0 (arco neutro/centro), igual que pos=6 → 2 (mínimo
    visible). Corrige los 8 canales S3 en UIPage3 que siempre mostraban
    full-left al carecer P4 de datos VPot para ellos.
    [UIPage3.cpp]
2026-06-12 FIX P4 VPot arc: fórmula exacta P4 antiguo — ((pos-6)*100)/6, etiquetas L/R/C, bg 0x333333 (2026-06-12 15:06)
    [UIPage3.cpp]
2026-06-12 FIX P4 VPot arc: NORMAL mode + lv_arc_set_angles directo — bypass bug LVGL SYMMETRICAL con ángulos >360 (2026-06-12 17:05)
    [UIPage3.cpp]
2026-06-12 FIX P4 VPot arc: pan_draw_cb con lv_draw_arc directo (intento 4) + DOC CHANGELOG (2026-06-12 18:01)
    - UIPage3.cpp + UIPage3B.cpp: lv_arc_create → lv_obj_create + LV_EVENT_DRAW_MAIN
    pan_draw_cb dibuja fondo gris (135→45°) e indicador verde via lv_draw_arc directo
    Mismo patrón que vu_draw_cb (VU meter, confirmado funcionando)
    - uiPage3Update / uiPage3BUpdate: eliminado lv_arc_set_angles, solo lv_obj_invalidate
    - CHANGELOG: registro sesión — 4 intentos VPot, estado actual, causa raíz hipotética
    [UIPage3.cpp]
2026-06-12 FEAT P4 VPot: arco lv_arc (fix render) + pop-up grande interactivo + cadena trazada (2026-06-12 19:51)
    - UIPage3.cpp: arco VPot recreado con widget lv_arc (set_value/range/bg_angles
    135-405/SYMMETRICAL) — patron del P4 pequeno JC4880P433C. Render OK en HW.
    - UIVPotPopup.{h,cpp} NUEVO: pop-up modal en lv_layer_top al tocar arco (col 9-16),
    lv_arc 320px interactivo, envia CC relativo 16+strip a Logic, boton Cerrar.
    - UIPage3.cpp: zona tactil s_arc_hit[] (solo 8-15) + close en destroy.
    - main.cpp: include + uiVPotPopupUpdate() en loop.
    - MIDIProcessor.cpp: log_d->log_i en processControlChange (diag CC entrantes).
    Pendientes (ver CHANGELOG): Logic no aplica el VPot relativo (falta context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
    [UIPage3.cpp, UIVPotPopup.cpp, UIVPotPopup.h, main.cpp]
2026-06-14 FEAT AutoMode: derivación AUTO_OFF por ausencia + fix nota 79 + type-safe S2 (2026-06-14 14:35)
    S3/P4 MIDIProcessor: _autoNoteState[5] para sobrevivir refreshes masivos de Logic.
    AUTO_OFF se deriva de ausencia de notas 74-78 — sin nota dedicada.
    Nota 79 ('Automation Group' Mackie) eliminada del mapeo — nunca implica cambio de modo.
    S2 RS485Handler: comparación type-safe pktMode != currentAutoMode (elimina cast uint8_t).
    AUTOMODE.md: sección 9B con mapeo MIDI confirmado por captura real + anomalía TRIM.
    [RS485Handler.cpp, config.h]
2026-06-14 FIX S2 ruido logs: stall motor AT_TARGET + handler FADER a log_d (2026-06-14 14:41)
    Motor.cpp: stall protector resetea _stallProtectStart tras disparar y transiciona
    MOVING_TO_TARGET → AT_TARGET cuando fader toca tope físico — elimina bucle
    de reactivación + log_e cada 400ms.
    RS485Handler.cpp: log_i fader cada 500ms bajado a log_d — visible solo en VERBOSE.
    [Motor.cpp, RS485Handler.cpp, config.h]
2026-06-14 FIX S2 Motor: fader baja a 0 al desconectar Logic (2026-06-14 14:42)
    AT_TARGET no tenía lógica de goToMin — fader quedaba en posición Logic al cerrar.
    Añadido trigger GOING_TO_MIN en AT_TARGET cuando !_connected && adc > MIN+80.
    Umbral 80 > arrival threshold 60 evita bucle AT_TARGET↔GOING_TO_MIN en tope físico.
    [Motor.cpp, config.h]
2026-06-14 FIX S2 calibración: suprimir CALIB_DONE prematuro en GOING_TO_MIN (2026-06-14 15:27)
    Cuando S3 reiniciaba pero S2 seguía corriendo con _motor_phase=DONE,
    requestCalibration() entraba en GOING_TO_MIN pero buildResponse() seguía
    enviando SLAVE_FLAG_CALIB_DONE. S3 marcaba el slave como calibrado con
    MIN=0 MAX=0 antes de recibir datos reales → _motor_adcSpan=0 → motor inmóvil.
    Fix: pendingNewCalib flag en buildResponse() detecta DONE+GOING_TO_MIN
    y suprime CALIB_DONE hasta que la nueva calibración complete de verdad.
    [RS485Handler.cpp, config.h]
2026-06-14 FIX S3 calibración: rechazar CALIB_DONE con MIN=0 MAX=0 y reintentar (2026-06-14 15:27)
    Guard defensivo en _handleResponse(): si calibDone llega pero calibratedMin=0
    o calibratedMax<=calibratedMin, el slave NO se marca como calibrado — se
    incrementa calibRetries y se espera un nuevo ciclo con grace period.
    Complementa el fix de S2 (fd50ed0): S2 no envía CALIB_DONE prematuro,
    S3 tampoco acepta datos inválidos aunque lleguen.
    [RS485.cpp]
2026-06-14 FIX S2 Motor: resetear ventana delta al salir de GOING_TO_MIN/calibFlow (2026-06-14 15:39)
    _deltaWindowRef no se actualizaba durante GOING_TO_MIN (early return en
    setADCDelta). Al llegar al tope físico y pasar a AT_TARGET, la primera
    llamada comparaba currentADC=20 vs _deltaWindowRef=13816 → delta 13796
    >> umbral 30 → falsa detección touchState=1.
    Fix: flag _prevInCalibFlow detecta el primer ciclo tras salir de calibFlow
    y fuerza reset de ventana (_deltaWindowRef = currentADC) saltando detección.
    [Motor.cpp, config.h]
2026-06-14 FIX S2: desactivar FaderTouch completamente — capacitivo no fiable (2026-06-14 18:30)
    init/callbacks/update comentados en main.cpp. Solo estaba desactivado
    de setADCDelta() (motor), seguía corriendo y encendiendo LED_BUILTIN.
    [config.h, main.cpp]
2026-06-15 FIX S2 ADS1115: I2C 400kHz + blink LED si no se encuentra (2026-06-15 12:27)
    - FaderADC: I2C a 400kHz Fast Mode pasando freq en begin() — setClock() posterior
    era ignorado por warning "Bus already started in Master Mode"
    - FaderADC: añadir _adsOk / isOk() para exponer resultado de inicialización
    - main: blink no-bloqueante LED GPIO15 a 500ms si ADS1115 no responde en boot
    [FaderADC.cpp, FaderADC.h, config.h, main.cpp]
2026-06-29 FEAT ExPressif: nuevo proyecto USB MIDI XY controller (2026-06-29 20:13)
    - Proyecto P4_JC4880P433C reconvertido de iMakie Mackie MCU a ExPressif
    - UI LVGL portrait 480×800 → hardware landscape 800×480
    - UIBoot: splash screen con logo AITEC desde LittleFS + LV_USE_TJPGD
    - UIKaoss: pad táctil 8×8 grid, dots celda-2px, apagados en idle
    - Toque: d=0→100%, d=1→75%, d=2→35%, d=3→15%, decay con el tiempo
    - HOLD: dot central fijo al 100%, adjacentes decaen
    - Strips de botones se iluminan al pulsar (×3 brightness)
    - MIDIOut: eliminado handshake Mackie (sendMIDIBytes, midiOutInit)
    - RS485/: carpeta eliminada, protocolo Mackie eliminado
    - USB: identificación "ExPressif V1" / "AITE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
2026-06-29 ExPressif: CC presets Wavestation — MOD/JOY/FILT/FX (2026-06-29 20:47)
    - KaossPad reescrito: notas eliminadas, sistema CC presets (4 pares)
    - Presets: MOD(CC1/2), JOY(CC16/17), FILT(CC74/71), FX(CC91/93)
    - JOY mapea joystick X/Y Wavestation; MOD mod wheel/controller 2
    - UIKaoss: sendNote eliminado, SCALE→nextPreset, PANIC→CC64 center reset
    - Validado en hardware: MIDI Monitor confirma output correcto
    [UIKaoss.cpp]
2026-06-29 ExPressif: strips botones dim/bright por estado (2026-06-29 20:57)
    - Strips idle en color oscuro por botón: HOLD→332200, TAP→0A0F18, SCALE→002200, PANIC→330000
    - Strips al pulsar: ×3 brillo del accent (HOLD→FFaa00, TAP→00AAFF, SCALE→00AA44, PANIC→FF0000)
    - HOLD ON: strip fijo en accent; HOLD OFF: strip en dim
    - s_dim_cols[4] nuevo array; make_btn acepta dim_col; strip_set_lit usa dim en release
2026-06-29 ExPressif: eliminar Serial.begin() — USB CDC bloqueaba boot (2026-06-29 21:28)
    Serial.begin() en ESP32-P4 USB OTG espera a que el host abra el puerto.
    log_i usa UART0 por hardware, no necesita Serial.
2026-06-29 ExPressif: README — grilla 8×8 dots y scroll 'ExPressive' (2026-06-29 22:19)
2026-06-30 ExPressif: UIBank con tabla JV-2080, selector banco y NeoTrellis (2026-06-30 22:40)
    Nuevos archivos:
    - UIBank.cpp/h: pantalla Bank con 3 pestañas (FAV / Sonidos / Canal MIDI)
    - Tab 0 (FAV): tileview 16 slots/página, recall de favoritos via NVS
    - Tab 1 (Sonidos): browser JV-2080 — 3 patches/página, montserrat_16 nombres completos
    - Selector de banco (USER/PR-A/PR-B/PR-C/GM/PR-E) en franja inferior
    - lv_btn_create + tiles non-scrollable para clickabilidad correcta
    - Tab 2 (Canal MIDI): selector estilo S2 (∧ número ∨), rango 1-16
    - JVPatches.cpp/h: 768 patches Roland JV-2080 en flash (USER+PR-A..PR-E+GM)
    - NeoTrellis.cpp/h: driver 2× seesaw 4×4, long-press k=4 (≥600m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
    [JVPatches.cpp, JVPatches.h, MIDIOut.cpp, MIDIOut.h]
2026-06-30 ExPressif: UIBank Sonidos — grid 5×2 con montserrat_16 (2026-06-30 22:43)
    Tab Sonidos: 10 patches/página (5 filas × 2 cols) en lugar de 3/página.
    Botón 82px LVGL x → label width=76 → montserrat_16 (~10px/char) → 7-8 chars.
    lv_btn_create + tile non-scrollable mantienen clickabilidad en tileview.
2026-06-30 ExPressif: UIBank memoria de selección + guardar favoritos (2026-06-30 22:47)
    Memoria de selección:
    - Tab 1 Sonidos: patch activo resaltado en azul (0x003366), persiste en NVS (lm/ll/lp)
    Al abrir Bank restaura banco y patch del último uso
    - Tab 0 FAV: slot activo resaltado en azul, se actualiza en cada recall
    Guardar favorito:
    - Long-press (≥400ms) en cualquier patch de Tab 1 → guarda en Tab 0 como siguiente slot
    Guarda: sintetizador actual, canal MIDI activo, msb/lsb/pc, nombre del patch
    Botón se pone verde como confirmación visual
    Tab 0 se reconstruye inmediatamente con el nuevo favorito
    Fix: fav_build_tiles usa lv_btn_create + tiles non-scrollable (igual que son_build_t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
    [UIBank.cpp]
2026-06-30 ExPressif: fix cast lv_event_get_target() → lv_obj_t* (2026-06-30 23:02)
    lv_event_get_target() devuelve void* en esta versión de LVGL.
    Cast explícito en fav_btn_cb, son_patch_cb y son_patch_long_cb.
    [UIBank.cpp]
2026-07-01 ExPressif: UIBank Sonidos/Favoritos — lazy-build, favoritos, canal MIDI persistente (2026-07-01 21:49)
    Tab Sonidos:
    - Combo "BANCO:NNN Nombre" en una fila (montserrat_18, fix LONG_DOT que requiere alto fijo)
    - Orden de filas invertido (arriba→abajo en vez de abajo→arriba)
    - Círculo naranja de favorito a la izquierda del texto (antes arriba)
    - Ciclo de 3 pulsaciones sobre el patch seleccionado: guardar favorito → quitar favorito
    - Lazy-build del tileview (solo página activa ±1, antes ~260-390 widgets rotados vivos a la vez → tacto lento)
    Tab Favoritos: mismo lazy-build y fix de orden de filas.
    FavStore: favMarkBank/favFindIndex (chequeo masivo/puntual de favoritos),
    favSaveMidi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
    [UIBank.cpp, config.h, main.cpp]
2026-07-02 ExPressif: toggle Patch/Performance JV-2080, canal por modo — bloqueado (2026-07-02 18:37)
    Toggle Patch↔Performance con toque simple en tab "SON" (antes long-press,
    no detectado de forma fiable). Canal MIDI sincronizado al modo activo
    (Patch=12/Performance=1) en toggle manual y recall de favoritos, persistido
    en NVS. Device ID del JV-2080 extraído a constante nombrada JV2080_DEVICE_ID
    en config.h.
    Sin resolver: el JV-2080 físico no cambia de modo pese a SysEx verificado
    byte a byte y Device ID de fábrica probado. Ver entrada 🔴 Alta en
    CHANGELOG.md Pendientes.
    Claude-Session: https://claude.ai/code/session_01LK4pQaiQP2bJmfyqc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
    [JVPatches.cpp, JVPatches.h, MIDIOut.cpp, MIDIOut.h, UIBank.cpp, config.h]
2026-07-04 ExPressif: rediseño Bank (grid 2x4 + trios NeoTrellis), fix favoritos, Triton (2026-07-04 21:00)
    Rediseña UIBank para touch mas ligero: grid unificado 2x4=8 items/pagina en
    las 3 tabs, sin lv_tileview (paginacion solo NeoTrellis por columnas),
    construccion diferida por tab. NeoTrellis pasa a mapeo por trios de 3 teclas
    contiguas = 1 sonido, con LEDs sincronizados. Performances ocupa el hueco de
    la tab "Canal MIDI" eliminada.
    Corrige bug real: favDelete() no decrementaba el contador NVS ni compactaba
    huecos, asi que ciclos de prueba marcar/desmarcar empujaban los favoritos
    nuevos fuera de las paginas visibles. Fix cosmetico del punto de favorito
    (mas grande, menos pegado al borde) y tipogr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
    [MIDIOut.cpp, MIDIOut.h, TritonPatches.cpp, TritonPatches.h]
2026-07-12 ExPressif: MOTIF-RACK + TG55, canal MIDI fijo, selección directa synth (2026-07-12 17:49)
    - Nuevos synths con datos: MOTIF-RACK (8 bancos, 1024 voces) y TG55
    (Preset, 64 voces, sin Bank Select verificado — solo Program Change).
    - Fix bug real: Bank Select MSB de MOTIF-RACK era 0x63 (99 decimal) en vez
    de 0x3F (63 decimal, verificado contra MOTIFRACKE2.pdf p.46) — por eso
    nunca cambiaba de banco pese a canal/orden/timing correctos.
    - Canal MIDI fijo a 1 para todos los synths (revierte el forzado
    Patch=12/Performance=1 del JV-2080) — Logic decide el canal por track,
    no el firmware.
    - NeoTrellis: selección directa de synth en L8,9,10,12,13,14 (solo modo
    Kaoss) — segunda pu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
    [MIDIOut.cpp, MIDIOut.h, MotifPatches.cpp, MotifPatches.h, TG55Patches.cpp]
2026-07-14 ExPressif: sistema de memorias Kaos (20 slots NVS, canal por synth), color por synth extendido, brillo L2/L6, metrónomo L5 (2026-07-14 02:24)
    Kaos pad — reemplaza los 4 presets fijos en flash (compartidos por todos
    los synths) por 20 memorias por synth, editables desde pantalla:
    - kaoss/KaosParams.h/.cpp: catálogo de parámetros MIDI nombrados por synth
    - nvs/KaosStore.h/.cpp: kaos_slot[synth][0-19]={ccX,ccY,configured} + canal
    MIDI único por synth (kaos_channel[synth]) — corregido en vivo, el primer
    diseño lo guardaba por slot
    - kaoss/KaossPad.h/.cpp: sin catálogos const, cachea slot+canal activos
    - neotrellis/NeoTrellis.cpp: L3/L7/L11/L15+R0-R15 = 20 teclas de selección
    dir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
2026-07-14 ExPressif: fix metrónomo (filtro CIN dejaba L5 sin parpadear) + BPM persistente en pantalla (2026-07-14 02:55)
    Fix — L5 no se iluminaba pese a llegar MIDI Clock real: midiClockPoll()
    filtraba paquetes por CIN del header USB-MIDI (0xF, "Single Byte"),
    pero distintos hosts/drivers son inconsistentes empaquetando mensajes
    realtime (algunos usan CIN 0x5). Se compara pkt.byte1 directamente
    contra 0xF8/0xFA/0xFB/0xFC — seguro porque un byte de datos MIDI nunca
    vale ≥0x80. De paso, s_running se activa con el primer Clock recibido,
    no solo con Start/Continue.
    Nuevo: BPM calculado por el intervalo real entre negras consecutivas
    (midiClockGetBPM()), persistente — ya no se resetea a 0 en Stop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
    [MIDIClock.cpp, MIDIClock.h, UIKaoss.cpp]
2026-07-20 Fix cadena target Logic→S2: PB_MAX 16383, cooldown STALL, recalib fantasma, AutoMode SysEx (2026-07-20 20:56)
    NO RESUELTO — fixes aplicados sin validación end-to-end en hardware, ver CHANGELOG Pendientes.
    - config.h: LOGIC_PITCHBEND_MAX 14845→16383 (confirmado MIDI Monitor: Logic manda 14-bit completo)
    - RS485.cpp/.h: nuevo lastRawPitchBend + _recomputeFaderTarget(), recalcula target tras
    calibración con el rango real en vez de esperar el próximo PitchBend
    - MIDIProcessor.cpp: case 0x0E ahora reenvía AutoMode a rs485.setAutoMode() (antes solo
    actualizaba caché local, el slave podía quedarse atascado en el último modo por notas)
    - Motor.cpp/.h: isPendingCalib() expu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
    [Motor.cpp, Motor.h, RS485.cpp, RS485.h, RS485Handler.cpp, config.h, protocol.h]
2026-07-22 S2 dueño único de calibración y mapeo PB↔ADC; S3 pasa a passthrough (2026-07-22 11:45)
    Migra faderTarget/faderPos a PitchBend 0-16383 de extremo a extremo en
    ambos sentidos: S2 gana _pbToADC() + EMA propio, S3 elimina toda la
    máquina de calibración/reintentos/remapeo ADC y campos huérfanos de
    ChannelData. Corrige 4 bugs encontrados en validación de banco (V1/V2):
    pérdida de _pendingCalib, asimetría PWM en GOING_DOWN, bucle STALL con
    target lejano, falso touch en AT_TARGET.
    P4 queda incompatible con este firmware S2 hasta portar la Fase 6
    (deuda pendiente documentada en CHANGELOG). V3-V8 de validación en
    banco siguen pendientes.
    Detalle completo por fase: CHANGELOG.md sesión 20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
    [Display.cpp, FaderADC.cpp, Motor.cpp, Motor.h, RS485.cpp, RS485.h, RS485Handler.cpp, config.h]
2026-07-30 Default AutoMode boot READ, boot P4 USB primero, fix LVGL SD, rig S3 8 slaves (2026-07-30 18:09)
    - S2/S3/P4: default AutoMode al boot cambia de OFF a READ; nuevo guard en
    S2/RS485Handler.cpp para que TRIM no saque al S2 de READ (2026-07-30)
    - P4/main.cpp: USB.begin()+MIDI.begin() pasan a ser los primeros pasos del
    setup(), antes de LittleFS/Display — evita perder el handshake si Logic ya
    está abierto al arrancar (2026-07-26)
    - P4/remove_lvgl_asm.py: elimina lv_fs_arduino_sd.cpp de LVGL — el LDF de
    PlatformIO arrastraba la librería SD del framework (ff.h no empaquetado
    para esp32-p4), rompiendo el build (2026-07-26)
    - S3/config.h: NUM_SLAVES 1→8, rig completo de producción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
    [Display.cpp, RS485.cpp, RS485Handler.cpp, config.h, main.cpp, remove_lvgl_asm.py]
2026-07-30 S2: sincroniza nombre de package-lock.json con package.json (2026-07-30 18:12)
    Claude-Session: https://claude.ai/code/session_014c1sJjJFVah4Rg2hWxSMoz
2026-08-02 S2: número de track más grande/blanco en splash + fix % real en pantalla OTA (2026-08-02 14:27)
    Splash: "Track N" pasa a FreeSans24pt7b blanco (antes 12pt gris), reposicionado
    para no solapar con la línea de FW. OTA: onOTAProgress() ahora redibuja el %
    en pantalla (antes solo Serial), corrigiendo un bug de ElegantOTA en modo
    síncrono que hacía que el % calculado saliera siempre ~100% (usaba
    upload.totalSize, acumulativo, en vez del Content-Length real de la petición).
    Claude-Session: https://claude.ai/code/session_015KTT8RY4D5eRk3cmyioDtv
    [Display.cpp, Otamanager.cpp, config.h]
2026-08-07 Fix identificación MCU S3 (handshake en bucle) + fixes Motor.cpp S2 + splash rediseñada (2026-08-07 20:06)
    - S2 Motor.cpp: elimina confusión de dominio ADC/PitchBend en setTarget()/
    calibración que producía targets inalcanzables (slaves 5/7/8 subían al
    tope sin parar); arma la protección STALL también contra una posición
    ya parada, no solo tras el primer movimiento detectado.
    - S3: DEVICE_FAMILY de la rama DEVICE_S3_EXTENDER estaba copiado por error
    de DEVICE_P4_MASTER (0x14 en vez de 0x15) en config.h, y las respuestas
    de Device Query/Host Connection Query en MIDIProcessor.cpp usaban 0x14
    hardcodeado — el S3 nunca se identificaba ante Logic como extender
    distinto de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
    [ButtonManager.cpp, Display.cpp, Display.h, Motor.cpp, RS485.cpp, RS485Handler.cpp, config.h]
2026-08-13 S2: fix signo/doble-conteo encoder, calibración con jitter+retry, LEDs azul/splash tras SAT y desconexión (2026-08-13 10:46)
    - Encoder.cpp: signo invertido (derecha=+1, coincide con ENCODER.md)
    - SatMenu.cpp: fix runaway (Encoder::reset() ausente en SAT) y doble-conteo
    por clic (pendingEvents off-by-one); quitado autostart de calibración en
    MOTOR_CALIB
    - RS485Handler.cpp: encoderDelta se enviaba ×4 de más a S3 (sin dividir por
    las 4 transiciones por muesca)
    - main.cpp/config.h: jitter aleatorio 0-2s antes de autocalibración de boot,
    anti-cascada de arranque simultáneo de motores
    - Motor.cpp: timeout de calibración ahora reintenta (hasta CALIB_MAX_RETRIES,
    antes iba directo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
    [ButtonManager.cpp, ButtonManager.h, Display.cpp, Encoder.cpp, Motor.cpp, RS485Handler.cpp]
2026-08-13 S2: reordena menú SAT>Motor, quita Motor ON/OFF, fix SAT se abría solo al boot (2026-08-13 11:01)
    - SatMenu.cpp: menú Motor reordenado (PWM Max, PWM Min, Calibrar, Test Mode),
    quitado "Motor ON/OFF" (comprobado: el toggle no tenía efecto real, nada
    en firmware leía _cfg.motorDisabled)
    - config.h + ButtonManager.cpp: ventana de gracia BOOT_INPUT_SETTLE_MS=1000
    tras boot en REC/encoder — corrige regresión del commit anterior donde el
    SAT se abría solo al arrancar sin pulsar nada. Causa raíz: Button2 es un
    objeto global cuyo pinMode() corre en init estático antes de setup(), un
    glitch eléctrico del pin en esa ventana se registraba como pulsación real
    Documentación: CH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
    [ButtonManager.cpp, SatMenu.cpp, config.h]
2026-08-13 S2: hold corto real en REC (400ms) para abrir SAT, sube ventana de gracia boot a 2s (2026-08-13 11:06)
    - config.h: SAT_OPEN_HOLD_MS=400 (nuevo), BOOT_INPUT_SETTLE_MS 1000→2000
    - ButtonManager.cpp: _onRecReleased() usa Button2::wasPressedFor() — solo
    abre el SAT si la pulsación duró >=400ms, filtra toques/rebotes breves en
    cualquier momento (no solo en boot). Encoder sin hold propio (se dispara
    en press, no en release) — cubierto solo por la ventana de boot ampliada.
    Confirmado por el usuario: con el hold original de 3s este glitch nunca se
    disparaba, motivando reforzar el fix anterior en vez de dejarlo solo en la
    ventana de boot.
    Documentación: CHANGELOG.md (sesión 2026-08-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
    [ButtonManager.cpp, config.h]
2026-08-13 S2: jitter en goToMin, fix frenado fino, apagado splash por inactividad | S3: fix Bug B3 (2026-08-13 12:04)
    - config.h + Motor.cpp: GOTOMIN_JITTER_MAX_MS=2000 — goToMin() (MASTER
    ABSOLUTO si !_connected) también anti-cascada, no solo la autocalibración
    de boot. Cubre encendido simultáneo del rig y desconexión en caliente de
    Logic. Correlacionado en banco con ráfagas de ID MISMATCH/CRC ERROR en S3.
    - Motor.cpp (_positionTick): fix denominador en el frenado fino — usaba
    _motor_adcSpan (~26000) en vez de POSITION_CRUISE_ERR (2000), causando
    PWM casi plano en _pwm_min durante todo el tramo final en vez de rampa
    progresiva. Causaba overshoot hasta tope físico en movimien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
    [Display.cpp, Motor.cpp, config.h]
2026-08-13 S2/S3: rampa cuadrática de frenado + causa raíz real de faders huérfanos (falso touch) (2026-08-13 12:33)
    - Motor.cpp (_positionTick): rampa lineal → cuadrática — el fader rebotaba
    sobre el target con la rampa lineal de la sesión anterior; la cuadrática
    mantiene el empuje al entrar en la zona de frenado pero decae mucho antes
    y más fuerte cerca del target.
    - MIDIProcessor.cpp (processPitchBend): refinado el fix del Bug B3 — el
    grace period bloqueaba TODO reenvío, dejando huérfanos los faders que de
    verdad necesitaban corregirse a 0 al cerrar proyecto. Ahora compara contra
    la posición real conocida del slave (rs485.getChannel().faderPos) y solo
    bloquea si el fade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
    [Motor.cpp, config.h]
2026-08-13 S2: spike guard, umbral touch AT_TARGET, LEDs con apagado splash | S3: log AUTOMODE, baud revertido (2026-08-13 14:25)
    - Motor.cpp (setADC): quitado _motor_manualTouchDetected del bypass del spike
    guard del ADC — se desactivaba justo en el instante de más ruido eléctrico
    (motor frenando fuerte tras un falso touch por rebote).
    - main.cpp (_satWiFiOta): LEDs se apagan explícitamente antes de activar OTA
    — el camino nuevo (clic encoder en splash) no pasaba por el apagado que el
    SAT hacía implícitamente.
    - config.h (MANUAL_TOUCH_AT_TARGET_THRESHOLD 30→70): hallazgo central de la
    sesión — el umbral estaba dentro del ruido ADC real medido en banco (~28
    cuentas), causa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
    [Display.cpp, Motor.cpp, RS485.cpp, config.h, main.cpp]
2026-08-13 S2: filtro ADC centralizado, PWM fino separado del arranque, elimina spike guards, Logic fuente de verdad AutoMode | S3: debounce anti-flash nombres de pista (2026-08-13 16:13)
    Claude-Session: https://claude.ai/code/session_01LZT6th76dzvhRaEcpBfiWg
2026-08-13 P4: comentario de referencia en initDisplay() sobre reset_gpio_num de prueba (2026-08-13 16:16)
    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
    [Display.cpp]
2026-08-16 S2: elimina touch por delta ADC, rediseña reporte fader a Logic (SLAVE_FLAG_REPORT_FADER) | S3: fix guard familia P4, AutoMode via notas 74-78 (DEVICE_FAMILY=0x14), reset READ en desconexión (2026-08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
    Claude-Session: https://claude.ai/code/session_01TGndTgRbM8MmuVp9vEN33S
    [Display.cpp, Motor.cpp, Motor.h, RS485Handler.cpp, config.h, main.cpp, protocol.h]
2026-08-16 S3/P4: nuevo enlace serie S3↔P4 (Serial2) para datos de canal + heartbeat (2026-08-16 21:24)
    S3 reenvía nombre de pista, REC/MUTE/SOLO/SELECT y vúmetros de sus 8 canales
    al P4 por un UART dedicado (independiente del RS485 propio de cada MCU),
    alimentando las columnas 0-7 de la pantalla del P4 (reservadas desde antes
    por P4_CH_OFFSET pero nunca usadas). El P4 envía heartbeat (PING/PONG) para
    detectar si el S3 deja de responder. Validado en banco: boot OK, heartbeat
    sin pérdidas, datos de canal visibles en pantalla. Detalle: docs/S3LINK.md.
    Claude-Session: https://claude.ai/code/session_01KPEEhFMTMumSHKSgJi3XNq
2026-08-16 S3: brillo PWM transporte, fix LED fantasma REC, fix botonera lenta (core FreeRTOS), fix LEDs RW/FF/STOP | Poda READMEs P4/S3 a docs/ | Diseño S3LINK SELECT remoto (2026-08-16 22:44)
    - S3: Transporte.cpp/.h — initPins() temprano en setup() para minimizar ventana
    de GPIO flotante (fantasma tenue en LED REC al boot); brillo PWM ajustable
    en los 5 LEDs (TRANSPORT_LED_BRIGHTNESS=50, config.h); LEDs RW/FF añadidos a
    setLedByNote() (antes case 97 inexistente, sin case 91); LED STOP encendido
    localmente al pulsar el botón físico (confirmado con MIDI Monitor que Logic
    no manda feedback fiable de la nota 93) tras dos intentos fallidos con esa
    nota, documentados y revertidos.
    - S3: m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
    [Transporte.cpp, Transporte.h, config.h, main.cpp]
2026-08-18 P4+S3: serial único en handshake MCU (estabilidad dos unidades) | P4: fix lag timecode en vista VU meters (2026-08-18 15:41)
    - P4/S3: cada unidad responde al sondeo 0x00 con serial ASCII propio
    (AITEC-M / AITEC-X) + challenge, en vez del placeholder idéntico
    que impedía a Logic distinguirlas con ambas conectadas a la vez.
    Version reply real de 5 bytes ("V1.00"). Nueva rama 0x02->0x03
    (confianza, sin validar challenge) como salvaguarda.
    - S3: DEVICE_FAMILY/VERSION_REPLY_CMD revertidos 0x14->0x15 (config.h)
    — el experimento de identificarse como Main Unit coincidía con el
    bug de serial idéntico de arriba. AutoMode del Extender queda
    pendiente de un brief separado.
    - P4: nu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
    [S3Link.cpp, UIPage3.cpp, config.h, main.cpp]
2026-08-18 P4+S3: detección física USB (tud_mounted) + firma faders+0x21 para cierre real de Logic (2026-08-18 20:28)
    Reconexión en caliente (VU/botones no volvían) ya no depende de timeout por
    silencio MIDI - checkUsbLink() usa el estado real de TinyUSB. Además, ninguna
    de las dos unidades detectaba el cierre de Logic: Logic manda faders-a-0
    seguido de 0x21 (GoOnline), y case 0x21 reconectaba siempre, deshaciendo la
    desconexión que la heurística de faders acababa de marcar. Nueva ventana
    DISCONNECT_CONFIRM_WINDOW_MS trata esa combinación como confirmación de
    cierre en vez de reconexión.
    Claude-Session: https://claude.ai/code/session_01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
2026-08-18 S3: porta fix de reconexión (connectedSinceTime incondicional) + guard LEDs transporte (2026-08-18 20:43)
    connectedSinceTime en case 0x21 ya no dependía de que logicConnectionState no
    estuviera CONNECTED — mismo bug ya corregido en P4 esa misma noche. Un corte
    USB físico dejaba el estado congelado en CONNECTED (ningún byte MIDI lo
    cambia), así que al reconectar el guard saltaba el bloque entero y la
    reconexión en caliente no recuperaba VU/botones. Ahora se refresca siempre.
    Además, LED de STOP quedaba encendido tras desconectar: Note-Off residuales
    de la ráfaga de cierre de Logic llegaban después de setAllLedsOff() y
    volvían a encenderlo (STOP es inverso de PLAY en setLedByNote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
2026-08-18 CHANGELOG: documenta porteo S3 (reconexión + LED STOP) validado + diagnóstico LED REC fantasma (2026-08-18 20:49)
    Sesión de validación en banco del commit 17eb24e / 25b7601. LED REC fantasma
    desaparece al desconectar ATX o USB del P4 — realimentación eléctrica por
    tierra compartida (S3LINK GND común), no bug de firmware. Documentado sin
    cambio de código, hardware fuera de alcance del repo.
    Claude-Session: https://claude.ai/code/session_0162f3BmFyKGQNqGVnNRacCu
2026-08-18 README: documenta LED REC fantasma S3 como hardware (ground loop) + propuestas de solución (2026-08-18 20:5x)
    Sección nueva "Known Hardware Issues" — diagnóstico confirmado en banco
    (desaparece al desconectar ATX o USB del P4, no depende de firmware).
    Ninguna propuesta aplicada — decisión del usuario, directiva hardware
    bloqueado del proyecto.
    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
2026-08-18 P4: elimina UIPage3B + simplifica menú hamburguesa a Reiniciar + slider vertical (2026-08-18 21:06)
    UIPage3B ya no era necesaria (petición del usuario) — borrada junto con todo
    su cableado (main.cpp taskCore1, config.h, pestaña "Fa" del header). El menú
    hamburguesa pierde los botones de vista Botones/VUMetros/Faders (redundantes
    con el header Bo/Vu) y queda solo con Reiniciar + el slider de brillo, ahora
    vertical (girado 90° a la izquierda respecto al original horizontal).
    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
2026-08-18 P4: quita el título "General" del menú hamburguesa (2026-08-18 21:10)
    Resto de cuando el panel tenía más contenido — con solo Reiniciar + brillo
    no aporta nada. Retirado junto con el separador; Reiniciar y el slider
    suben para ocupar el hueco.
    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
2026-08-20 S2/S3/P4: instrumentación RS485+display, fixes de motor/conexión/protocolo (2026-08-20 19:22)
    - S2 main.cpp/Display.cpp: instrumentación micros() del loop, redraw total y
    splash screen (BRIEF_A extendido) — localiza el bloqueo del bus RS485 en el
    redraw de display, no en el orden onMasterData/buildResponse/sendResponse.
    - S2 LovyanGFX_config.h: SPI del display 10MHz→80MHz — fillScreen() de ~110ms
    a ~14ms, redraw total de ~244ms a ~43ms.
    - S2 config.h/Motor.cpp: POSITION_FINE_PWM_K 0.5→0.2 + timeout STALL ×4 en zona
    de frenado fino — corrige falso STALL sistemático justo donde Logic pide
    parar el fader (PWM insuficiente en la aproximación final, no atasco físico).
    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
    [ButtonManager.cpp, Display.cpp, LovyanGFX_config.h, Motor.cpp, S3Link.cpp, UIOffline.cpp, config.h]
2026-08-23 P4+S3: detección de cierre silencioso de Logic Pro + S2: reinserción fix anti back-feed OTA WiFi (2026-08-23 11:04)
    Logic (USB conectado) no siempre manda 0x0F ni faders-a-0 al cerrar (Cmd+Q) —
    nueva firma basada en blanqueo de los 8 nombres de canal sin nombres reales
    posteriores dentro de CLOSE_CONFIRM_WINDOW_MS, implementada en paralelo en
    P4 y S3 (checkLogicCloseSignature()). Incluye también FW_REVISION 56 (S2)
    y CHANGELOG con ambas sesiones (2026-08-21 OTA back-feed, 2026-08-23 cierre Logic).
    Claude-Session: https://claude.ai/code/session_01MYDzPwAKzdwwwGY5s8CCLK
    [Otamanager.cpp, config.h, main.cpp]
2026-08-23 P4+S3: GoOffline vía S3Link + revierte cierre silencioso | S2: menú SAT Motor simplificado, sync WRITE inicial (2026-08-23 14:23)
    P4: revertida la detección de "cierre silencioso de Logic" (checkLogicCloseSignature,
    commit 9f98e83) por fallo en banco. Nuevo mecanismo: cuando P4 detecta la desconexión
    de Logic (0x0F, heurística de faders, checkUsbLink), lo notifica al S3 por una nueva
    trama S3LINK_TYPE_GOOFFLINE en el enlace S3Link (Serial2).
    S3: eliminada su propia detección de cierre silencioso (redundante); ahora confía en
    el GoOffline reenviado por el P4 (forceLogicDisconnect(), reutilizado del antiguo
    case 0x0F). Fix de framing en S3Link::_feed() — el parser solo reconocía PIN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
    [Display.cpp, RS485Handler.cpp, S3Link.cpp, S3Link.h, SatMenu.cpp, SatMenu.h]
2026-09-27 P4: elevador de pantalla (módulo Elevator, GPIO 45-47) + NUM_SLAVES=6 + red anti-inanición RS485 | S2: test SAT Tiempo Min/Max v2 usa calibración real (2026-09-27 14:33)
2026-10-11 ExPressif: reposo (L0), HOLD a L5, brillo escala NeoTrellis, popup de preset y secuencia matrix azul (2026-10-11 19:53)
    - Reposo: L0 o 5 min de inactividad apagan pantalla y NeoTrellis; despierta con L0 o touch (toque descartado). No duerme con MIDI Clock activo. Latido de L0 fluido (seno + sigma-delta 200 Hz).
    - HOLD pasa a L5; L0 hereda metrónomo visual.
    - L2/L6 escalan tambien los NeoTrellis (incl. Bank abierto, cache de pagina); fix repintado al despertar con Bank abierto.
    - Popup de preset (PRESET n + nombres X/Y, 2,4 s) en UIPresetPopup.
    - Secuencia de encendido matrix azul (izq->der, lenta, 3 s, solo al arrancar).
    - Docs: NEOTRELLLIS.md §7-7.3 y CHANGELOG. Pendiente: ilustracion de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
2026-10-12 ExPressif: reposo, modos ExPressif/Lights, Banco por instrumento y WiFi (C6) con control WLED Fase 1 (2026-10-12 15:19)
    - Reposo: L0 o 5 min de inactividad apagan pantalla y NeoTrellis; despierta con L0 o touch. Latido fluido en L0.
    - L1 = boton de funcion: alterna modos ExPressif <-> Lights (PANIC retirado); L5 = HOLD; brillo L2/L6 escala los NeoTrellis; popup de preset; secuencia matrix azul de encendido.
    - Banco: memoria del sonido exacto por instrumento (Sonidos y Performances) en NVS (bls/blc/sab).
    - WiFi por el ESP32-C6 (esp-hosted, pines por defecto del core): tarea WLED en Core0, lectura de los dos WLED validada en banco.
    - Pantalla de SSID y clave con barrido de redes y teclado en p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
